420-enghighneering/projects-kicad/PRJ-003 - Mu-Tron Phasor II/#000-000 - Final Assembly/Untitled.png

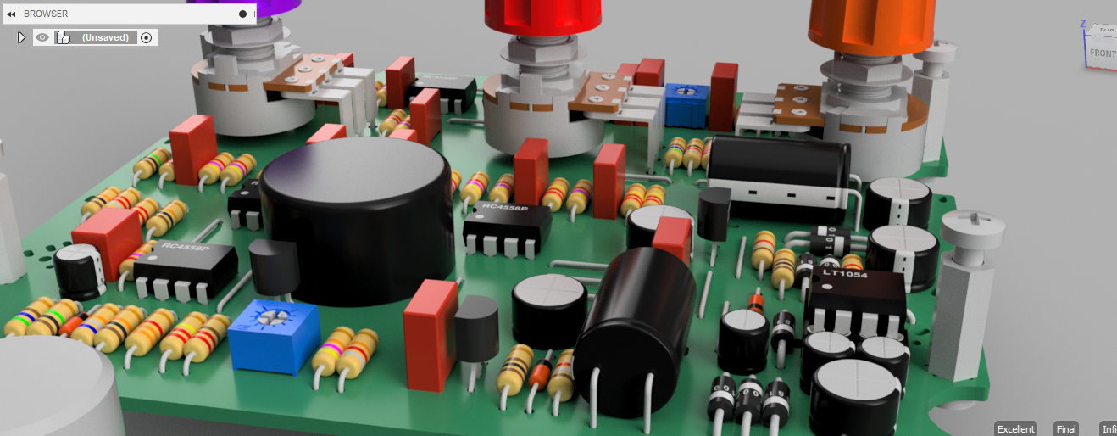
PRJ-003 - Mu-Tron Phasor II/#000-000 - Final Assembly/Untitled.png
