420-enghighneering/projects-kicad/PRJ-003 - Mu-Tron Phasor II/#000-000 - Final Assembly/#000-000 - Mu-Tron Phasor II - Manual Assembly v1.png

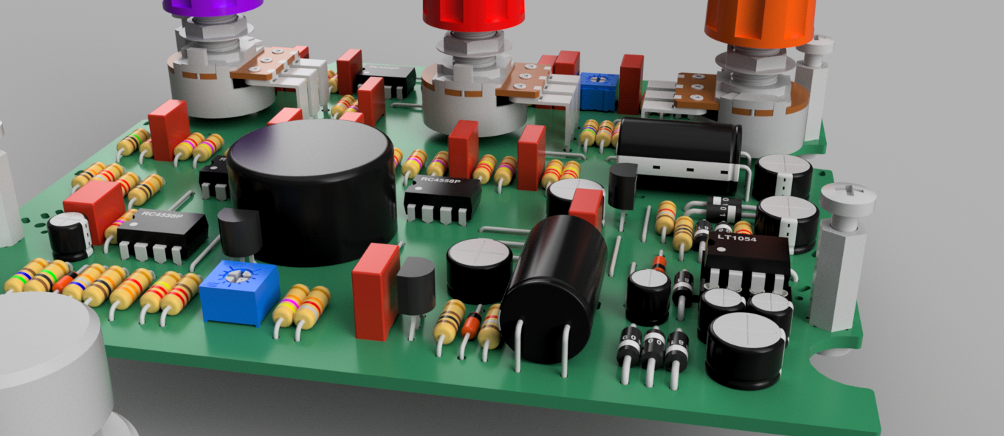
PRJ-003 - Mu-Tron Phasor II/#000-000 - Final Assembly/#000-000 - Mu-Tron Phasor II - Manual Assembly v1.png
