420-enghighneering/projects-kicad/PRJ-003 - Mu-Tron Phasor II/Documentation/#PRJ-003 - Mu-Tron Phasor II.tex

\documentclass[11pt,a4paper]{article}

\usepackage{pdfpages}

\title{\textbf{PRJ-003\\ Mu-Tron Phasor II}}

\begin{document}

\maketitle
\tableofcontents
\newpage

\section{}

\section{References}

\section{Research}

\includepdf[landscape=true]{./schematic.pdf}

\end{document}
