420-enghighneering/projects-kicad/PRJ-003 - Mu-Tron Phasor II/Documentation/#PRJ-003 - Mu-Tron Phasor II.pdf

# PRJ-003 Mu-Tron Phasor II

# November 24, 2019

# Contents

1 References | 2
2 Research | 2

1

# 1 References

# 2 Research

2

- 2 +
4558 XC5

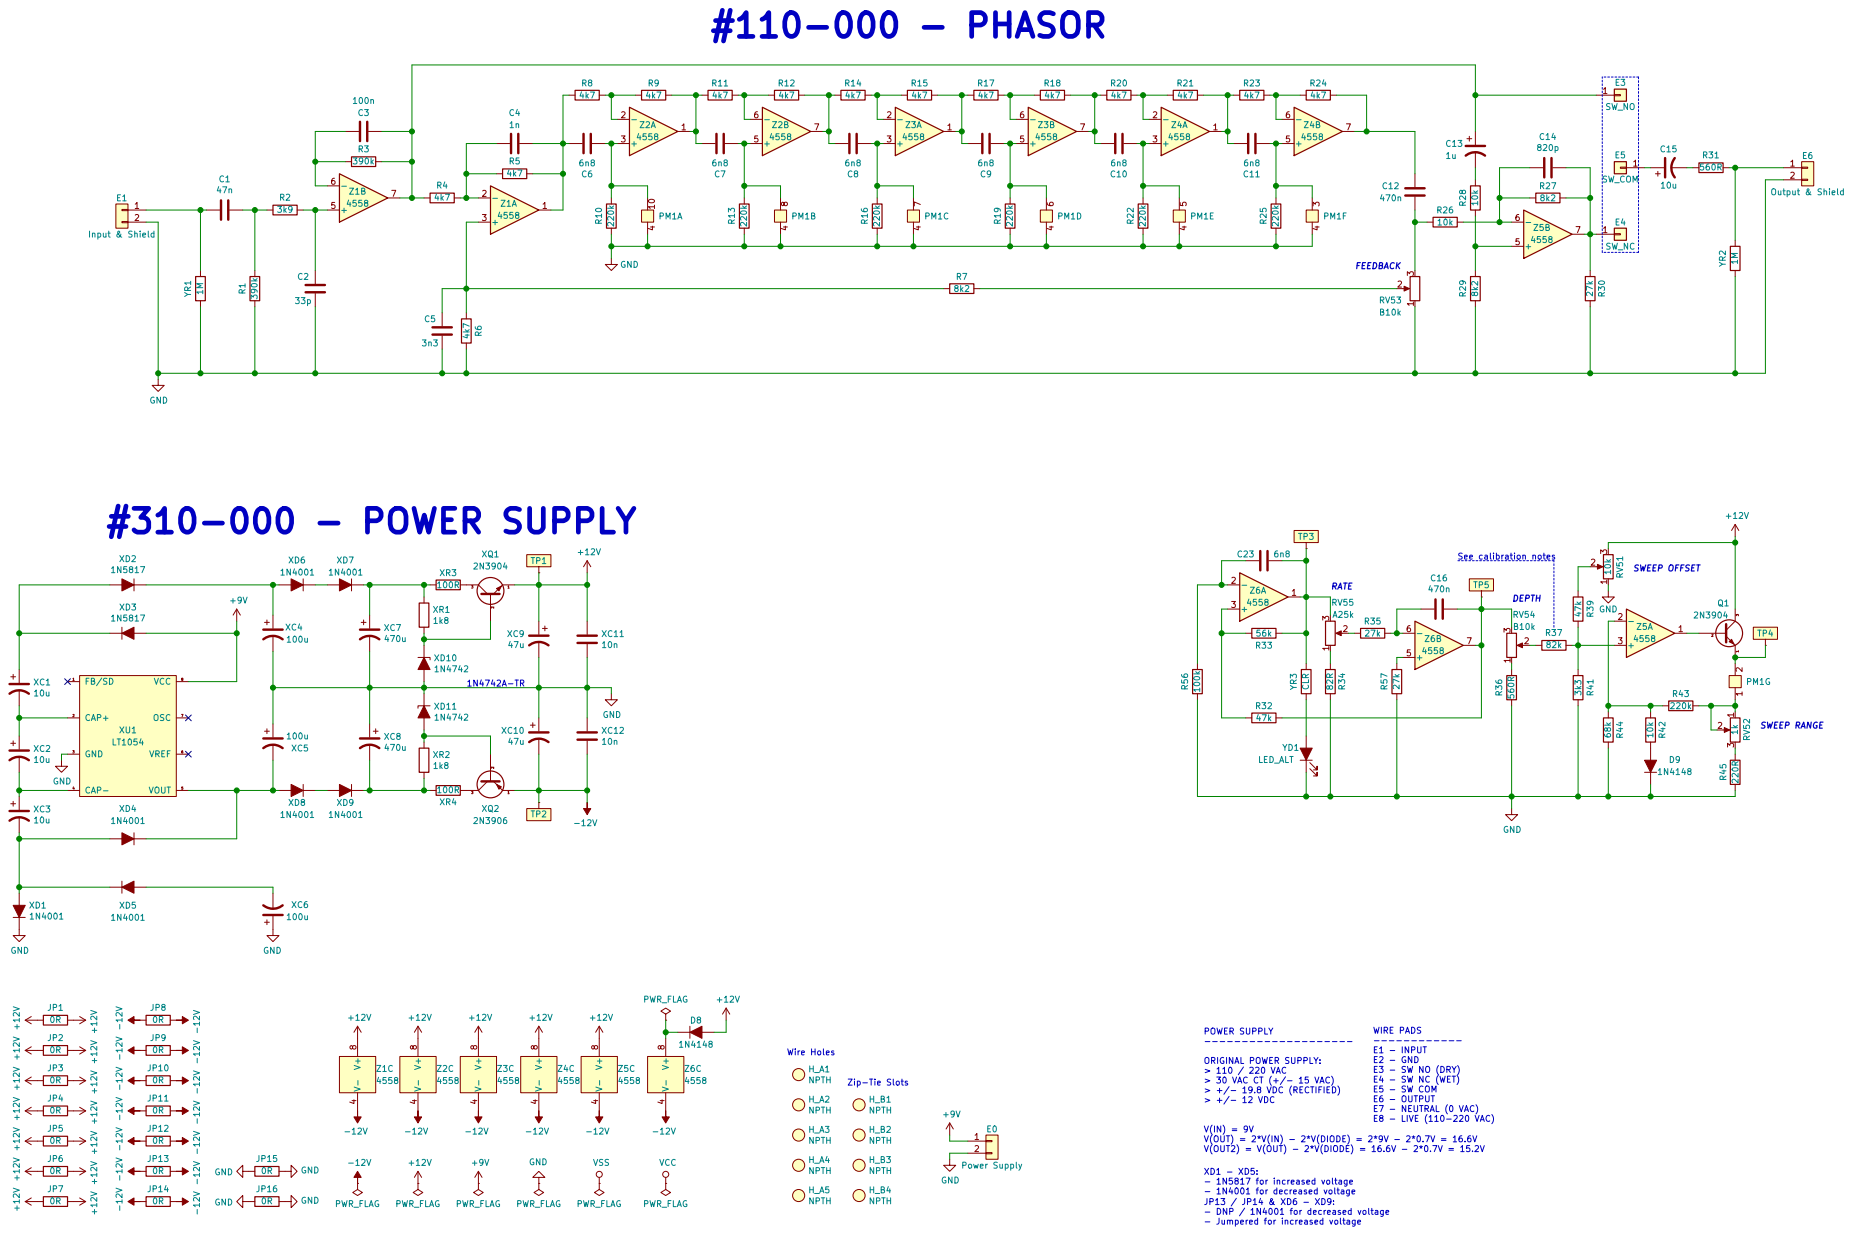
[picture p3: page 3]

- 1N4001 for decreased voltage Zip-Tie Slots #310-000 - POWER SUPPLY

-------------------- ORIGINAL POWER SUPPLY: > 110 / 220 VAC

E3 - SW NO (DRY) E4 - SW NC (WET) E5 - SW COM

> 30 VAC CT (+/- 15 VAC) > +/- 19.8 VDC (RECTIFIED) > +/- 12 VDC

- Jumpered for increased voltage XD1 - XD5: - 1N5817 for increased voltage

JP13 / JP14 & XD6 - XD9: - DNP / 1N4001 for decreased voltage
