420-enghighneering/projects-kicad/PRJ-003 - Mu-Tron Phasor II/Exports/#110-000-S1A - Phasor PCB.png

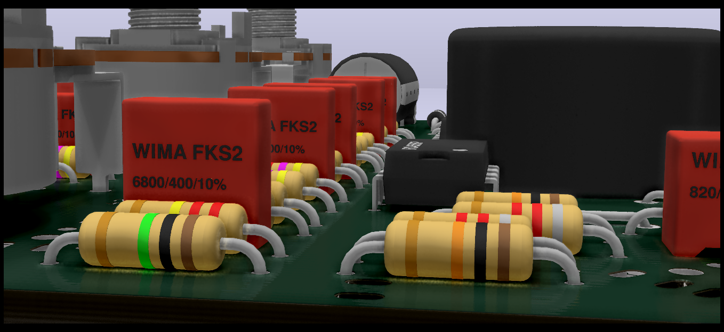
PRJ-003 - Mu-Tron Phasor II/Exports/#110-000-S1A - Phasor PCB.png
