420-enghighneering/projects-kicad/PRJ-003 - Mu-Tron Phasor II/Exports/assy2.png

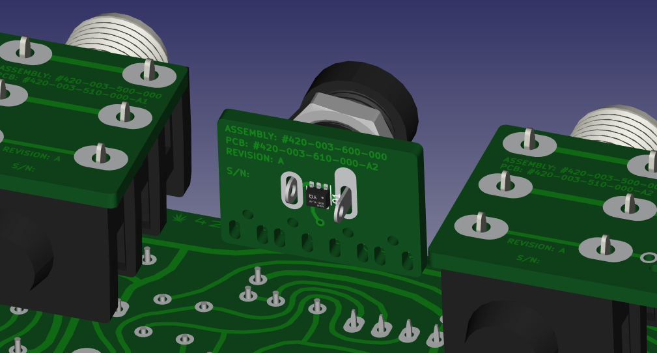
PRJ-003 - Mu-Tron Phasor II/Exports/assy2.png
