420-enghighneering/projects-kicad/PRJ-003 - Mu-Tron Phasor II/Exports/assy.png

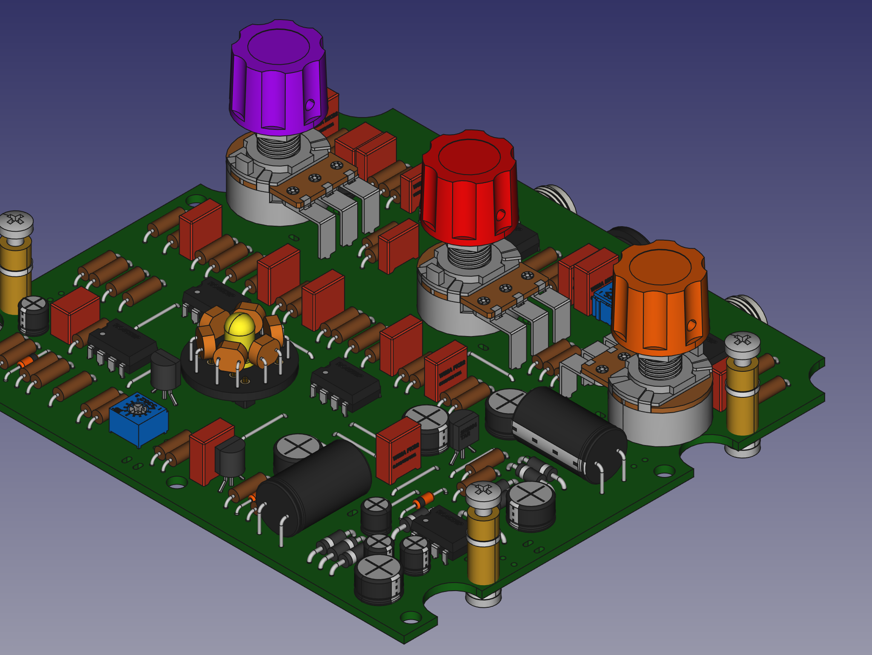
PRJ-003 - Mu-Tron Phasor II/Exports/assy.png
