420-enghighneering/projects-kicad/PRJ-003 - Mu-Tron Phasor II/Exports/clean/exp1.png

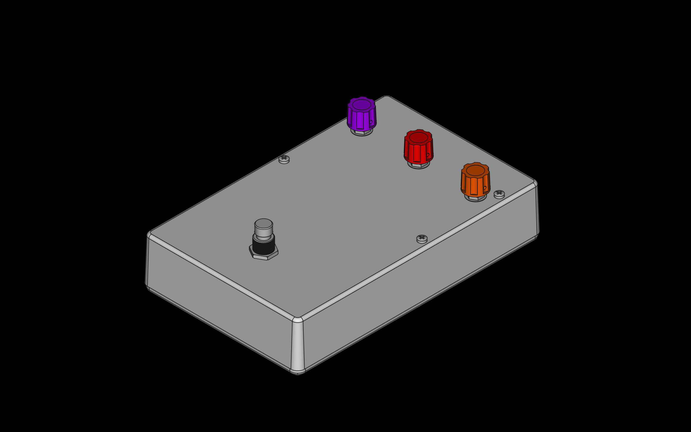
PRJ-003 - Mu-Tron Phasor II/Exports/clean/exp1.png
