420-enghighneering/projects-kicad/PRJ-003 - Mu-Tron Phasor II/Exports/clean/exp3.png

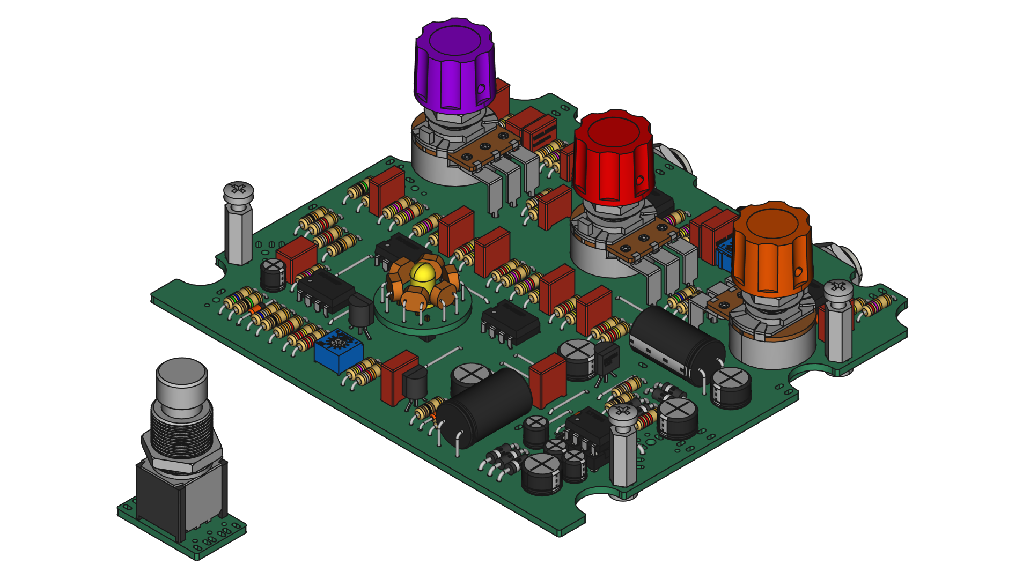
PRJ-003 - Mu-Tron Phasor II/Exports/clean/exp3.png
