420-enghighneering/projects-kicad/PRJ-003 - Mu-Tron Phasor II/Exports/clean/phray.png

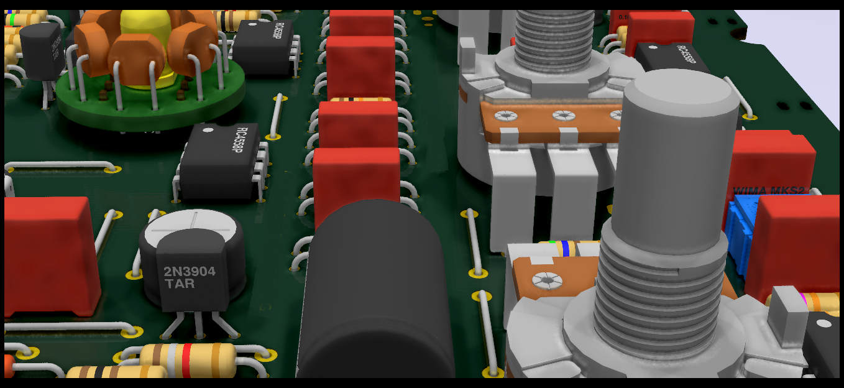
PRJ-003 - Mu-Tron Phasor II/Exports/clean/phray.png
