420-enghighneering/projects-kicad/PRJ-003 - Mu-Tron Phasor II/Exports/clean/r3.png

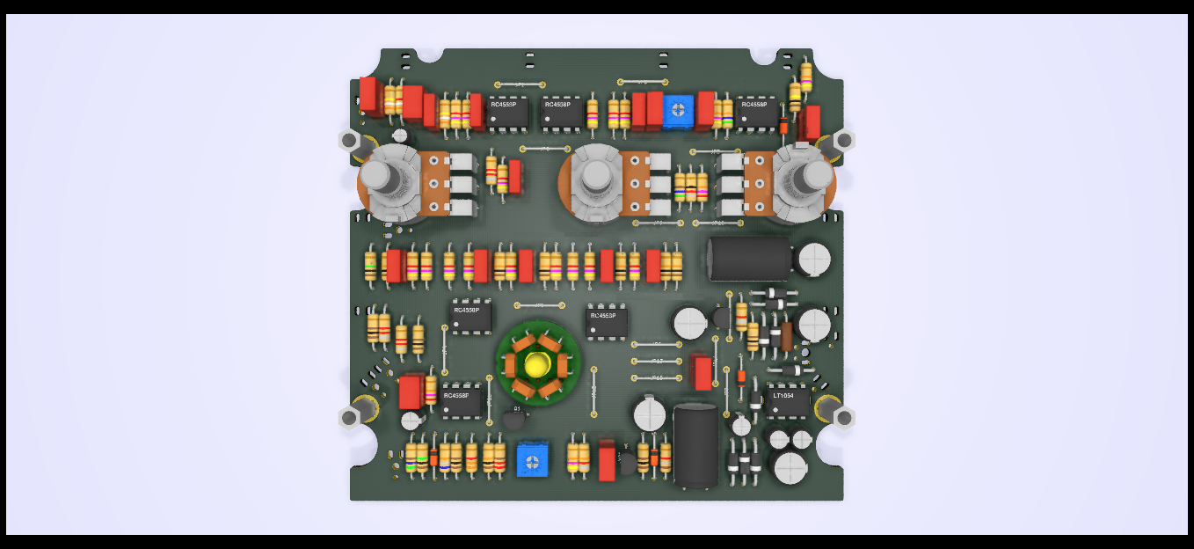
PRJ-003 - Mu-Tron Phasor II/Exports/clean/r3.png
