420-enghighneering/projects-kicad/PRJ-003 - Mu-Tron Phasor II/Exports/clean/tr.png

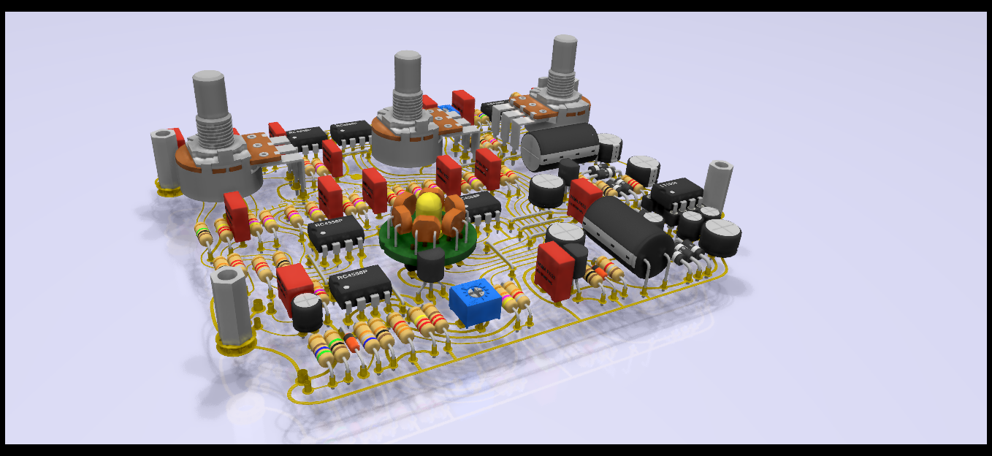
PRJ-003 - Mu-Tron Phasor II/Exports/clean/tr.png
