420-enghighneering/projects-kicad/PRJ-003 - Mu-Tron Phasor II/Exports/exo.png

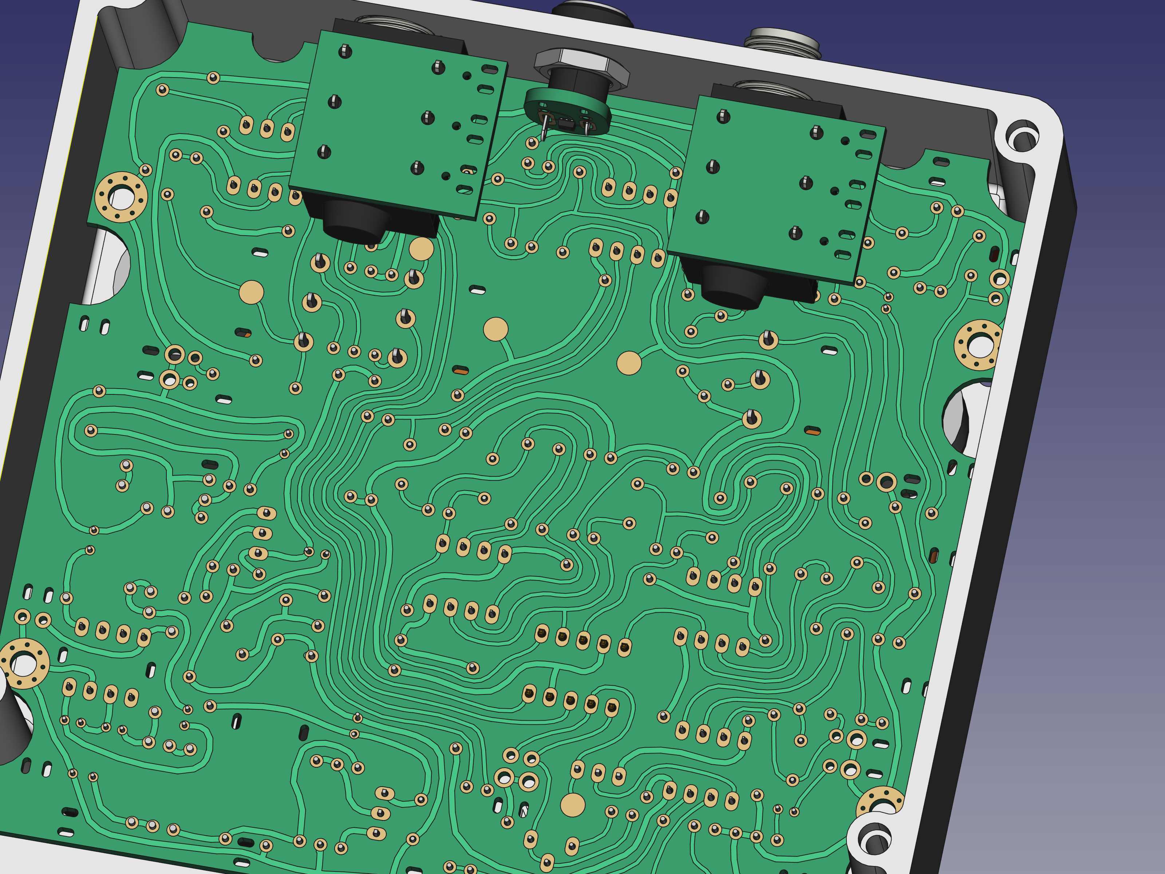
PRJ-003 - Mu-Tron Phasor II/Exports/exo.png
