420-enghighneering/projects-kicad/PRJ-003 - Mu-Tron Phasor II/Exports/exp4t.png

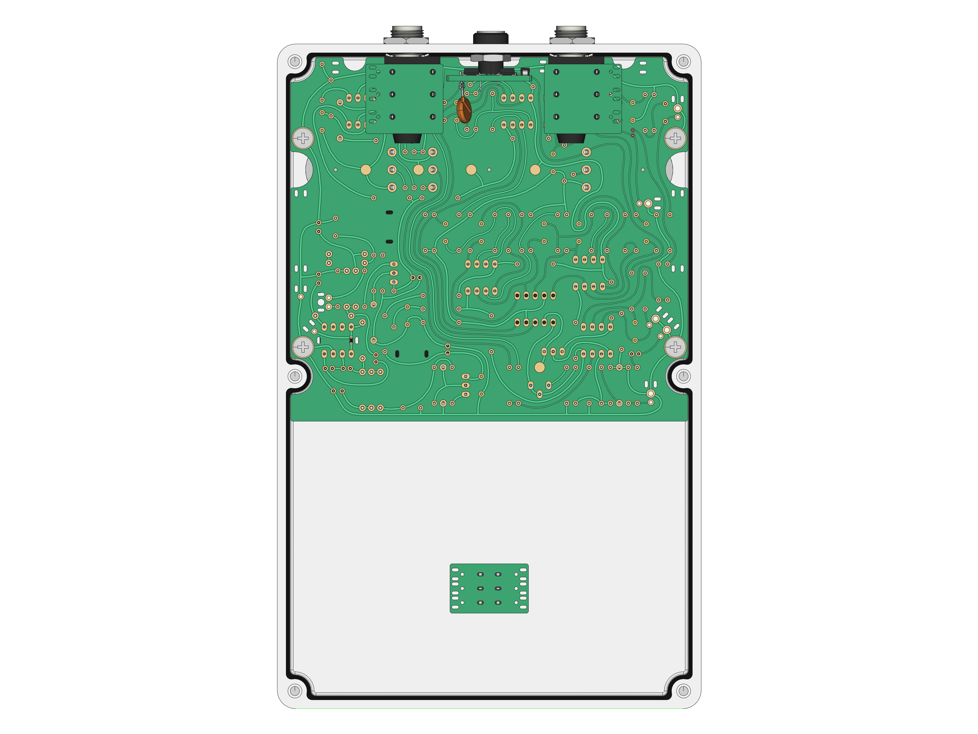
PRJ-003 - Mu-Tron Phasor II/Exports/exp4t.png
