420-enghighneering/projects-kicad/PRJ-003 - Mu-Tron Phasor II/Exports/purple hazor ii ray2.png

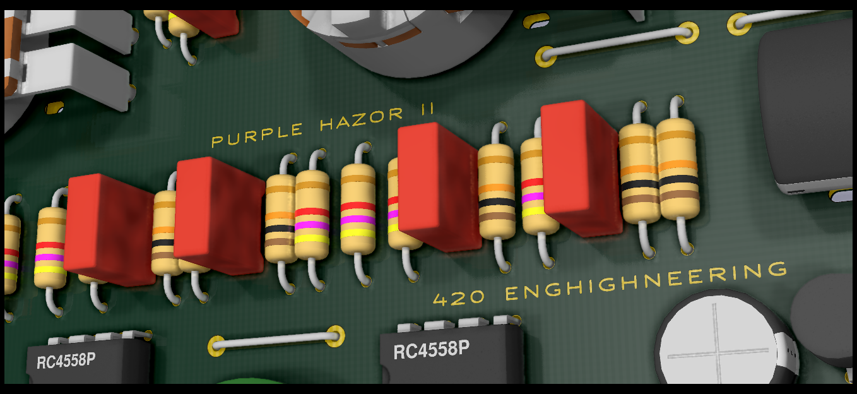
PRJ-003 - Mu-Tron Phasor II/Exports/purple hazor ii ray2.png
