420-enghighneering/projects-kicad/PRJ-003 - Mu-Tron Phasor II/Exports/ray1.png

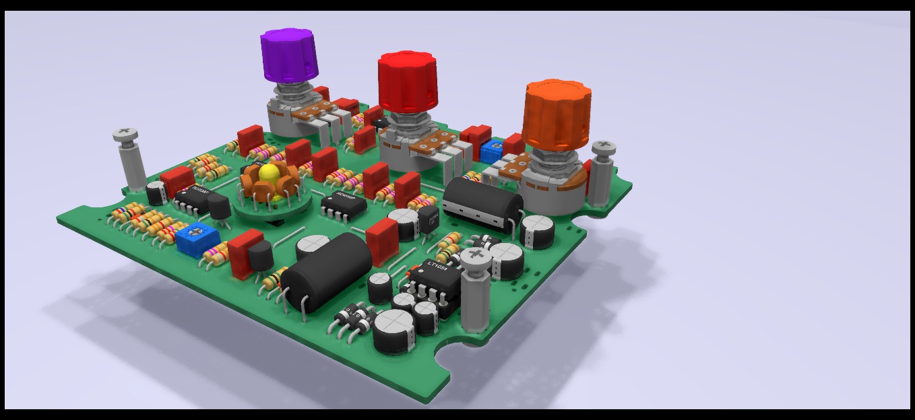
PRJ-003 - Mu-Tron Phasor II/Exports/ray1.png
