420-enghighneering/projects-kicad/PRJ-003 - Mu-Tron Phasor II/Exports/rayrender2.png

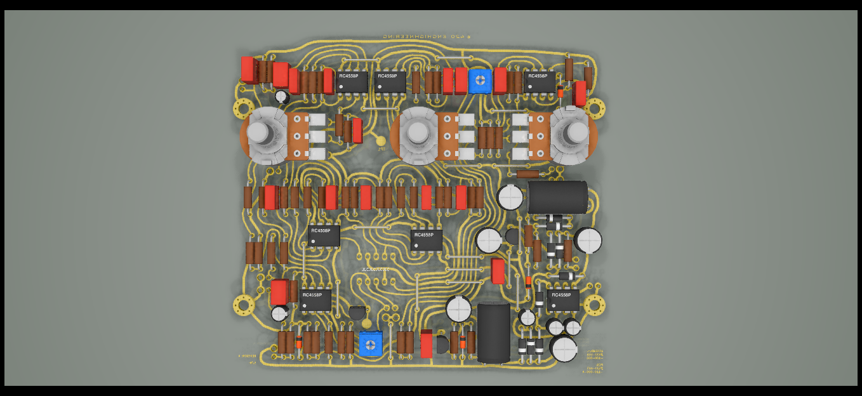
PRJ-003 - Mu-Tron Phasor II/Exports/rayrender2.png
