420-enghighneering/projects-kicad/PRJ-003 - Mu-Tron Phasor II/Exports/rayrender.png

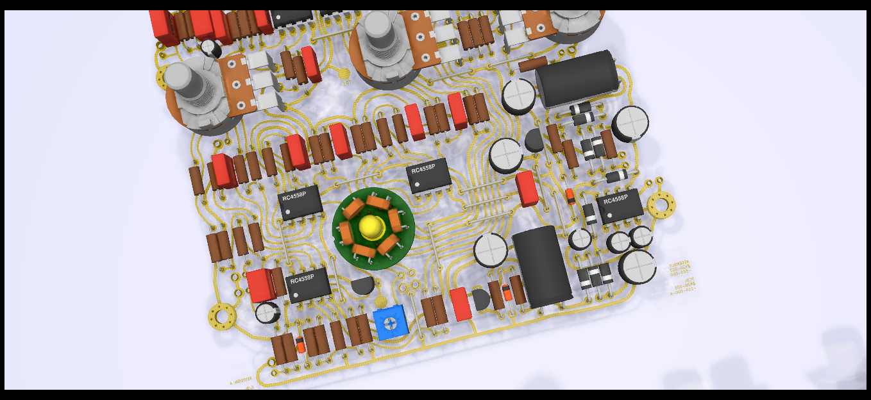
PRJ-003 - Mu-Tron Phasor II/Exports/rayrender.png
