420-enghighneering/projects-kicad/PRJ-003 - Mu-Tron Phasor II/References/$_1.jpg

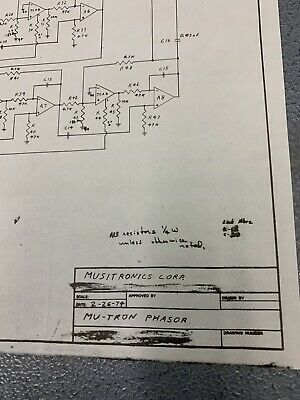
PRJ-003 - Mu-Tron Phasor II/References/$_1.jpg
