420-enghighneering/projects-kicad/PRJ-003 - Mu-Tron Phasor II/References/inverter1044-7660.png

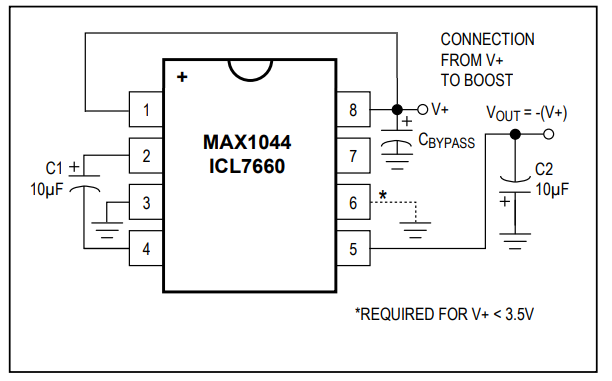
PRJ-003 - Mu-Tron Phasor II/References/inverter1044-7660.png
