420-enghighneering/projects-kicad/PRJ-003 - Mu-Tron Phasor II/References/inverter.png

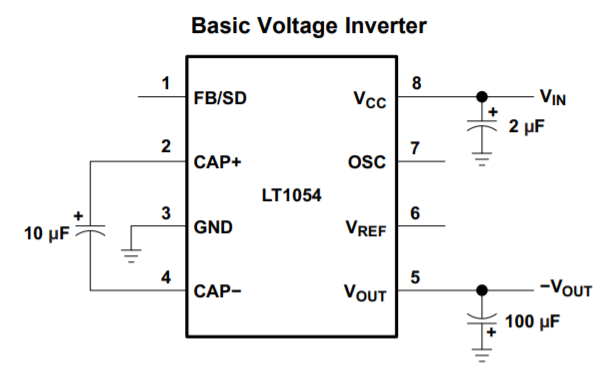
PRJ-003 - Mu-Tron Phasor II/References/inverter.png
