420-enghighneering/projects-kicad/PRJ-003 - Mu-Tron Phasor II/References/Mu-Tron Phasor II pg2.GIF

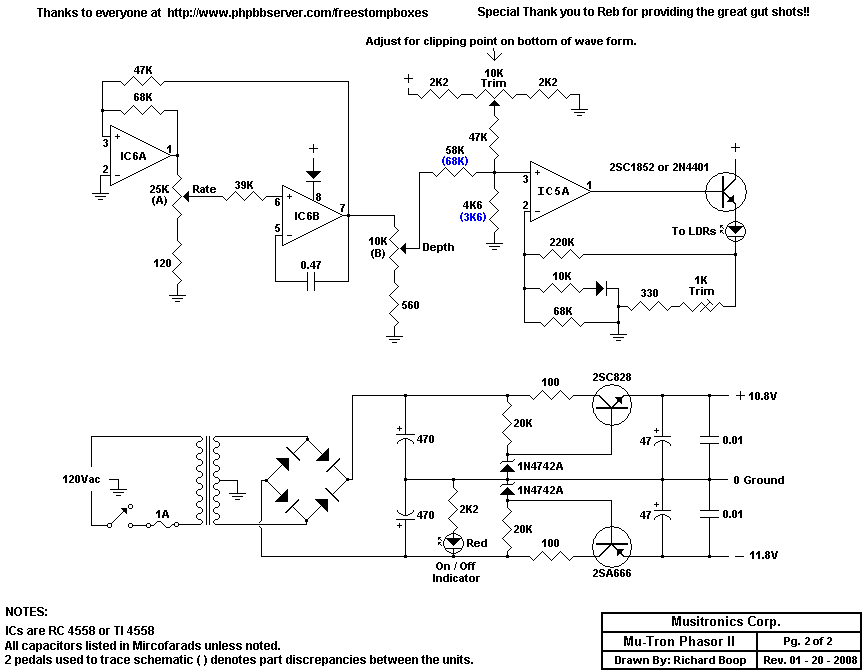
PRJ-003 - Mu-Tron Phasor II/References/Mu-Tron Phasor II pg2.GIF
