420-enghighneering/projects-kicad/PRJ-003 - Mu-Tron Phasor II/References/PCB Photos/1976/backboard.jpg

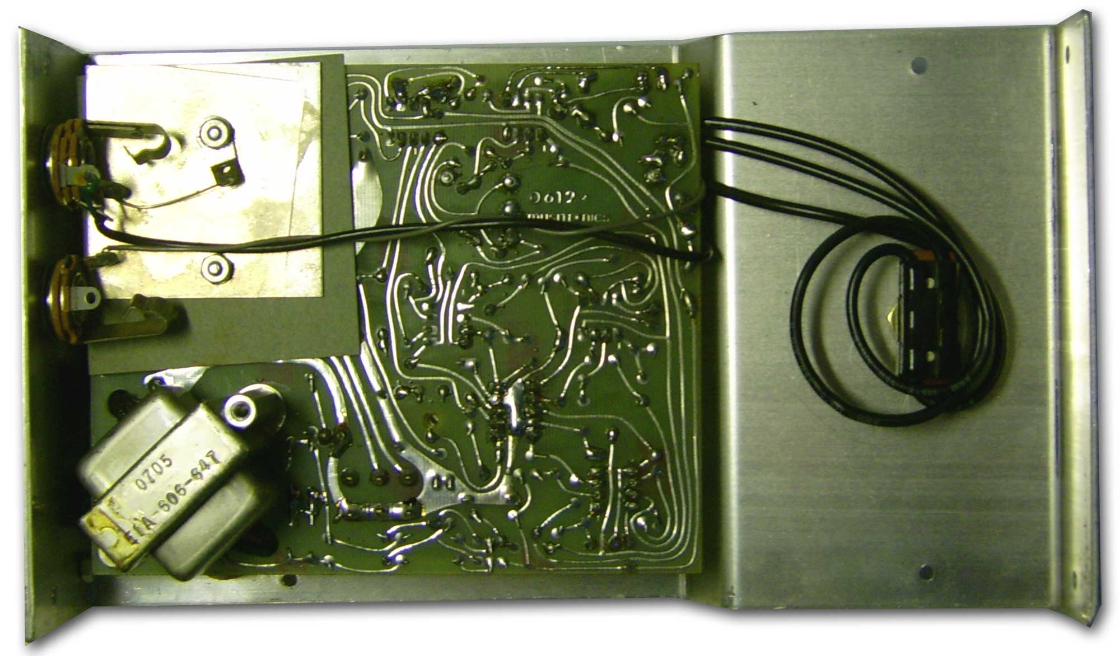
PRJ-003 - Mu-Tron Phasor II/References/PCB Photos/1976/backboard.jpg
