420-enghighneering/projects-kicad/PRJ-003 - Mu-Tron Phasor II/References/PCB Photos/1976/board.jpg

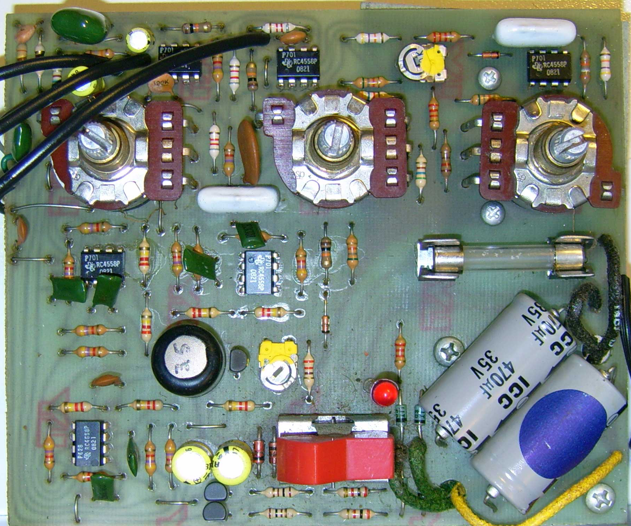
PRJ-003 - Mu-Tron Phasor II/References/PCB Photos/1976/board.jpg
