420-enghighneering/projects-kicad/PRJ-003 - Mu-Tron Phasor II/References/PCB Photos/1976/IMG_6587-Edit1_zpsd8938287.jpg

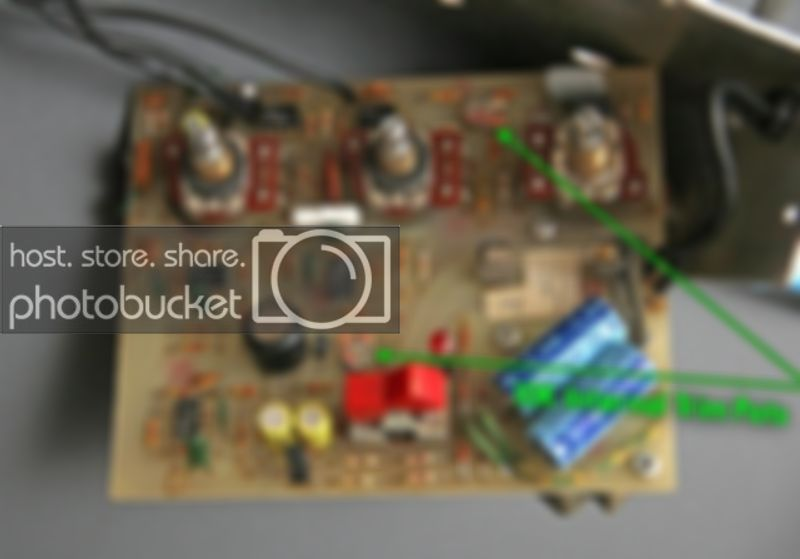
PRJ-003 - Mu-Tron Phasor II/References/PCB Photos/1976/IMG_6587-Edit1_zpsd8938287.jpg
