420-enghighneering/projects-kicad/PRJ-003 - Mu-Tron Phasor II/References/PCB Photos/1976/phase-2-mutron_sm3.jpg

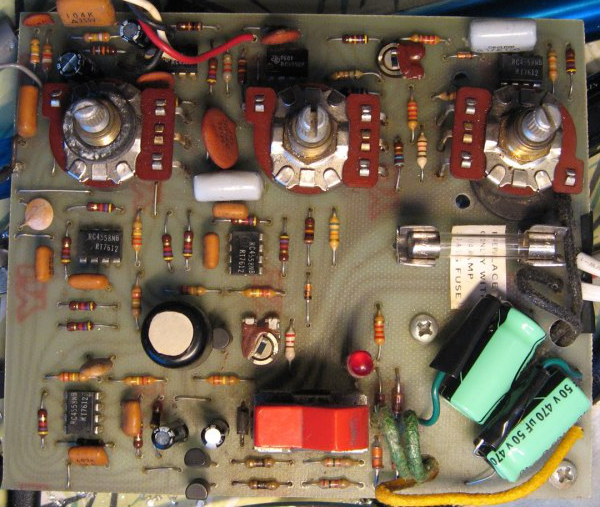
PRJ-003 - Mu-Tron Phasor II/References/PCB Photos/1976/phase-2-mutron_sm3.jpg
