420-enghighneering/projects-kicad/PRJ-003 - Mu-Tron Phasor II/References/PCB Photos/1979/Backside_Mirorred.png

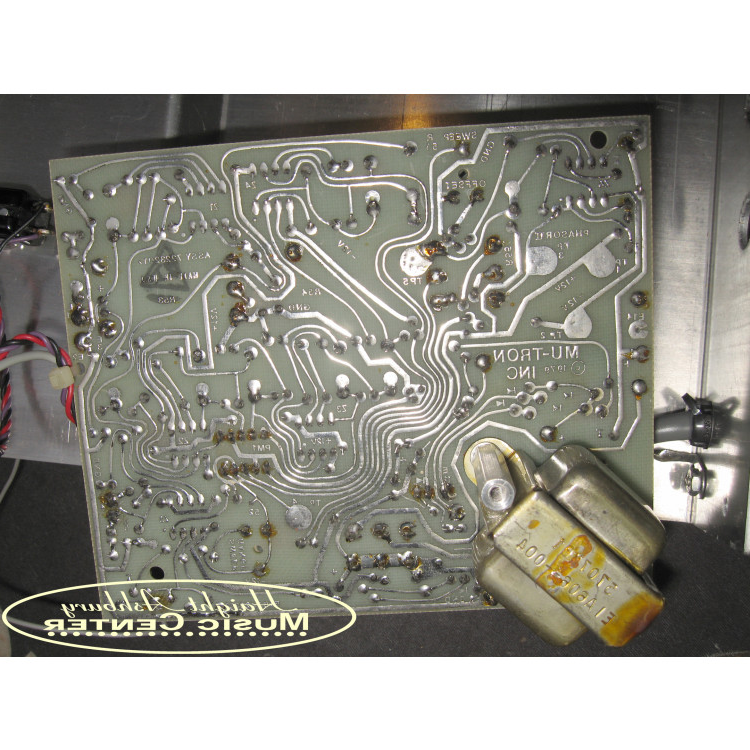
PRJ-003 - Mu-Tron Phasor II/References/PCB Photos/1979/Backside_Mirorred.png
