420-enghighneering/projects-kicad/PRJ-003 - Mu-Tron Phasor II/References/PCB Photos/1979/Board_Back.png

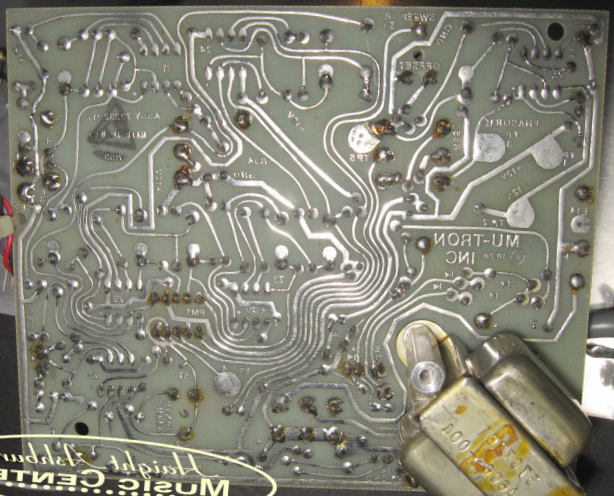
PRJ-003 - Mu-Tron Phasor II/References/PCB Photos/1979/Board_Back.png
