420-enghighneering/projects-kicad/PRJ-003 - Mu-Tron Phasor II/References/PCB Photos/1979/Different_Rev_Back.jpg

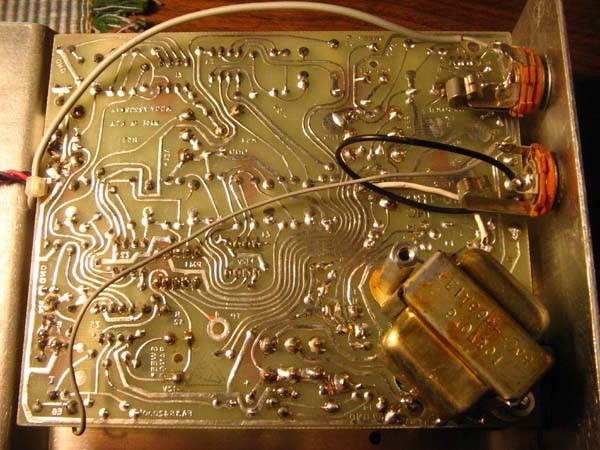
PRJ-003 - Mu-Tron Phasor II/References/PCB Photos/1979/Different_Rev_Back.jpg
