420-enghighneering/projects-kicad/PRJ-003 - Mu-Tron Phasor II/References/PCB Photos/1979/ph7.jpg

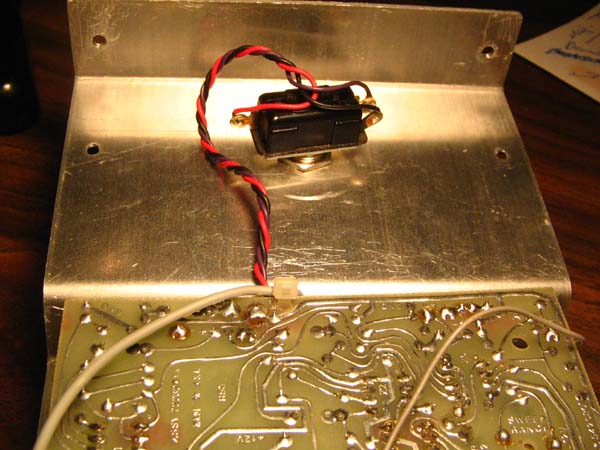
PRJ-003 - Mu-Tron Phasor II/References/PCB Photos/1979/ph7.jpg
