420-enghighneering/projects-kicad/PRJ-003 - Mu-Tron Phasor II/References/PCB Photos/board.jpg

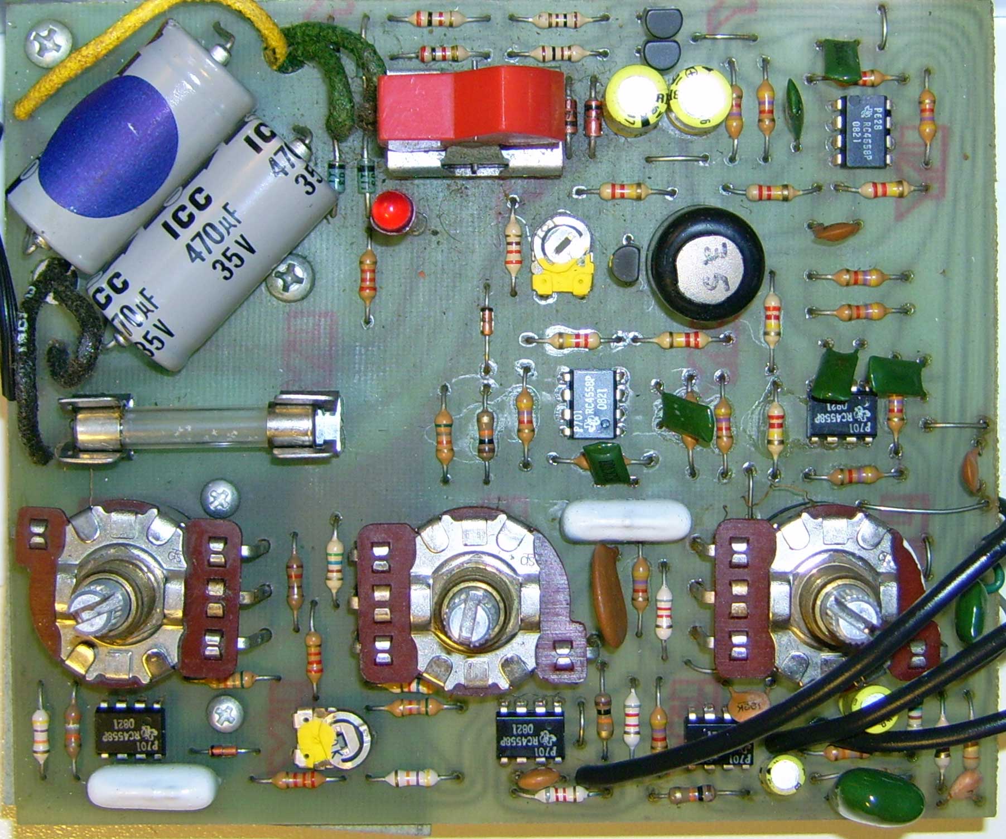
PRJ-003 - Mu-Tron Phasor II/References/PCB Photos/board.jpg
