420-enghighneering/projects-kicad/PRJ-003 - Mu-Tron Phasor II/References/PCB Photos/IMG_6576-1_zps1c8ed1f8.jpg

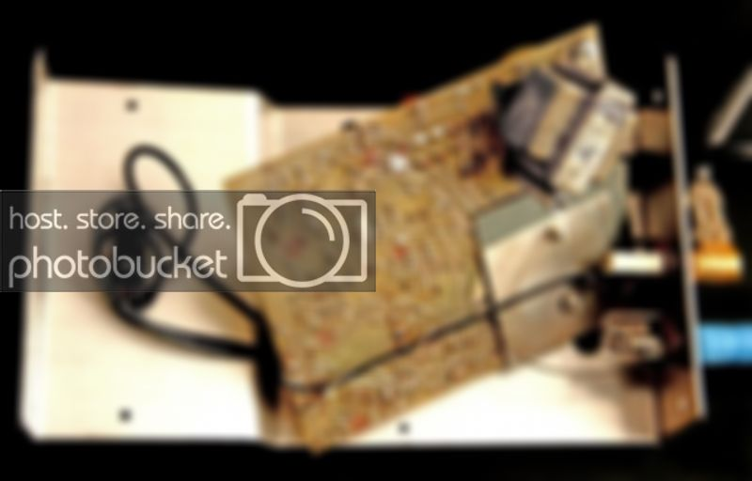
PRJ-003 - Mu-Tron Phasor II/References/PCB Photos/IMG_6576-1_zps1c8ed1f8.jpg
