420-enghighneering/projects-kicad/PRJ-003 - Mu-Tron Phasor II/References/PCB Photos/IMG_6580-Edit_zps70b65389.jpg

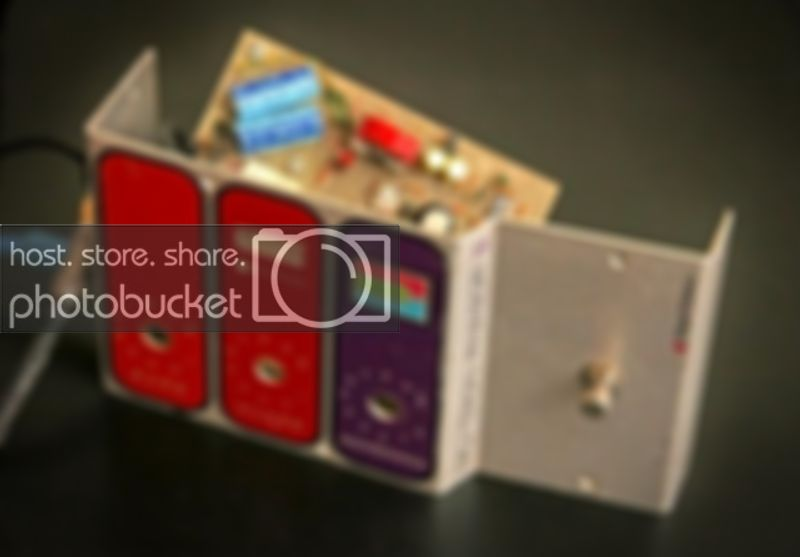
PRJ-003 - Mu-Tron Phasor II/References/PCB Photos/IMG_6580-Edit_zps70b65389.jpg
