420-enghighneering/projects-kicad/PRJ-003 - Mu-Tron Phasor II/References/PCB Photos/IMG_6589-Edit_zpse1e94481.jpg

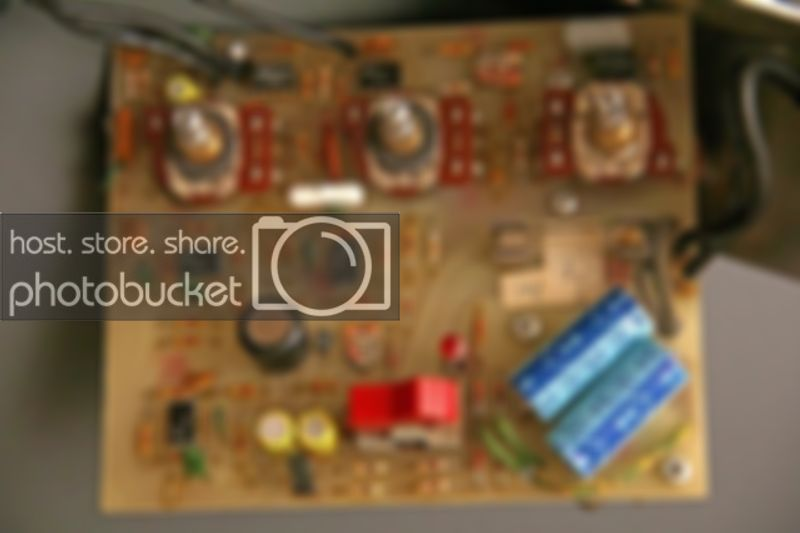
PRJ-003 - Mu-Tron Phasor II/References/PCB Photos/IMG_6589-Edit_zpse1e94481.jpg
