420-enghighneering/projects-kicad/PRJ-003 - Mu-Tron Phasor II/References/PCB Photos/mutron2.jpg

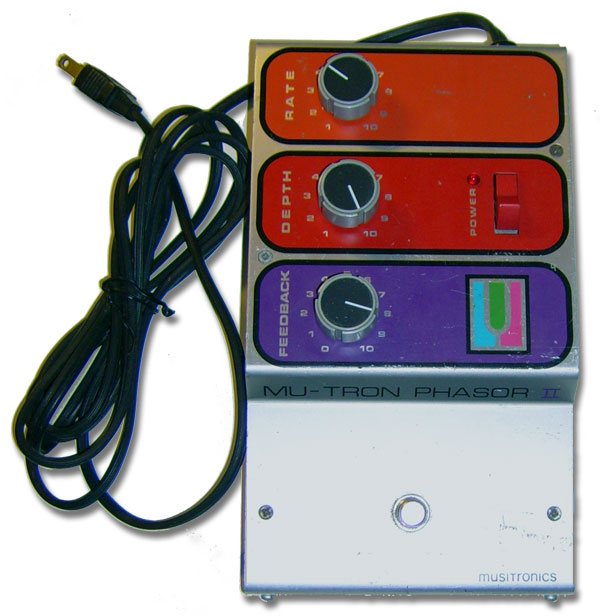
PRJ-003 - Mu-Tron Phasor II/References/PCB Photos/mutron2.jpg
