420-enghighneering/projects-kicad/PRJ-003 - Mu-Tron Phasor II/References/PCB Photos/open (1).jpg

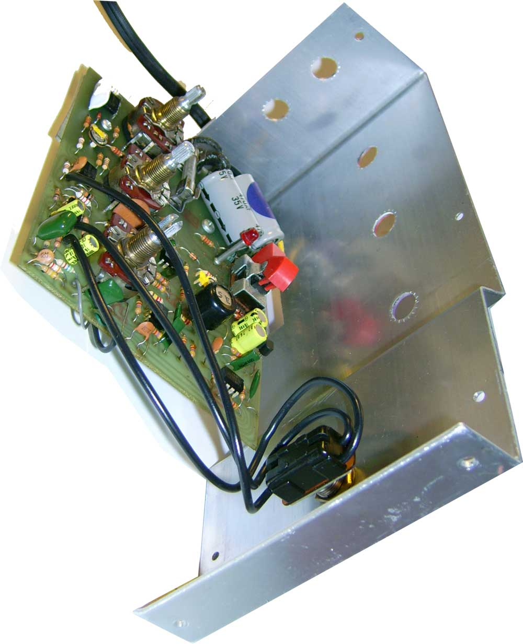
PRJ-003 - Mu-Tron Phasor II/References/PCB Photos/open (1).jpg
