420-enghighneering/projects-kicad/PRJ-003 - Mu-Tron Phasor II/References/PCB Photos/rear.jpg

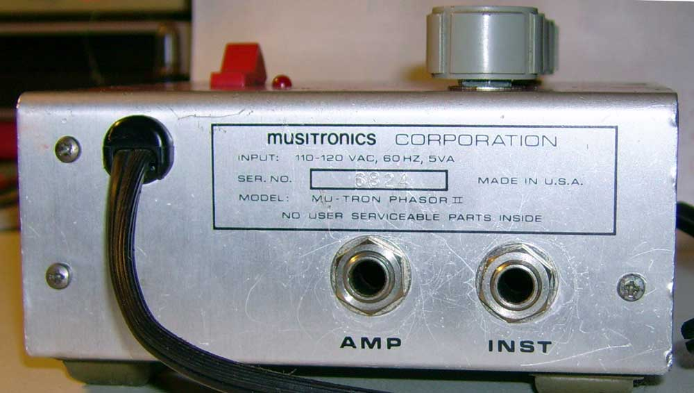
PRJ-003 - Mu-Tron Phasor II/References/PCB Photos/rear.jpg
