420-enghighneering/projects-kicad/PRJ-003 - Mu-Tron Phasor II/References/REF-001 - Extract Board Layout Cropped.png

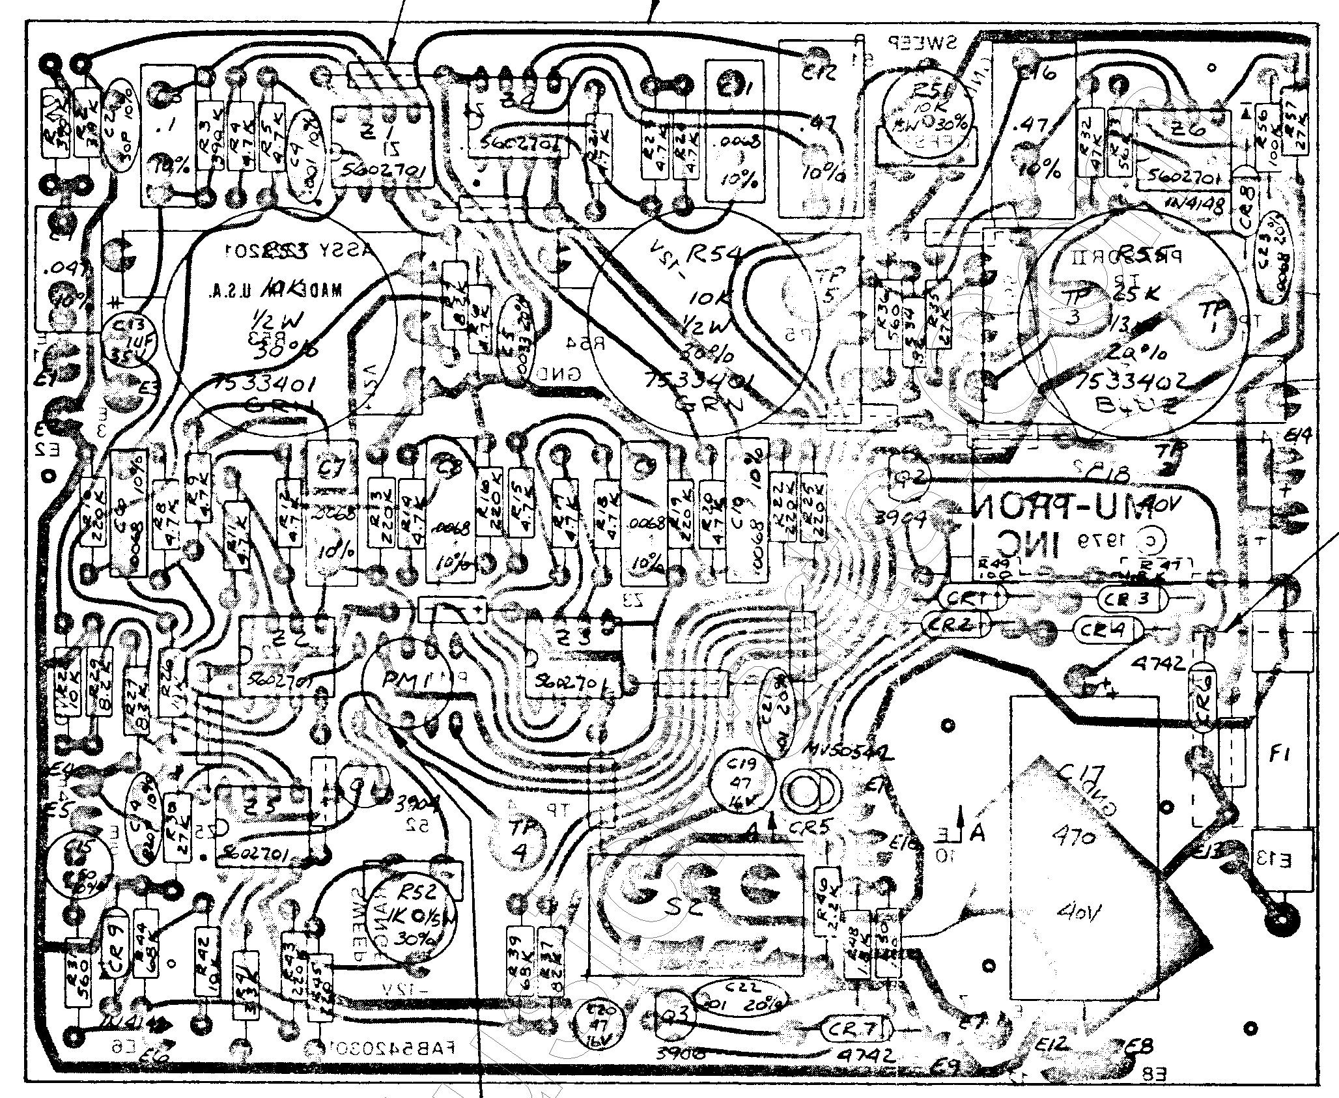
PRJ-003 - Mu-Tron Phasor II/References/REF-001 - Extract Board Layout Cropped.png
