420-enghighneering/projects-kicad/PRJ-003 - Mu-Tron Phasor II/References/REF-001 - Factory Schematic Cropped.png

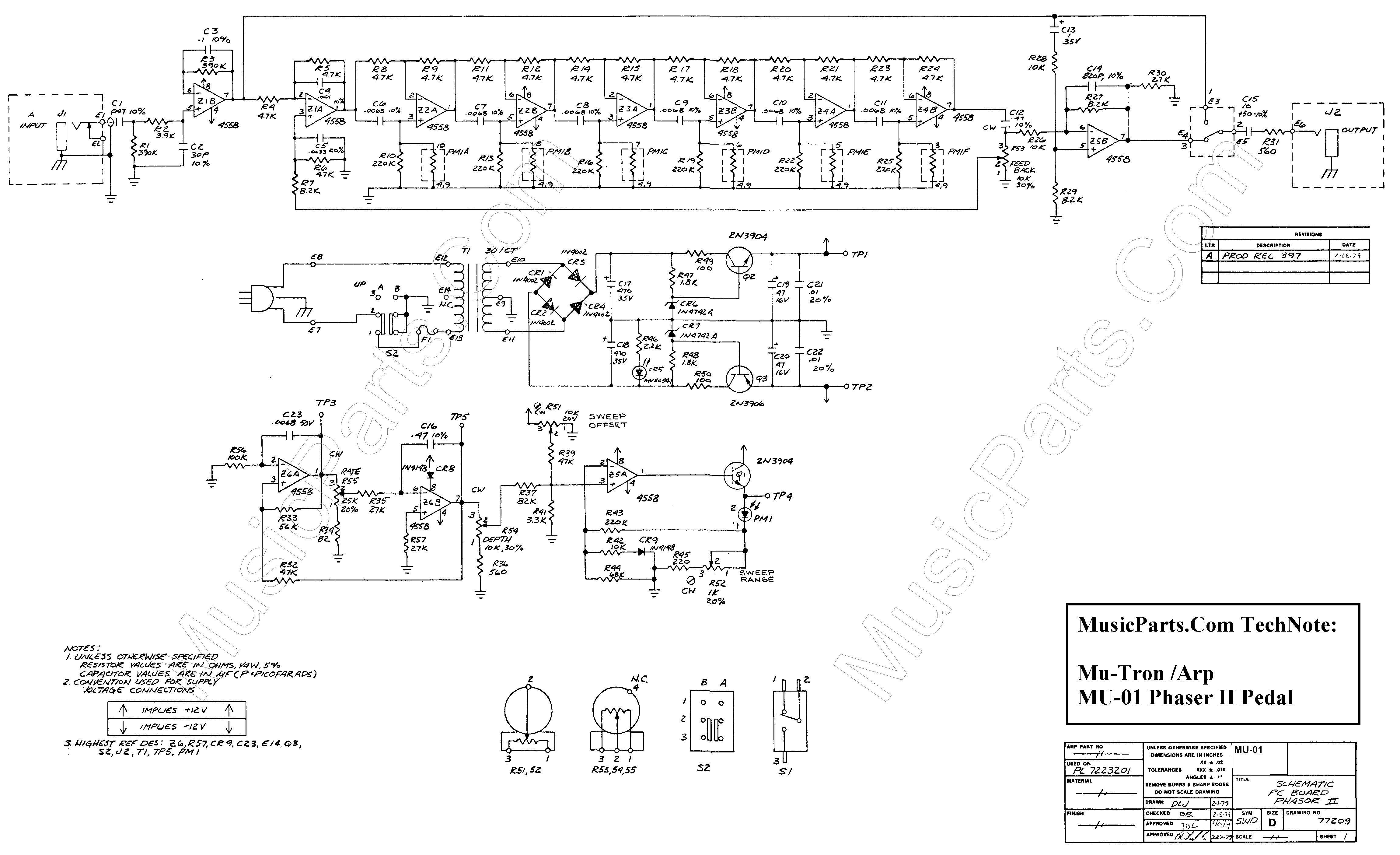
PRJ-003 - Mu-Tron Phasor II/References/REF-001 - Factory Schematic Cropped.png
