420-enghighneering/projects-kicad/PRJ-003 - Mu-Tron Phasor II/References/REF-009 - Tagboardeffects.com johnk Mu-Tron Phasor II Clone.jpg

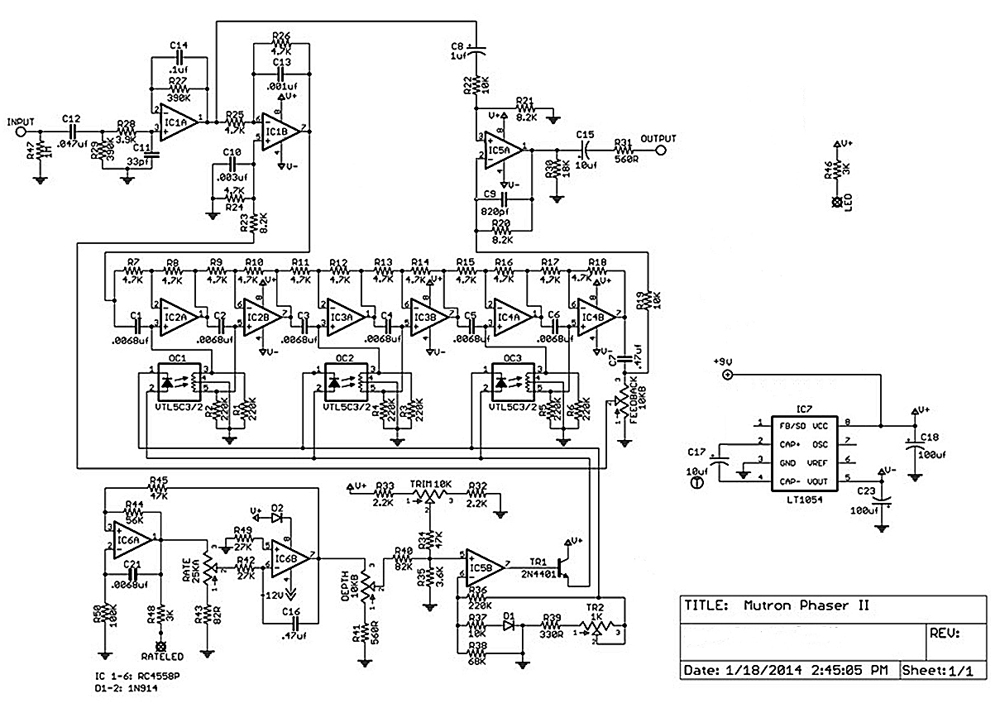
PRJ-003 - Mu-Tron Phasor II/References/REF-009 - Tagboardeffects.com johnk Mu-Tron Phasor II Clone.jpg
