420-enghighneering/projects-kicad/PRJ-003 - Mu-Tron Phasor II/References/s-l1600.jpg

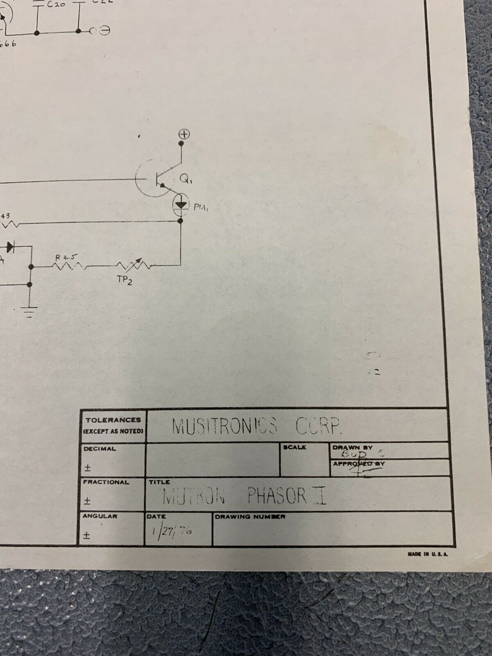
PRJ-003 - Mu-Tron Phasor II/References/s-l1600.jpg
