420-enghighneering/projects-kicad/PRJ-003 - Mu-Tron Phasor II/Archive - Pre-Project/Musitronics Mu-Tron II Phaser/Archive/Layout Test/LDR Section/myfields.xlsx

Refs | datasheet | footprint | value
C201 |  | SA_Capacitors_SMD:C_0603_1608M | 6n8
C202 |  | SA_Capacitors_SMD:C_0603_1608M | 6n8
C203 |  | SA_Capacitors_SMD:C_0603_1608M | 6n8
C204 |  | SA_Capacitors_SMD:C_0603_1608M | 6n8
C205 |  | SA_Capacitors_SMD:C_0603_1608M | 6n8
C206 |  | SA_Capacitors_SMD:C_0603_1608M | 6n8
J201 | ~ | SA_Connectors_Pin_Headers_THT:PinHeader_1x08_P2.54mm_Vertical_Bottom | Conn_01x08
J202 | ~ | SA_Connectors_Pin_Headers_THT:PinHeader_1x08_P2.54mm_Vertical_Bottom | Conn_01x08
J203 | ~ | Connector_PinHeader_1.27mm:PinHeader_1x03_P1.27mm_Vertical | Conn_01x03
J204 | ~ | Connector_PinHeader_1.27mm:PinHeader_1x03_P1.27mm_Vertical | Conn_01x03
J205 | ~ | Connector_PinHeader_1.27mm:PinHeader_1x03_P1.27mm_Vertical | Conn_01x03
J206 | ~ | Connector_PinHeader_1.27mm:PinHeader_1x02_P1.27mm_Vertical | Conn_01x02
LDR201 |  | SA_LDR_THT:R_LDR_5.1x4.3mm_P3.4mm_Vertical | KE-10720
LDR202 |  | SA_LDR_THT:R_LDR_5.1x4.3mm_P3.4mm_Vertical | KE-10720
LDR203 |  | SA_LDR_THT:R_LDR_5.1x4.3mm_P3.4mm_Vertical | KE-10720
LDR204 |  | SA_LDR_THT:R_LDR_5.1x4.3mm_P3.4mm_Vertical | KE-10720
LDR205 |  | SA_LDR_THT:R_LDR_5.1x4.3mm_P3.4mm_Vertical | KE-10720
LDR206 |  | SA_LDR_THT:R_LDR_5.1x4.3mm_P3.4mm_Vertical | KE-10720
R201 |  | SA_Resistors_SMD:R_0603_1608M | 220k
R202 |  | SA_Resistors_SMD:R_0603_1608M | 4k7
R203 |  | SA_Resistors_SMD:R_0603_1608M | 4k7
R204 |  | SA_Resistors_SMD:R_0603_1608M | 220k
R205 |  | SA_Resistors_SMD:R_0603_1608M | 4k7
R206 |  | SA_Resistors_SMD:R_0603_1608M | 4k7
R207 |  | SA_Resistors_SMD:R_0603_1608M | 220k
R208 |  | SA_Resistors_SMD:R_0603_1608M | 4k7
R209 |  | SA_Resistors_SMD:R_0603_1608M | 4k7
R210 |  | SA_Resistors_SMD:R_0603_1608M | 220k
R211 |  | SA_Resistors_SMD:R_0603_1608M | 4k7
R212 |  | SA_Resistors_SMD:R_0603_1608M | 4k7
R213 |  | SA_Resistors_SMD:R_0603_1608M | 220k
R214 |  | SA_Resistors_SMD:R_0603_1608M | 4k7
R215 |  | SA_Resistors_SMD:R_0603_1608M | 4k7
R216 |  | SA_Resistors_SMD:R_0603_1608M | 220k
R217 |  | SA_Resistors_SMD:R_0603_1608M | 4k7
R218 |  | SA_Resistors_SMD:R_0603_1608M | 4k7
U201 |  | SA_Packages:SOIC-8_3.9x4.9mm_P1.27mm | TL072
U202 |  | SA_Packages:SOIC-8_3.9x4.9mm_P1.27mm | TL072
U203 |  | SA_Packages:SOIC-8_3.9x4.9mm_P1.27mm | TL072
