420-enghighneering/projects-kicad/PRJ-003 - Mu-Tron Phasor II/#000-000 - Final Assembly/#000-000 - Mu-Tron Phasor II - ASM3 Spreadsheet/#100-000 - Phasor PCB Assembly.FCStd

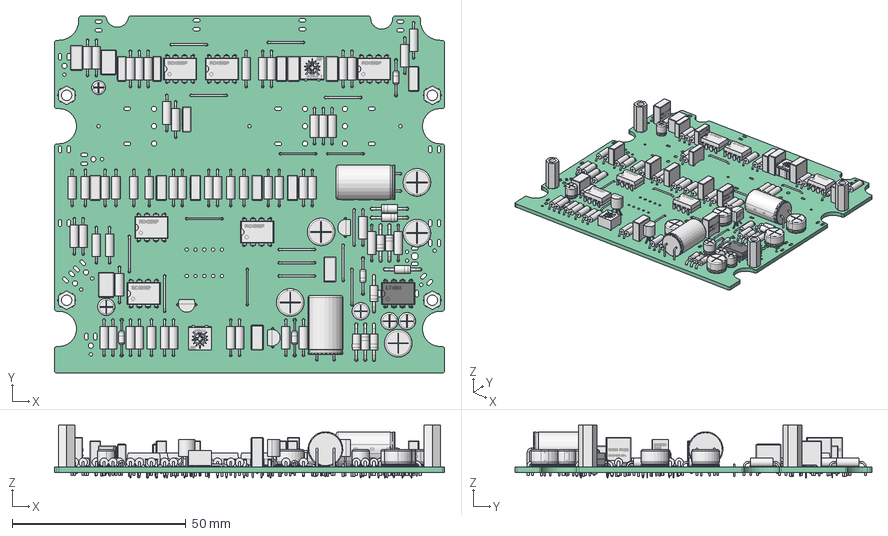
[picture p61: CAD file, 2021-03-29]
PRJ-003 - Mu-Tron Phasor II/#000-000 - Final Assembly/#000-000 - Mu-Tron Phasor II - ASM3 Spreadsheet/#100-000 - Phasor PCB Assembly.FCStd
112.4 x 102.9 x 15.2 mm
Pcb_3323
"Z6"_RC4558P_5E32D110 x 6
"XR5"_R_CC25_P10.16_H_5E176B90 x 52
"JP16"_R_0R_Wire_Jumper_P10.16_5D8DF354 x 16
"XU1"_LT1054_5DC00D2F
"RV52"_Bourns_3362P_5D8A0BC8 x 2
"XD11"_DO-35_P10.16_5DC00C72 x 4
"XC10"_Nichicon_UMA_Straight_D8_H5_P2.5_d0.45_LL2.6_5DC00BE9 x 2
"XC12"_FKS2G021001C00KSSD_5DC00BFC x 2
"XC8"_Capacitor_Electrolytic_THT_Radial_Angled_D10_H17_P5_d0.6_h1.5_LL2.6_5E35ED22 x 2
"C14"_FKP2J008201D00HSSD_5D8C32AA
"C2"_FKP2O100331D00JSSD_5DED6ED0
"XC6"_Nichicon_UMA_Straight_D8_H5_P2.5_d0.45_LL2.6_5DCF4B87 x 3
"XC3"_Nichicon_UMA_Straight_D5_H5_P2_d0.45_LL2.6_5DC00C0A x 4
"C13"_Nichicon_UMA_Straight_D4_H5_P1.5_d0.45_LL2.6_5D8A0658
"XQ2"_2N3904TAR_5DC00CE5 x 3
"XD1"_DO-41_P10.16_5DC00CBD x 9
"C23"_FKS2G016801B00KSSD_5E2EB71B x 7
"C16"_MKS2C034701C00KSSD_5D8A0691 x 2
"C5"_FKS2G013301A00KSSD_5D8A05C0
"C4"_FKS2G011001A00KSSD_5D8A05AD
"C3"_MKS2C031001A00KSSD_5D8A059A
"C1"_MKS2F024701C00KSSD_5DED55F5
"XJP1"_R_0603_1608M_5E0F142D
"H_A6"_Hex_Spacer_FF_M3x12_FF4.7_5DE407FA x 4
