420-enghighneering/projects-kicad/PRJ-003 - Mu-Tron Phasor II/#110-000 - Phasor PCB/Design History/F/#110-000 Assembly3.FCStd

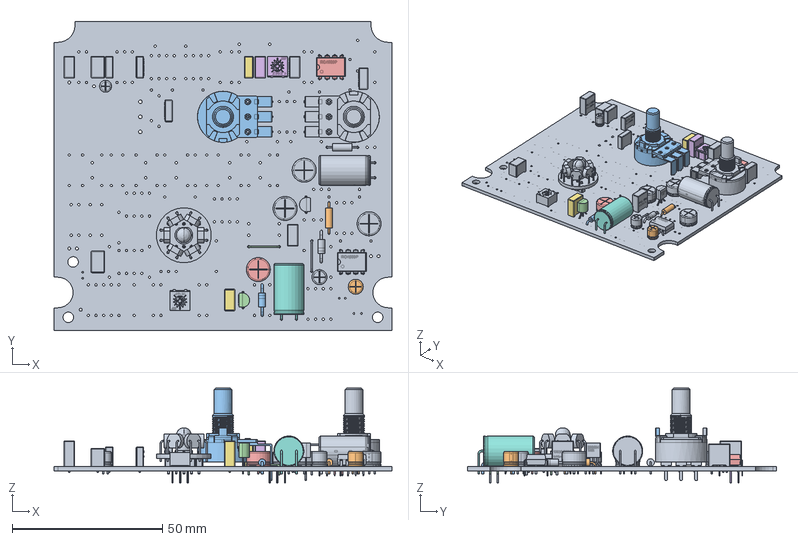
[picture p62: CAD file, 2021-03-29]
PRJ-003 - Mu-Tron Phasor II/#110-000 - Phasor PCB/Design History/F/#110-000 Assembly3.FCStd
112.4 x 102.9 x 31.5 mm
Pcb_sp
XR5_R_CC25_P10.16_H_5DD3C33E
RV55_Alpha_RV16AF-41-15R-XXX_5DD3C757
JP20_R_0R_Wire_Jumper_P10.16_5DC277DA
XC7_Nichicon_UMA_Straight_D8_H5_P2.5_d0.45_LL2.6_5DC00BE9
RV52_User_Library_3362P_2_sp_5D8A0BC8
XC8_FKS2G021001C00KSSD_5DC00BFC
XC6_Capacitor_Electrolytic_THT_Radial_Angled_D10_H17_P5_d0.6_h1.5_LL2.6_5DC00BE2
XC12_Nichicon_UMA_Straight_D8_H5_P2.5_d0.45_LL2.6_5DCF4B87
XC10_Nichicon_UMA_Straight_D5_H5_P2_d0.45_LL2.6_5DC00C0A
XD6_DO-41_P10.16_5DC00C72
XQ2_2N3904TAR_5DC00CE5
XU1_RC4558P_5DC00D2F
C16_MKS2C034701C00KSSD_5D8A0691
C23_FKS2G016801B00KSSD_5DD3B7C2
