420-enghighneering/projects-kicad/PRJ-003 - Mu-Tron Phasor II/#000-000 - Final Assembly/#000-000 - Mu-Tron Phasor II - ASM3 Spreadsheet/#000-000 - Mu-Tron Phasor II - ASM3 Assembly.FCStd

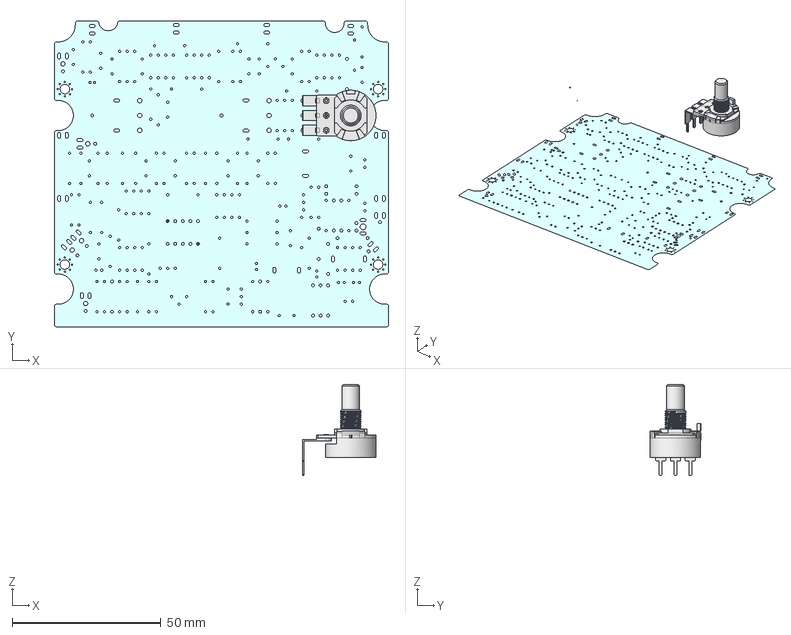
[picture p63: CAD file, 2021-03-29]
PRJ-003 - Mu-Tron Phasor II/#000-000 - Final Assembly/#000-000 - Mu-Tron Phasor II - ASM3 Spreadsheet/#000-000 - Mu-Tron Phasor II - ASM3 Assembly.FCStd
112.4 x 102.9 x 64.7 mm
Element002
Element003
Element004
"RV55"_Alpha_RV16AF-41-15R-XXX_5DD3C757
