420-enghighneering/projects-kicad/PRJ-003 - Mu-Tron Phasor II/#000-000 - Final Assembly/#000-000 - Mu-Tron Phasor II - ASM3 Spreadsheet/#200-000 - Photomodule PCB Assembly.FCStd

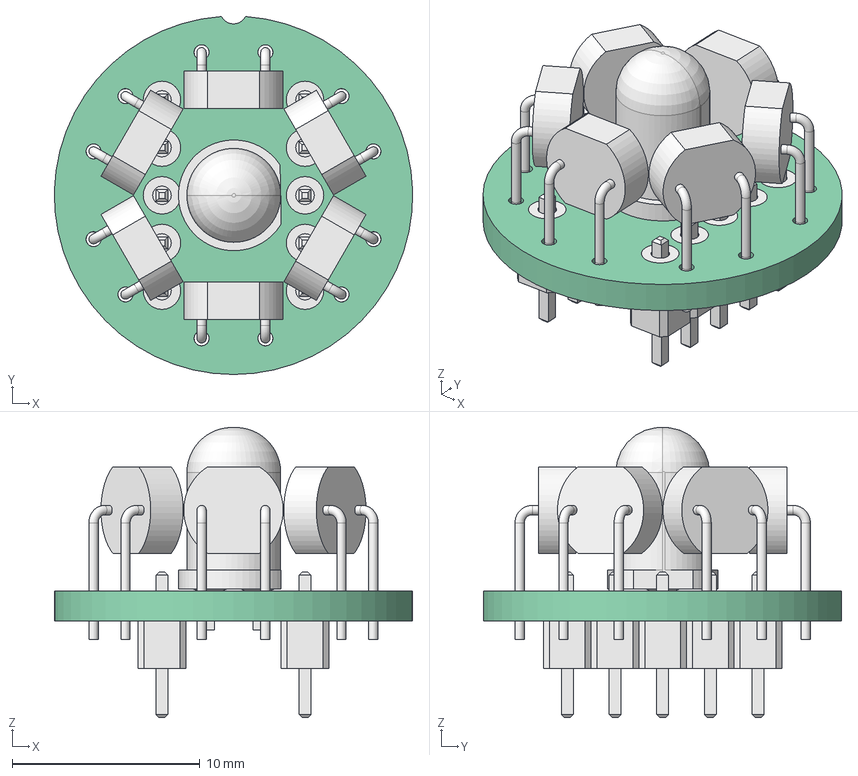
[picture p64: CAD file, 2021-03-29]
PRJ-003 - Mu-Tron Phasor II/#000-000 - Final Assembly/#000-000 - Mu-Tron Phasor II - ASM3 Spreadsheet/#200-000 - Photomodule PCB Assembly.FCStd
19.1 x 19.1 x 15.5 mm
Pcb_9fc9
topTracks_9fc9
botTracks_9fc9
D1_Cut_5D8C8806
LDR6_Waitrony_KE-10720_5D8C8254 x 6
J2_Pin_Header_Straight_01x05_ShortPins005_cp_5DBF3AB1 x 2
