420-enghighneering/projects-kicad/PRJ-003 - Mu-Tron Phasor II/#000-000 - Final Assembly/#000-000 - Mu-Tron Phasor II - STEP VRML Spreadsheet.FCStd

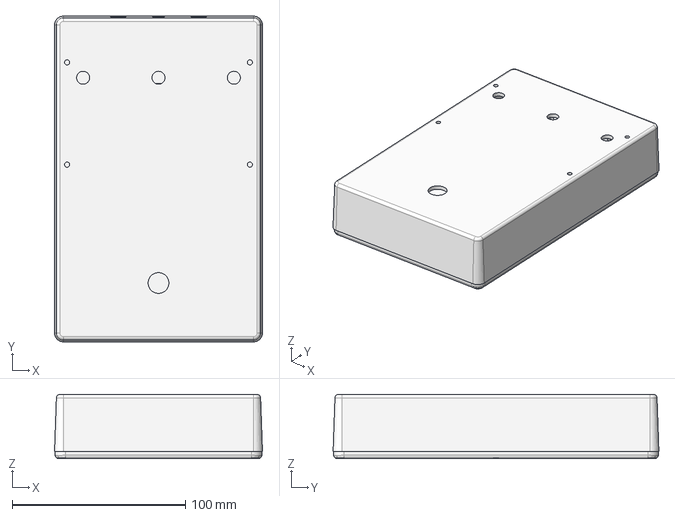
[picture p65: CAD file, 2021-03-29]
PRJ-003 - Mu-Tron Phasor II/#000-000 - Final Assembly/#000-000 - Mu-Tron Phasor II - STEP VRML Spreadsheet.FCStd
120.0 x 188.0 x 37.0 mm
#700-000 - Enclosure - Lid & Screws, Fusion
#700-000 - Enclosure - Box, Drilled
