420-enghighneering/projects-kicad/PRJ-003 - Mu-Tron Phasor II/#110-000 - Phasor PCB/Design History/E/#110-000-1590DD-OUTLINE.dxf

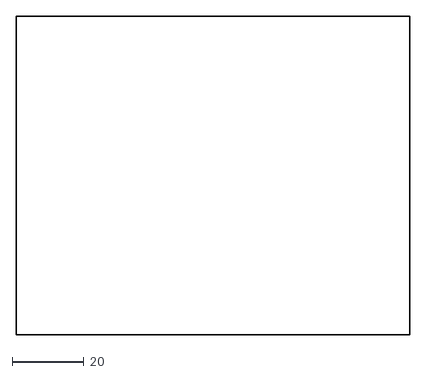
[picture p66: CAD file, 2021-03-29]
PRJ-003 - Mu-Tron Phasor II/#110-000 - Phasor PCB/Design History/E/#110-000-1590DD-OUTLINE.dxf
110.0 x 89.0
