420-enghighneering/projects-kicad/PRJ-003 - Mu-Tron Phasor II/#200-000 - Photomodule PCB Assembly/#200-000-A - Photomodule [LDRs]/#200-000-A - Photomodule [LDRs].step

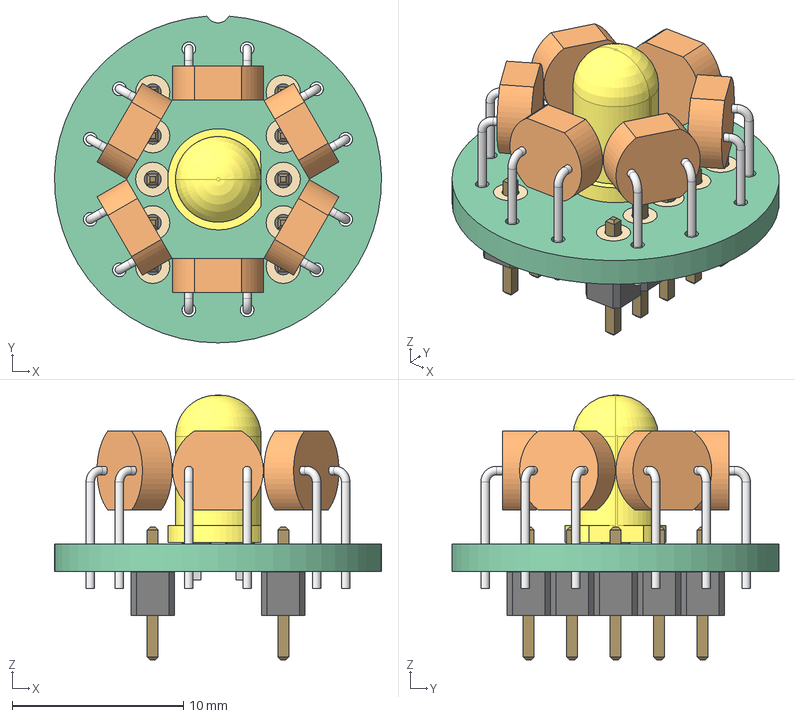
[picture p67: CAD file, 2021-03-29]
PRJ-003 - Mu-Tron Phasor II/#200-000 - Photomodule PCB Assembly/#200-000-A - Photomodule [LDRs]/#200-000-A - Photomodule [LDRs].step
19.1 x 19.1 x 15.5 mm
_210_000_A___Photomodule__LDRs__cp
_210_000_A___Photomodule__LDRs__cp001
_210_000_A___Photomodule__LDRs__cp002
_210_000_A___Photomodule__LDRs__cp003
_210_000_A___Photomodule__LDRs__cp004
_210_000_A___Photomodule__LDRs__cp005
_210_000_A___Photomodule__LDRs__cp006
_210_000_A___Photomodule__LDRs__cp007
_210_000_A___Photomodule__LDRs__cp008
_210_000_A___Photomodule__LDRs__cp009
_210_000_A___Photomodule__LDRs__cp010
_210_000_A___Photomodule__LDRs__cp011
_210_000_A___Photomodule__LDRs__cp012
_210_000_A___Photomodule__LDRs__cp013
_210_000_A___Photomodule__LDRs__cp014
_210_000_A___Photomodule__LDRs__cp015
_210_000_A___Photomodule__LDRs__cp016
_210_000_A___Photomodule__LDRs__cp017
_210_000_A___Photomodule__LDRs__cp018
_210_000_A___Photomodule__LDRs__cp019
_210_000_A___Photomodule__LDRs__cp020
_210_000_A___Photomodule__LDRs__cp021
_210_000_A___Photomodule__LDRs__cp022
_210_000_A___Photomodule__LDRs__cp023
_210_000_A___Photomodule__LDRs__cp024
_210_000_A___Photomodule__LDRs__cp025
_210_000_A___Photomodule__LDRs__cp026
_210_000_A___Photomodule__LDRs__cp027
_210_000_A___Photomodule__LDRs__cp028
_210_000_A___Photomodule__LDRs__cp029
_210_000_A___Photomodule__LDRs__cp030
_210_000_A___Photomodule__LDRs__cp031
_210_000_A___Photomodule__LDRs__cp032
_210_000_A___Photomodule__LDRs__cp033
_210_000_A___Photomodule__LDRs__cp034
_210_000_A___Photomodule__LDRs__cp035
_210_000_A___Photomodule__LDRs__cp036
_210_000_A___Photomodule__LDRs__cp037
_210_000_A___Photomodule__LDRs__cp038
_210_000_A___Photomodule__LDRs__cp039
_210_000_A___Photomodule__LDRs__cp040
_210_000_A___Photomodule__LDRs__cp041
_210_000_A___Photomodule__LDRs__cp042
_210_000_A___Photomodule__LDRs__cp043
_210_000_A___Photomodule__LDRs__cp044
_210_000_A___Photomodule__LDRs__cp045
_210_000_A___Photomodule__LDRs__cp046
_210_000_A___Photomodule__LDRs__cp047
_210_000_A___Photomodule__LDRs__cp048
_210_000_A___Photomodule__LDRs__cp049
_210_000_A___Photomodule__LDRs__cp050
_210_000_A___Photomodule__LDRs__cp051
_210_000_A___Photomodule__LDRs__cp052
_210_000_A___Photomodule__LDRs__cp053
_210_000_A___Photomodule__LDRs__cp054
_210_000_A___Photomodule__LDRs__cp055
_210_000_A___Photomodule__LDRs__cp056
_210_000_A___Photomodule__LDRs__cp057
_210_000_A___Photomodule__LDRs__cp058
_210_000_A___Photomodule__LDRs__cp059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
