420-enghighneering/projects-kicad/PRJ-003 - Mu-Tron Phasor II/#210-000 - Photomodule PCB/#210-000-S1A - Photomodule PCB [LDRs]/#210-000-S1A - Photomodule PCB [LDRs] - KiExpAlignedCut.step

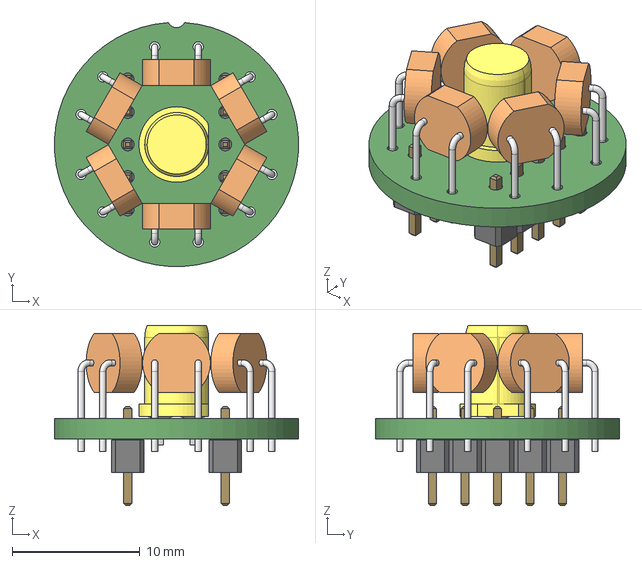
[picture p68: CAD file, 2021-03-29]
PRJ-003 - Mu-Tron Phasor II/#210-000 - Photomodule PCB/#210-000-S1A - Photomodule PCB [LDRs]/#210-000-S1A - Photomodule PCB [LDRs] - KiExpAlignedCut.step
19.1 x 19.1 x 14.1 mm
