420-enghighneering/projects-kicad/PRJ-003 - Mu-Tron Phasor II/#210-000 - Photomodule PCB/#210-000-S2A - Photomodule [Vactrols]/Photomodule - Vactrols.step

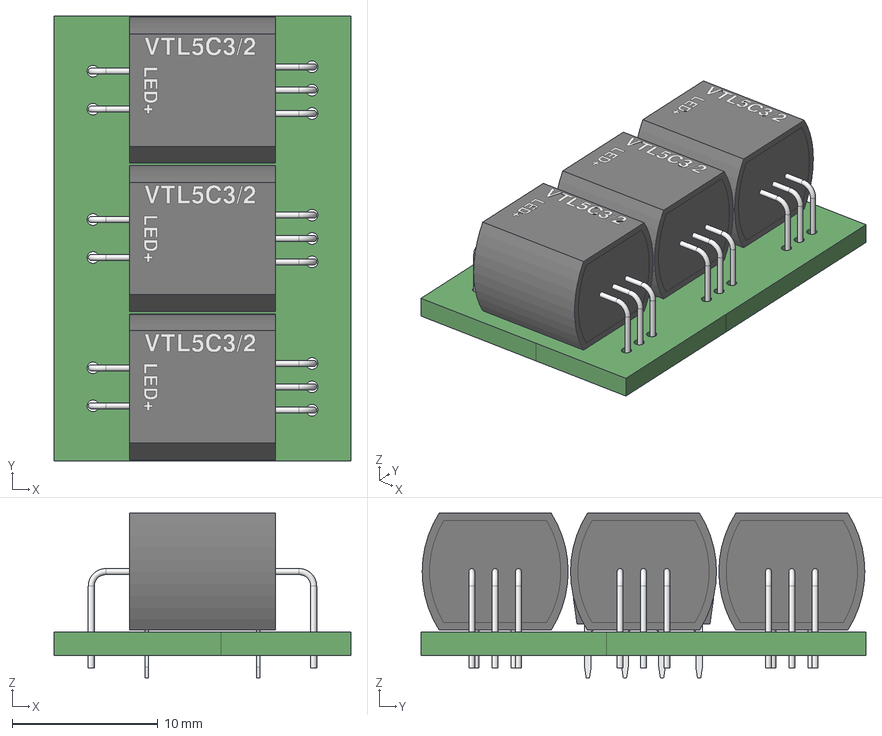
[picture p69: CAD file, 2021-03-29]
PRJ-003 - Mu-Tron Phasor II/#210-000 - Photomodule PCB/#210-000-S2A - Photomodule [Vactrols]/Photomodule - Vactrols.step
20.3 x 30.5 x 11.3 mm
