420-enghighneering/projects-kicad/PRJ-003 - Mu-Tron Phasor II/#310-000 - Power Supply PCB/Powermodule - Bipolar 18V - LT1054/#310-000.step

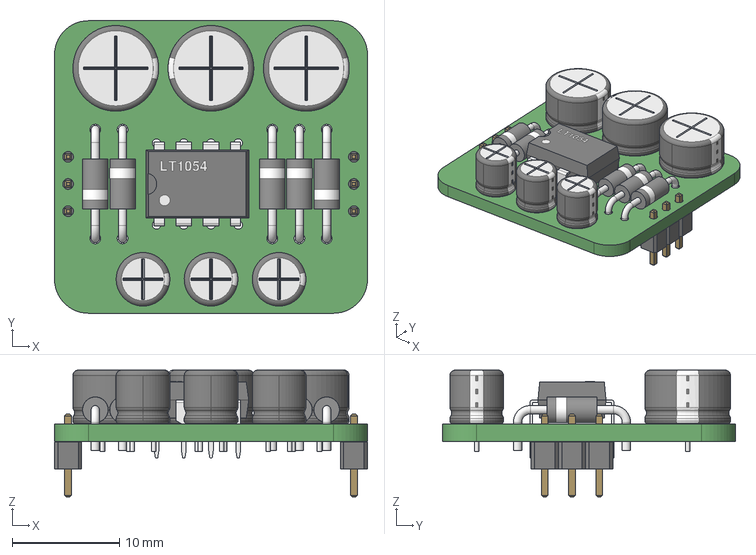
[picture p70: CAD file, 2021-03-29]
PRJ-003 - Mu-Tron Phasor II/#310-000 - Power Supply PCB/Powermodule - Bipolar 18V - LT1054/#310-000.step
29.2 x 27.3 x 11.8 mm
