420-enghighneering/projects-kicad/PRJ-003 - Mu-Tron Phasor II/#400-000 - Switching PCB Assembly/#400-000-A - Switching PCBA [DPDT, Latching]/#400-000-A - Switching PCBA [DPDT, Latching].FCStd

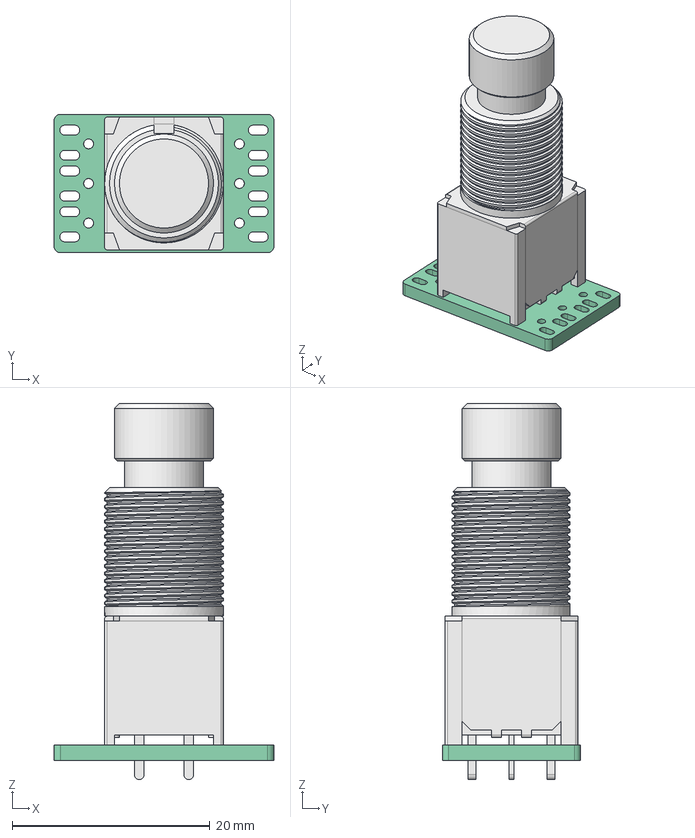
[picture p71: CAD file, 2021-03-29]
PRJ-003 - Mu-Tron Phasor II/#400-000 - Switching PCB Assembly/#400-000-A - Switching PCBA [DPDT, Latching]/#400-000-A - Switching PCBA [DPDT, Latching].FCStd
22.2 x 14.0 x 38.0 mm
Pcb
topTracks
botTracks
SW1_Alpha Taiwan SF12011-0202-20R-X_5DFC3402
