420-enghighneering/projects-kicad/PRJ-003 - Mu-Tron Phasor II/#410-000 - Switching PCB/#410-000-A - Switching PCB [DPDT, Latching]/#400-000-A - Switching PCBA [DPDT, Latching] - STEP VRML.FCStd

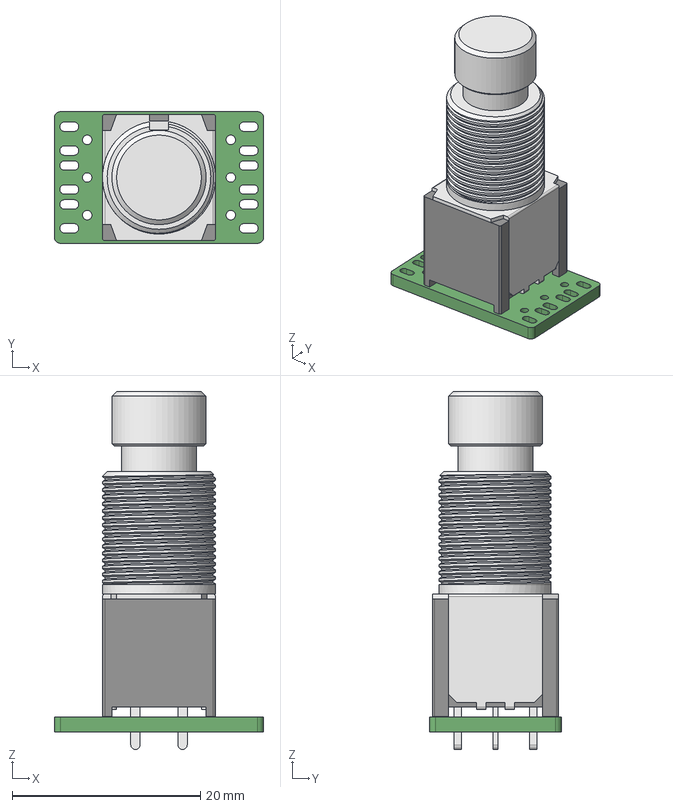
[picture p72: CAD file, 2021-03-29]
PRJ-003 - Mu-Tron Phasor II/#410-000 - Switching PCB/#410-000-A - Switching PCB [DPDT, Latching]/#400-000-A - Switching PCBA [DPDT, Latching] - STEP VRML.FCStd
22.2 x 14.0 x 38.0 mm
