420-enghighneering/projects-kicad/PRJ-003 - Mu-Tron Phasor II/#500-000 - Audio Jack PCB Assembly/#500-000 - Audio Jack PCBA/#500-000 - Audio Jack PCBA.FCStd

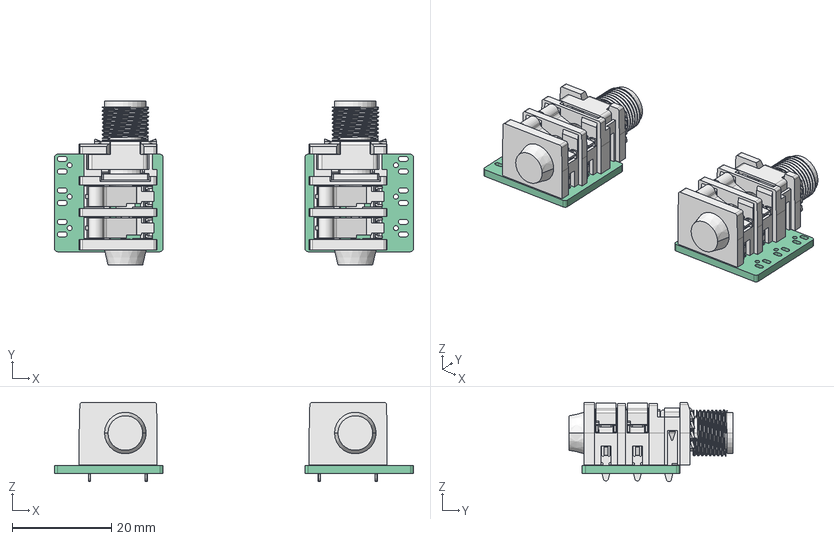
[picture p73: CAD file, 2021-03-29]
PRJ-003 - Mu-Tron Phasor II/#500-000 - Audio Jack PCB Assembly/#500-000 - Audio Jack PCBA/#500-000 - Audio Jack PCBA.FCStd
72.4 x 33.1 x 16.0 mm
Pcb
botTracks
J1_Amphenol_ACJS-MHOM_5DE10BC6
Pcb001
botTracks001
J1_Amphenol_ACJS-MHOM_5DE10BC007
