420-enghighneering/projects-kicad/PRJ-003 - Mu-Tron Phasor II/#500-000 - Audio Jack PCB Assembly/#500-000-A1 [Input, Pads L]/#510-000-A1 [Input, Pads L].FCStd

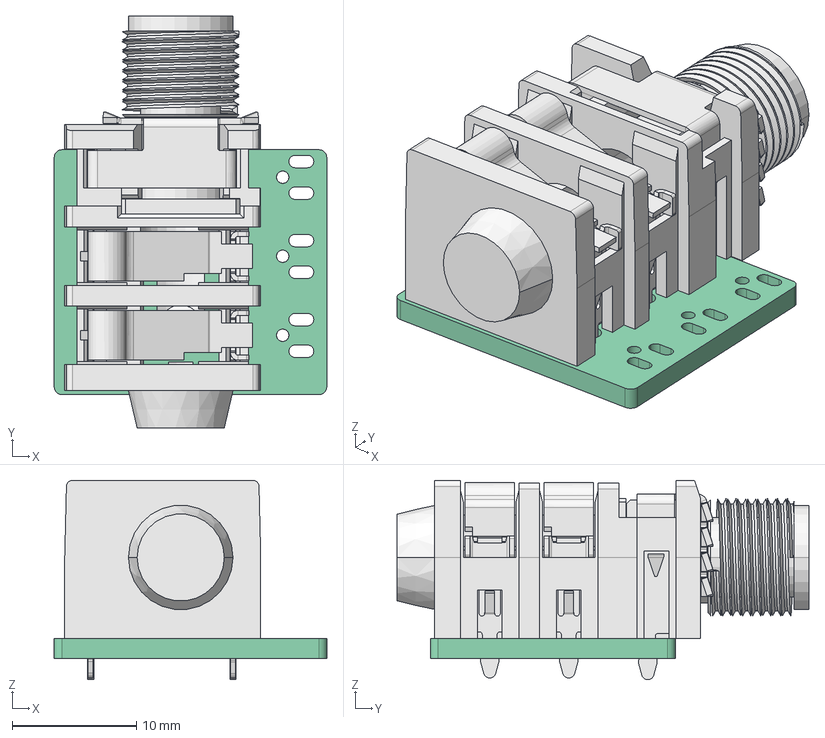
[picture p74: CAD file, 2021-03-29]
PRJ-003 - Mu-Tron Phasor II/#500-000 - Audio Jack PCB Assembly/#500-000-A1 [Input, Pads L]/#510-000-A1 [Input, Pads L].FCStd
21.9 x 33.1 x 16.0 mm
Pcb
botTracks
J1_Amphenol_ACJS-MHOM_5DE10BC6
