420-enghighneering/projects-kicad/PRJ-003 - Mu-Tron Phasor II/#600-000 - Power Jack PCB Assembly/#600-000-A - Power Jack PCB [1614 09]/#610-000-A - Power Jack PCB [1614 09].FCStd

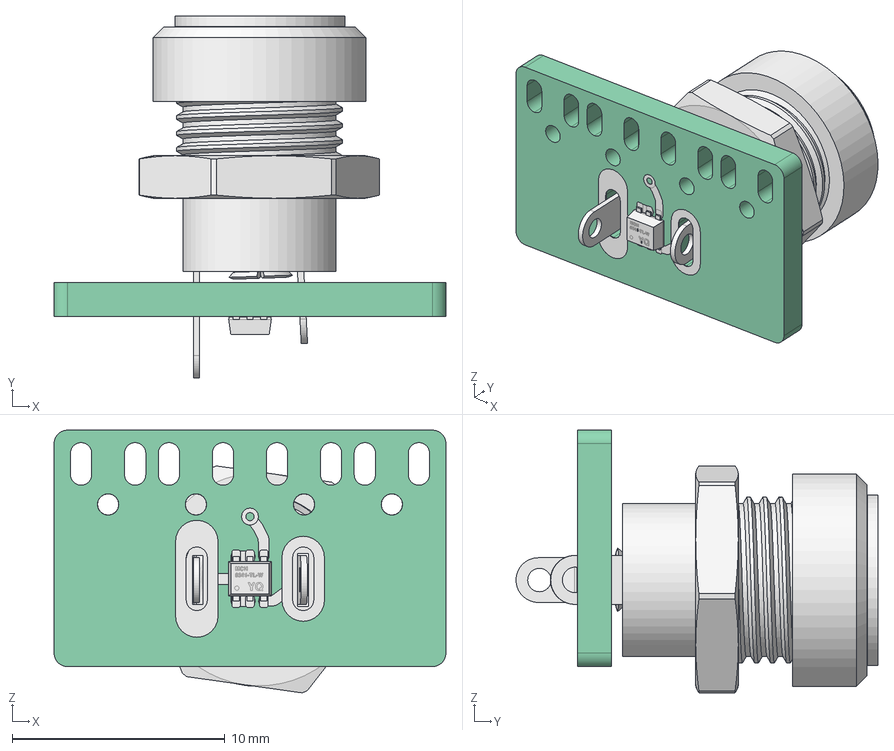
[picture p75: CAD file, 2021-03-29]
PRJ-003 - Mu-Tron Phasor II/#600-000 - Power Jack PCB Assembly/#600-000-A - Power Jack PCB [1614 09]/#610-000-A - Power Jack PCB [1614 09].FCStd
18.4 x 17.0 x 12.3 mm
Pcb
topTracks
botTracks
J2_Lumberg_1614_09 [Nut, 2.5mm]_5DF56328
Q1_MCH6341-TL-W_5DAF49BA
