420-enghighneering/projects-kicad/PRJ-003 - Mu-Tron Phasor II/#610-000 - Power Jack PCB/#610-000-A2 - Power Jack PCB [1614 09, Wide]/#610-000.step

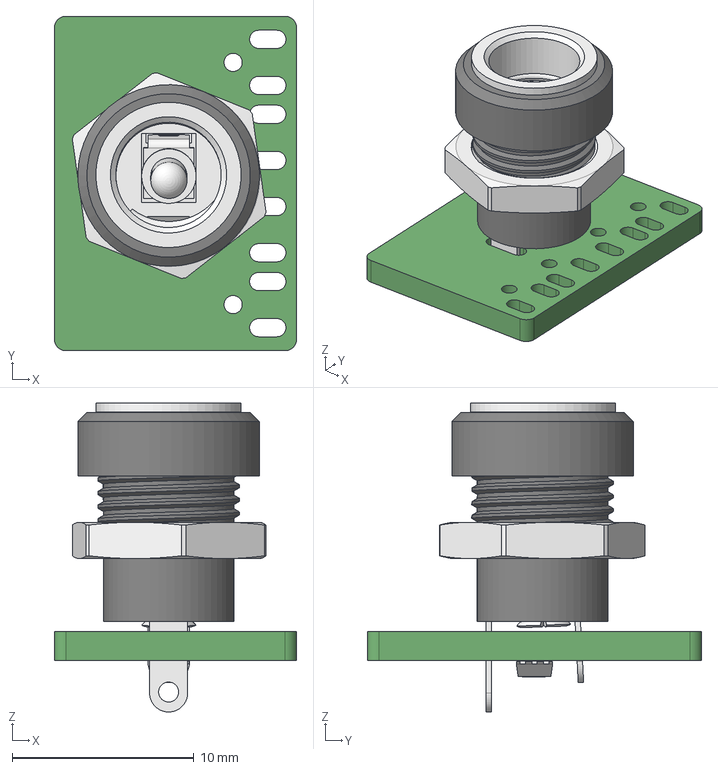
[picture p76: CAD file, 2021-03-29]
PRJ-003 - Mu-Tron Phasor II/#610-000 - Power Jack PCB/#610-000-A2 - Power Jack PCB [1614 09, Wide]/#610-000.step
13.3 x 18.4 x 17.0 mm
