420-enghighneering/projects-kicad/PRJ-003 - Mu-Tron Phasor II/#610-000 - Power Jack PCB/#610-000-B - Power Jack PCB [NEB J 21 C]/#610-000.step

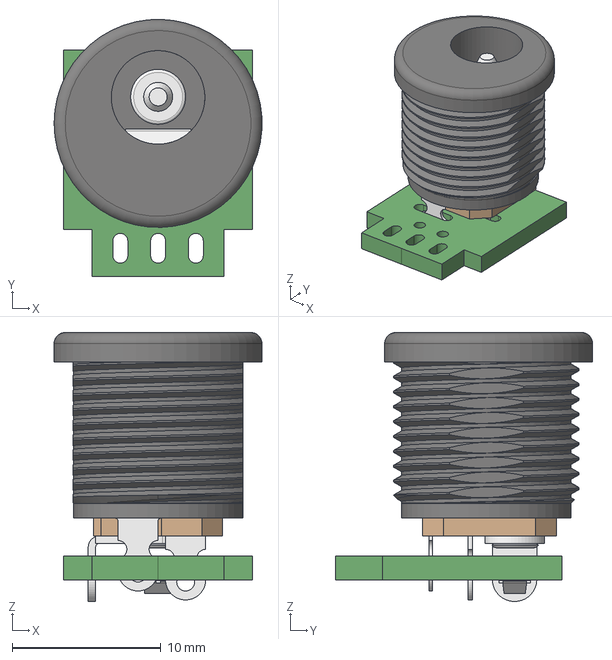
[picture p77: CAD file, 2021-03-29]
PRJ-003 - Mu-Tron Phasor II/#610-000 - Power Jack PCB/#610-000-B - Power Jack PCB [NEB J 21 C]/#610-000.step
14.0 x 17.3 x 18.1 mm
