420-enghighneering/projects-kicad/PRJ-003 - Mu-Tron Phasor II/#800-000 - Finishing Materials/Label Depth.step

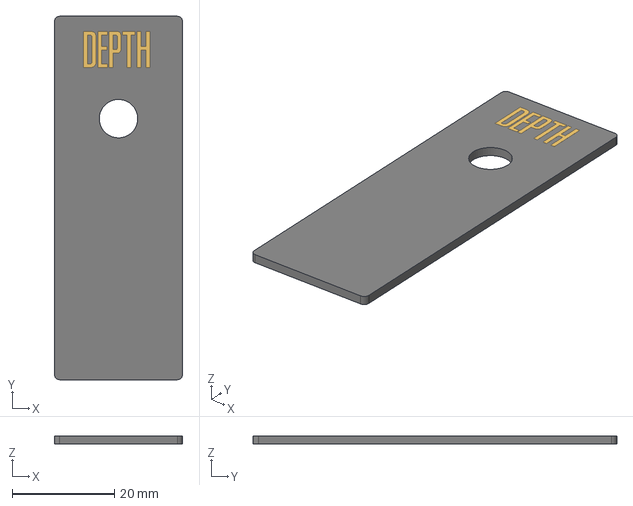
[picture p78: CAD file, 2021-03-29]
PRJ-003 - Mu-Tron Phasor II/#800-000 - Finishing Materials/Label Depth.step
25.0 x 71.0 x 1.61 mm
