420-enghighneering/projects-kicad/PRJ-003 - Mu-Tron Phasor II/#200-000 - Photomodule PCB Assembly/#200-000-A - Photomodule [LDRs]/#200-000-A - Photomodule [LDRs] - STEP VRML.FCStd

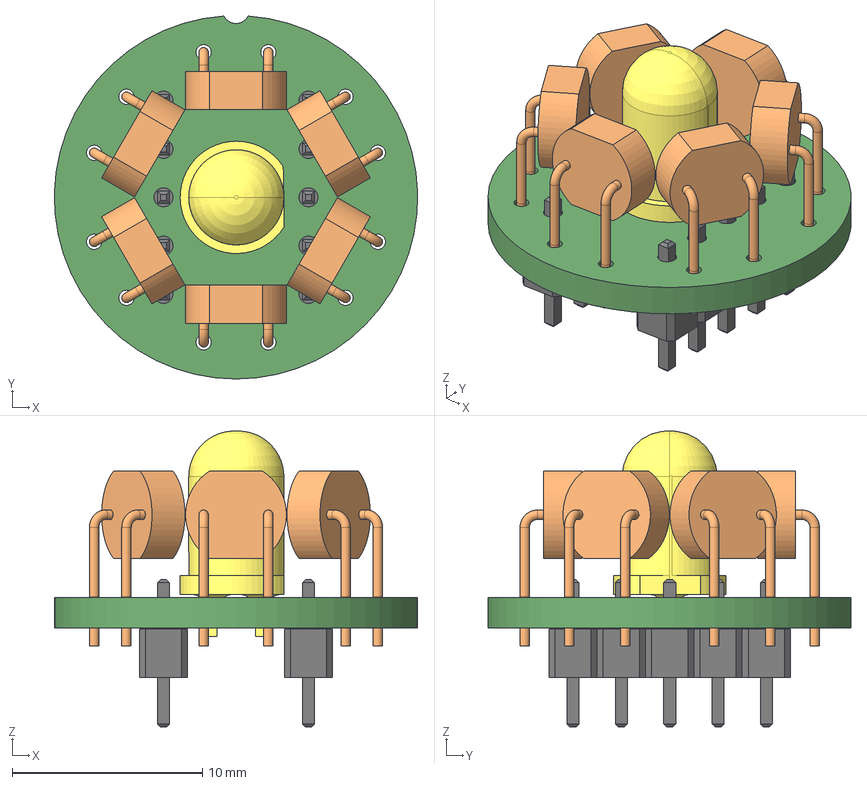
[picture p79: CAD file, 2021-03-29]
PRJ-003 - Mu-Tron Phasor II/#200-000 - Photomodule PCB Assembly/#200-000-A - Photomodule [LDRs]/#200-000-A - Photomodule [LDRs] - STEP VRML.FCStd
19.1 x 19.1 x 15.6 mm
