420-enghighneering/projects-kicad/PRJ-003 - Mu-Tron Phasor II/#700-000 - Enclosure/#700-000-A - Enclosure [1590DD, Portrait]/#700-000-A - Enclosure [1590DD, Portrait].FCStd

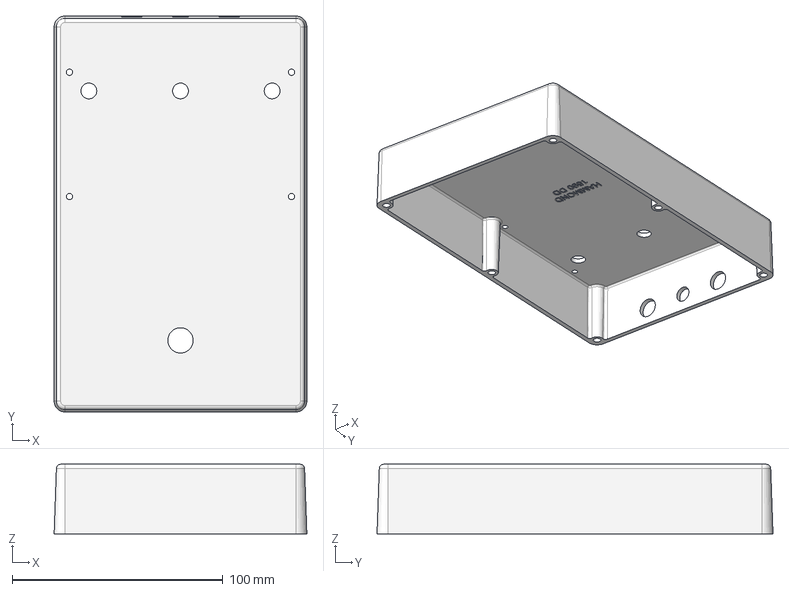
[picture p83: CAD file, 2021-03-29]
PRJ-003 - Mu-Tron Phasor II/#700-000 - Enclosure/#700-000-A - Enclosure [1590DD, Portrait]/#700-000-A - Enclosure [1590DD, Portrait].FCStd
120.0 x 188.0 x 33.0 mm
