420-enghighneering/projects-kicad/PRJ-003 - Mu-Tron Phasor II/#800-000 - Finishing Materials/#800-XXX - Knob Synthie 2.FCStd

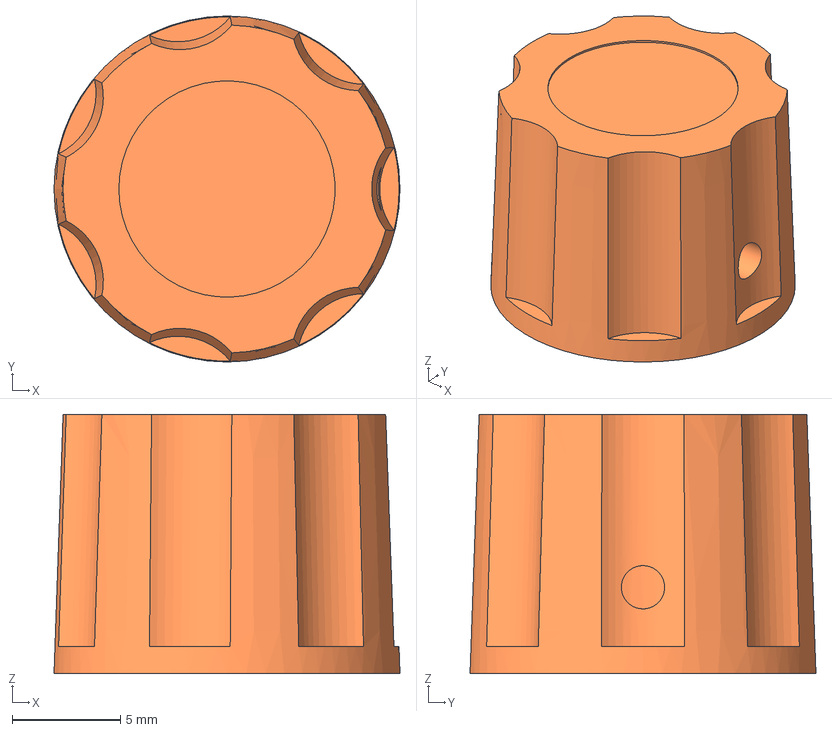
[picture p84: CAD file, 2021-03-29]
PRJ-003 - Mu-Tron Phasor II/#800-000 - Finishing Materials/#800-XXX - Knob Synthie 2.FCStd
16.0 x 16.0 x 12.0 mm
Knob_Synthie_Red
Knob_Synthie_Orange
Knob_Synthie_Violet
