420-enghighneering/projects-kicad/PRJ-003 - Mu-Tron Phasor II/#500-000 - Audio Jack PCB Assembly/#500-000-A1 [Input, Pads L]/#500-000-A1 - Audio Jack PCBA [Input, Pads L] - STEP VRML.FCStd

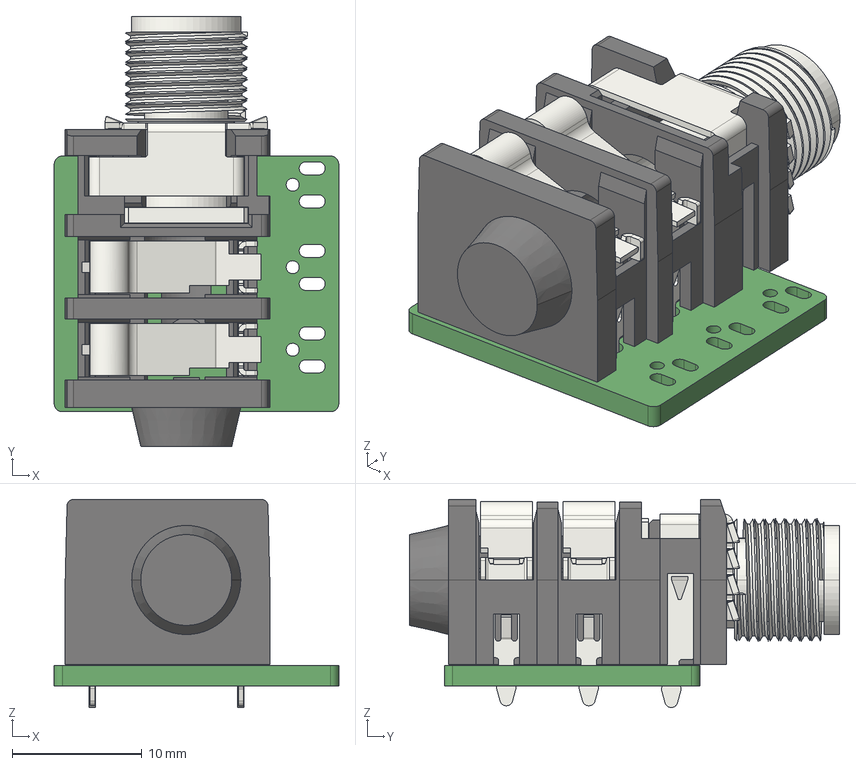
[picture p85: CAD file, 2021-03-29]
PRJ-003 - Mu-Tron Phasor II/#500-000 - Audio Jack PCB Assembly/#500-000-A1 [Input, Pads L]/#500-000-A1 - Audio Jack PCBA [Input, Pads L] - STEP VRML.FCStd
21.9 x 33.1 x 16.0 mm
