420-enghighneering/projects-kicad/PRJ-003 - Mu-Tron Phasor II/#800-000 - Finishing Materials/#XXX-XXX - Photmodule Cap.FCStd

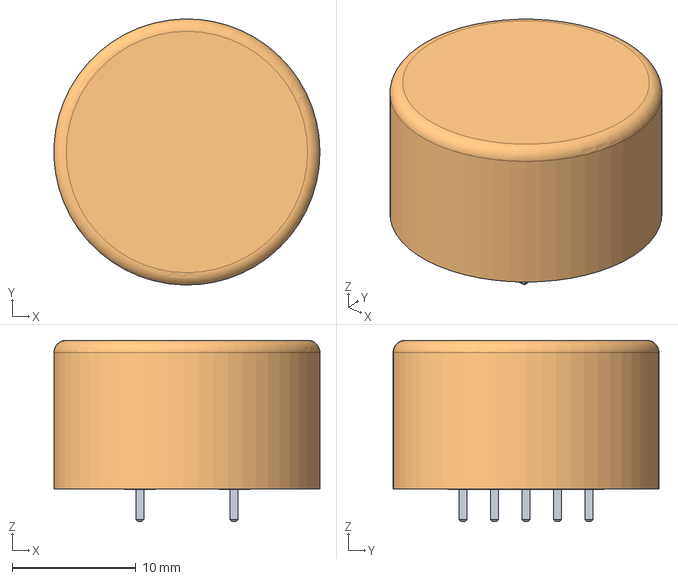
[picture p86: CAD file, 2021-03-29]
PRJ-003 - Mu-Tron Phasor II/#800-000 - Finishing Materials/#XXX-XXX - Photmodule Cap.FCStd
21.5 x 21.5 x 14.7 mm
Photmodule_Cut
PM Cap
