420-enghighneering/projects-kicad/PRJ-003 - Mu-Tron Phasor II/#600-000 - Power Jack PCB Assembly/#600-000-A - Power Jack PCB [1614 09]/#610-000-S1C - Power Jack PCB [1614 09, Narrow, Minimal Protection].FCStd

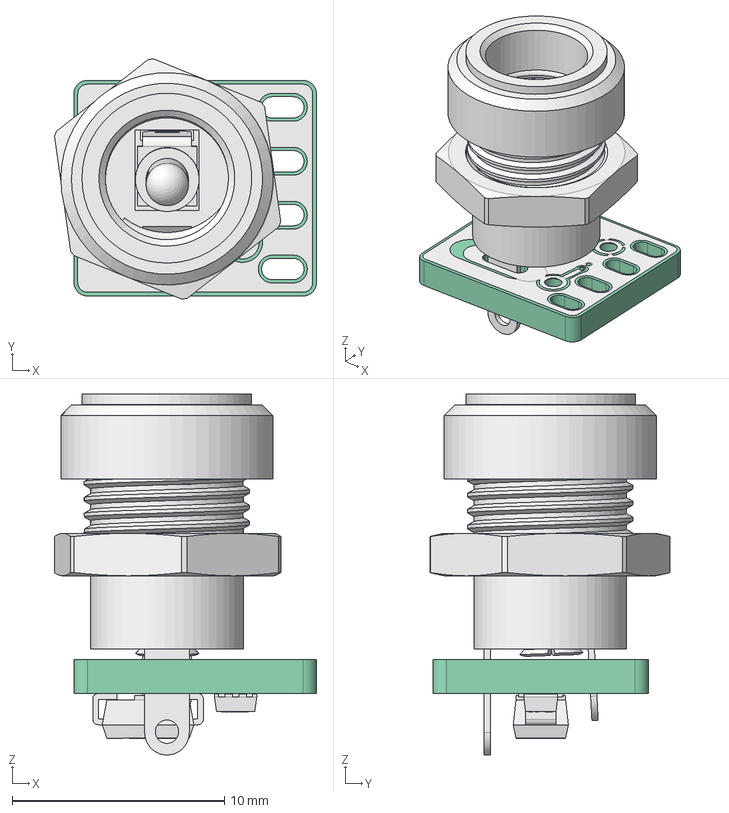
[picture p87: CAD file, 2021-03-29]
PRJ-003 - Mu-Tron Phasor II/#600-000 - Power Jack PCB Assembly/#600-000-A - Power Jack PCB [1614 09]/#610-000-S1C - Power Jack PCB [1614 09, Narrow, Minimal Protection].FCStd
12.3 x 11.3 x 17.0 mm
Pcb_4eef
topTracks_4eef
botTracks_4eef
J2_Lumberg_1614_09__Nut__2_5mm__cp_5DF56328
D1_1SMA5924BT3G_5E1CAF15
Q1_MCH6341-TL-W_5DAF49BA
