420-enghighneering/projects-kicad/PRJ-003 - Mu-Tron Phasor II/#800-000 - Finishing Materials/XXX-XXX - Photomodule Cap2.step

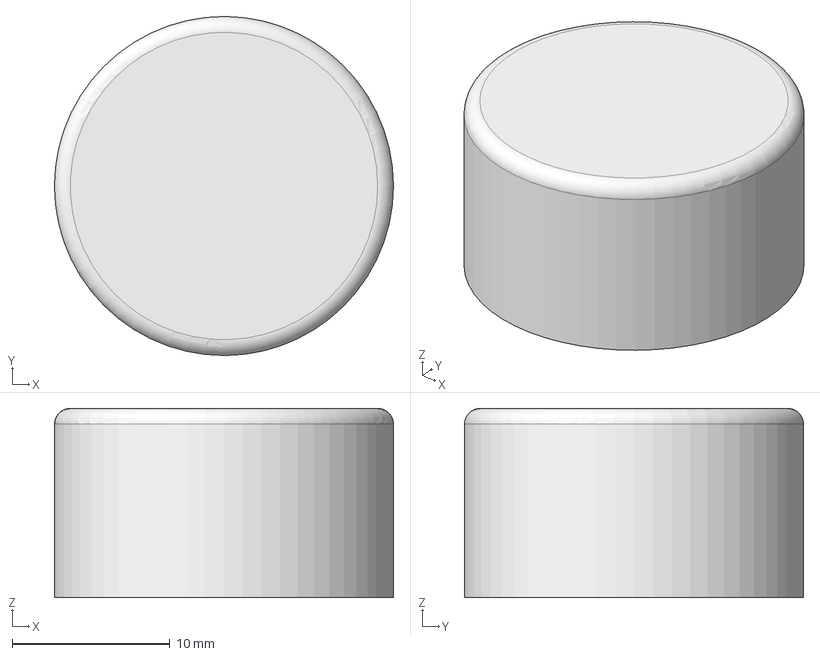
[picture p88: CAD file, 2021-03-29]
PRJ-003 - Mu-Tron Phasor II/#800-000 - Finishing Materials/XXX-XXX - Photomodule Cap2.step
21.5 x 21.5 x 12.0 mm
