420-enghighneering/projects-kicad/PRJ-003 - Mu-Tron Phasor II/#800-000 - Finishing Materials/#XXX-XXX Potentiometer Label PCB.FCStd

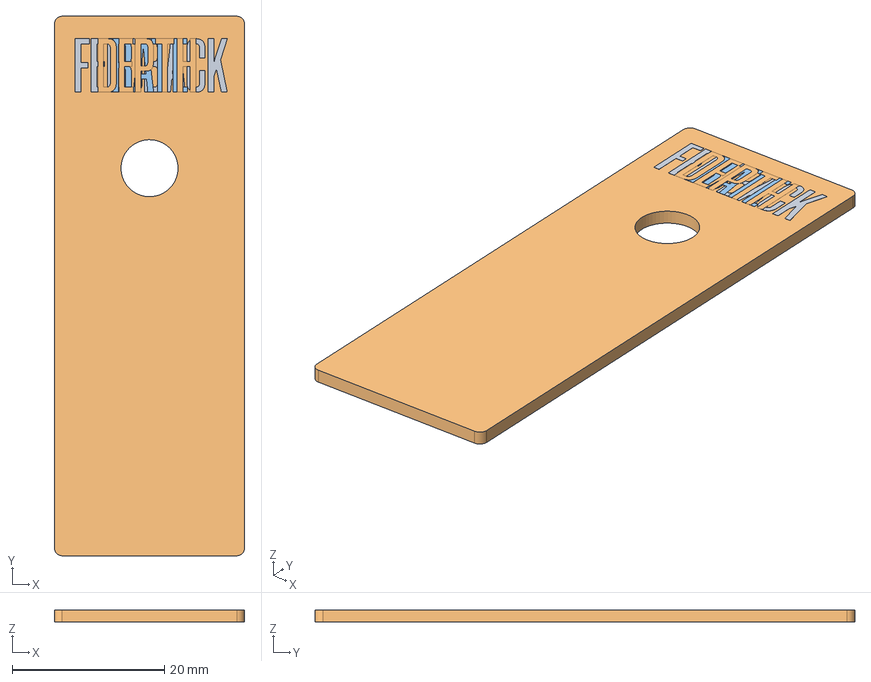
[picture p89: CAD file, 2021-03-29]
PRJ-003 - Mu-Tron Phasor II/#800-000 - Finishing Materials/#XXX-XXX Potentiometer Label PCB.FCStd
25.0 x 71.0 x 1.61 mm
Label Feedback
Label Depth
Label Rate
