420-enghighneering/projects-kicad/(list of files, cad)

Other CAD files:
PRJ-003 - Mu-Tron Phasor II/#000-000 - Final Assembly/#000-000 - Mu-Tron Phasor II - ASM3 Spreadsheet/#000-000 - Mu-Tron Phasor II - ASM3 Spreadsheet.FCStd
PRJ-003 - Mu-Tron Phasor II/#500-000 - Audio Jack PCB Assembly/#500-000-A2 [Output, Pads R]/#510-000 [Output, Pads R].FCStd
PRJ-003 - Mu-Tron Phasor II/#700-000 - Enclosure/#700-000-A - Enclosure [1590DD, Portrait]/#700-000-A - Enclosure [1590DD, Portrait] - STEP VRML.FCStd
PRJ-003 - Mu-Tron Phasor II/#410-000 - Switching PCB/#410-000-A - Switching PCB [DPDT, Latching]/#410-000 - Alpha DPDT.step
PRJ-003 - Mu-Tron Phasor II/#500-000 - Audio Jack PCB Assembly/#500-000-A2 [Output, Pads R]/#510-000-A2 [Output, Pads R].FCStd
PRJ-003 - Mu-Tron Phasor II/#600-000 - Power Jack PCB Assembly/#600-000-A - Power Jack PCB [1614 09]/#600-000-A - Power Jack PCB [1614 09, Wide] - STEP VRML.FCStd
PRJ-003 - Mu-Tron Phasor II/#210-000 - Photomodule PCB/#210-000-S1A - Photomodule PCB [LDRs]/#210-000-S1A - Photomodule PCB [LDRs] - KiExpAligned.step
PRJ-003 - Mu-Tron Phasor II/#600-000 - Power Jack PCB Assembly/#600-000-A - Power Jack PCB [1614 09]/#600-000-A - Power Jack PCB [1614 09].FCStd
PRJ-003 - Mu-Tron Phasor II/#800-000 - Finishing Materials/Label Feedback.step
PRJ-003 - Mu-Tron Phasor II/#210-000 - Photomodule PCB/#210-000-S1A - Photomodule PCB [LDRs]/#210-000-S1A - Photomodule PCB [LDRs].step
PRJ-003 - Mu-Tron Phasor II/#500-000 - Audio Jack PCB Assembly/#500-000-A1 [Input, Pads L]/#500-000-A2 - Audio Jack PCBA [Output, Pads R] - STEP VRML.FCStd
PRJ-003 - Mu-Tron Phasor II/#600-000 - Power Jack PCB Assembly/#600-000-A - Power Jack PCB [1614 09]/#600-000-A2 - Power Jack PCBA [1614 09, Wide] - STEP VRML.FCStd
PRJ-003 - Mu-Tron Phasor II/#210-000 - Photomodule PCB/#210-000-S1A - Photomodule PCB [LDRs]/Photomodule - LDRs.step
PRJ-003 - Mu-Tron Phasor II/#800-000 - Finishing Materials/XXX-XXX - Photomodule Cap.step
PRJ-003 - Mu-Tron Phasor II/#800-000 - Finishing Materials/Label Rate.step
PRJ-003 - Mu-Tron Phasor II/#000-000 - Final Assembly/Design Archive/#8XX-XXX - Standoff Stack.FCStd
PRJ-003 - Mu-Tron Phasor II/#000-000 - Final Assembly/Design Archive/#8XX-XXX - Standoff Stack.step
PRJ-003 - Mu-Tron Phasor II/#000-000 - Final Assembly/Design Archive/PRJ-003-#000-000 - Lid Assy.FCStd
PRJ-003 - Mu-Tron Phasor II/#200-000 - Photomodule PCB Assembly/#200-000-A - Photomodule [LDRs]/#200-000-A - Photomodule [LDRs].FCStd
PRJ-003 - Mu-Tron Phasor II/#200-000 - Photomodule PCB Assembly/Design Archive/#200-000 - Photomodule PCBA.FCStd
PRJ-003 - Mu-Tron Phasor II/#400-000 - Switching PCB Assembly/Design Archive/#400-000 - Switching PCBA [Alpha DPDT].FCStd
PRJ-003 - Mu-Tron Phasor II/#500-000 - Audio Jack PCB Assembly/Design Archive/#500-000 - Audio Jack PCBA [Input, L].FCStd
PRJ-003 - Mu-Tron Phasor II/#500-000 - Audio Jack PCB Assembly/Design Archive/#500-000 - Audio Jack PCBA [Output, R].FCStd
PRJ-003 - Mu-Tron Phasor II/#500-000 - Audio Jack PCB Assembly/Design Archive/#500-000 - Audio Jack PCBA.FCStd
PRJ-003 - Mu-Tron Phasor II/#500-000 - Audio Jack PCB Assembly/Design Archive/#510-000 [Input, Pads L]/#510-000 [Input, Pads L].FCStd
PRJ-003 - Mu-Tron Phasor II/#600-000 - Power Jack PCB Assembly/Design Archive/#600-000 - Power Jack PCBA [Small, +Nut, 2.5mm].FCStd
PRJ-003 - Mu-Tron Phasor II/#600-000 - Power Jack PCB Assembly/Design Archive/#600-000 - Power Jack PCBA.FCStd
PRJ-003 - Mu-Tron Phasor II/#600-000 - Power Jack PCB Assembly/Design Archive/#600-000 - Power Jack PCBA.step
PRJ-003 - Mu-Tron Phasor II/#700-000 - Enclosure/Design Archive/#700-000 - Enclosure [Parts].FCStd
PRJ-003 - Mu-Tron Phasor II/#700-000 - Enclosure/Design Archive/#700-000 With PCB.FCStd
PRJ-003 - Mu-Tron Phasor II/#800-000 - Finishing Materials/Screw_M3x6_T_2.0_Panhead.FCStd
PRJ-003 - Mu-Tron Phasor II/#800-000 - Finishing Materials/Screw_M3x6_T_2.0_Panhead.step
PRJ-003 - Mu-Tron Phasor II/Archive - Pre-Project/Musitronics Mu-Tron II Phaser/Archive/Layout Test/LDR Section/STEP/Mu_Tron_II_LDR_sp.step
PRJ-003 - Mu-Tron Phasor II/Archive - Pre-Project/Musitronics Mu-Tron II Phaser/Archive/Layout Test/LFO Section/STEP/Mu-Tron_II_LFO.step
PRJ-003 - Mu-Tron Phasor II/Archive - Pre-Project/Musitronics Mu-Tron II Phaser/Board Reproduction/00 - Front Panel/Front Panel.step
PRJ-003 - Mu-Tron Phasor II/Archive - Pre-Project/Musitronics Mu-Tron II Phaser/Board Reproduction/Photomodule - LDRs/Photomodule - LDRs.step
PRJ-003 - Mu-Tron Phasor II/Archive - Pre-Project/Musitronics Mu-Tron II Phaser/Master Schematic/#140-000 Potentiometer PCBA/#140-000 Potentiometer PCBA.step
PRJ-003 - Mu-Tron Phasor II/Archive - Pre-Project/Musitronics Mu-Tron II Phaser/VAR A - 1590A Miyama/#110-000 Phase Shifter PCBA/#110-000 Phase Shifter PCBA.step
PRJ-003 - Mu-Tron Phasor II/Archive - Pre-Project/Musitronics Mu-Tron II Phaser/VAR A - 1590A Miyama/#140-000 Potentiometer PCBA/#140-000 Potentiometer PCBA.step
PRJ-003 - Mu-Tron Phasor II/Archive - Pre-Project/Musitronics Mu-Tron II Phaser/VAR B - 1590BB Soft/#000-000 Musitronics Mu-Tron Phasor II PCBA/#000-000 Musitronics Mu-Tron Phasor II PCBA.FCStd
PRJ-003 - Mu-Tron Phasor II/Archive - Pre-Project/Musitronics Mu-Tron II Phaser/VAR B - 1590BB Soft/#110-000 Phase Shifter PCBA/#110-000 Phase Shifter PCBA.step
PRJ-003 - Mu-Tron Phasor II/Archive - Pre-Project/Musitronics Mu-Tron II Phaser/VAR B - 1590BB Soft/#140-000 Potentiometer PCBA/#140-000 Potentiometer PCBA.step
