420-enghighneering/projects-kicad/PRJ-003 - Mu-Tron Phasor II/Exports/ex-wiring.jpg

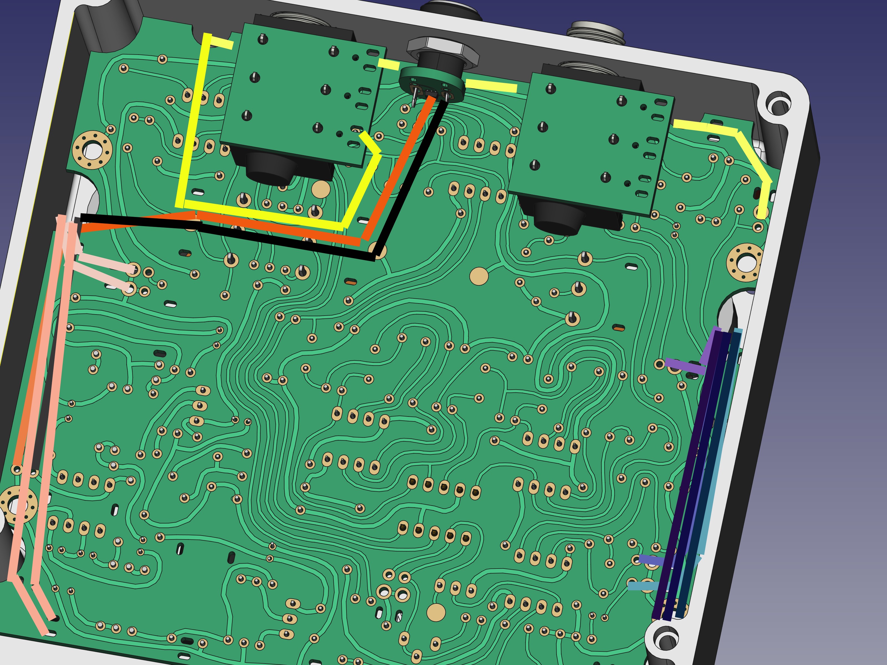
PRJ-003 - Mu-Tron Phasor II/Exports/ex-wiring.jpg
