420-enghighneering/projects-kicad/PRJ-003 - Mu-Tron Phasor II/Exports/wiring tb.png

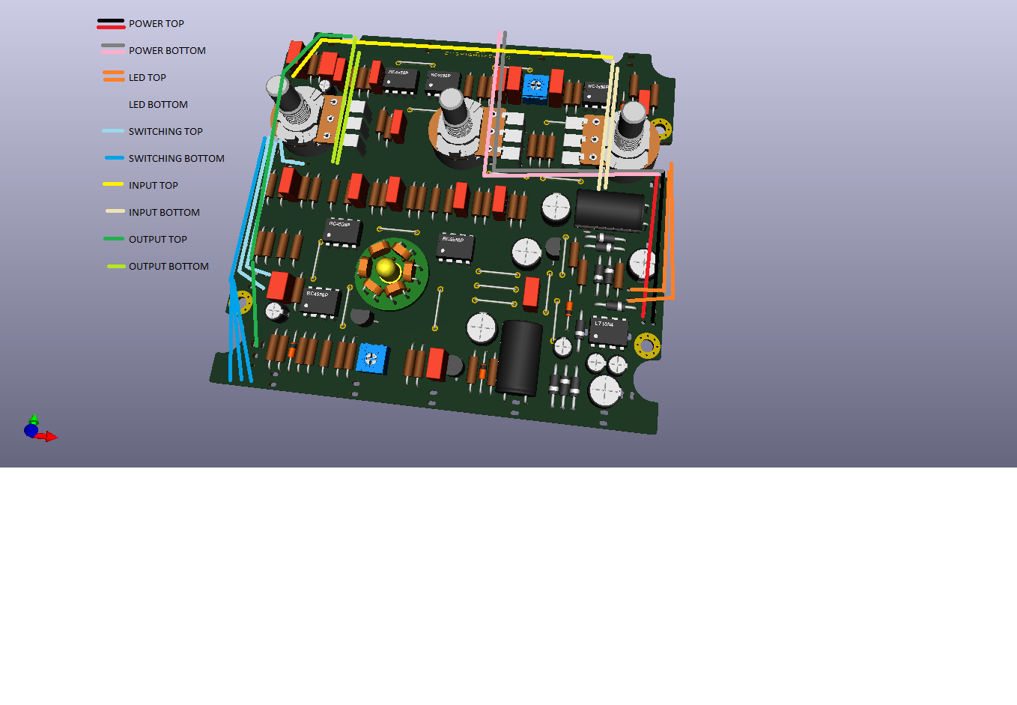
PRJ-003 - Mu-Tron Phasor II/Exports/wiring tb.png
