420-enghighneering/projects-kicad/PRJ-003 - Mu-Tron Phasor II/#110-000 - Phasor PCB/Design History/F/#110-000-BRD-3D.png

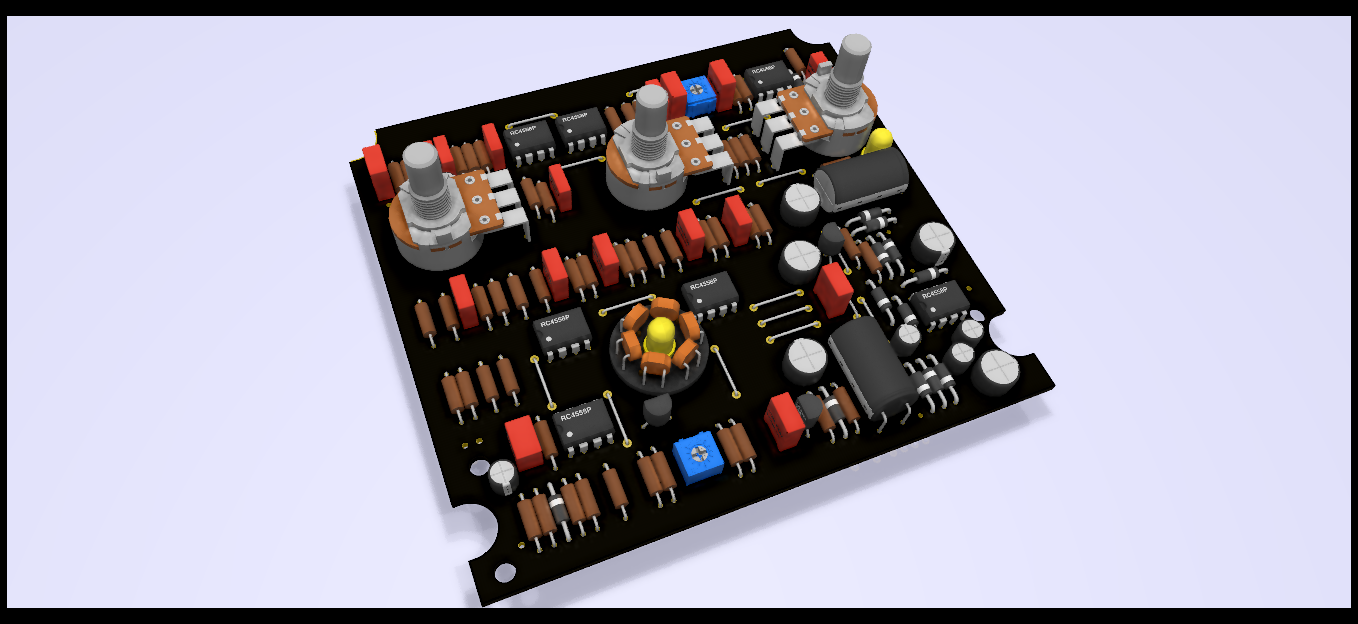
PRJ-003 - Mu-Tron Phasor II/#110-000 - Phasor PCB/Design History/F/#110-000-BRD-3D.png
