420-enghighneering/projects-kicad/PRJ-003 - Mu-Tron Phasor II/#110-000 - Phasor PCB/Design History/L/#110-000-top2.jpg

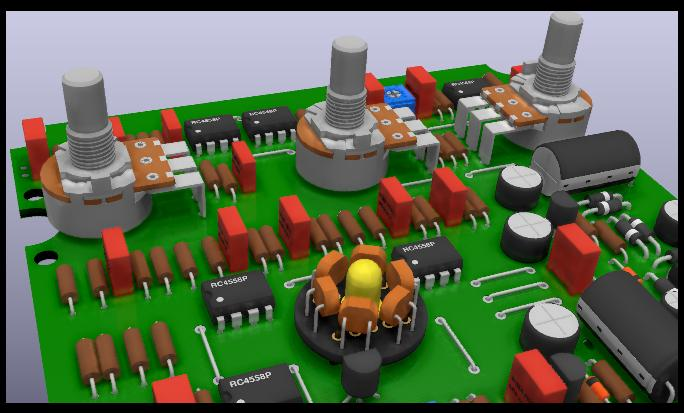
PRJ-003 - Mu-Tron Phasor II/#110-000 - Phasor PCB/Design History/L/#110-000-top2.jpg
