420-enghighneering/projects-kicad/PRJ-003 - Mu-Tron Phasor II/#110-000 - Phasor PCB/Design History/Power Supply On PCB/03 - move pads/#110-000.jpg

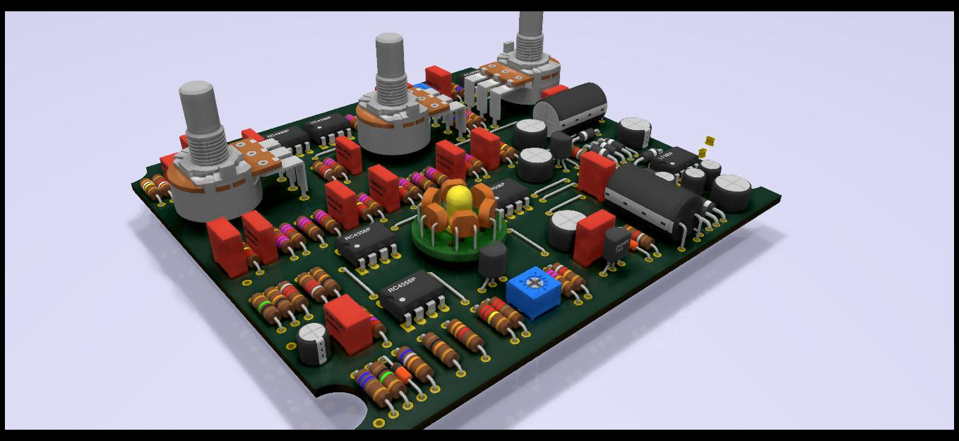
PRJ-003 - Mu-Tron Phasor II/#110-000 - Phasor PCB/Design History/Power Supply On PCB/03 - move pads/#110-000.jpg
