420-enghighneering/projects-kicad/PRJ-003 - Mu-Tron Phasor II/#110-000 - Phasor PCB/Design History/#110-000.pdf

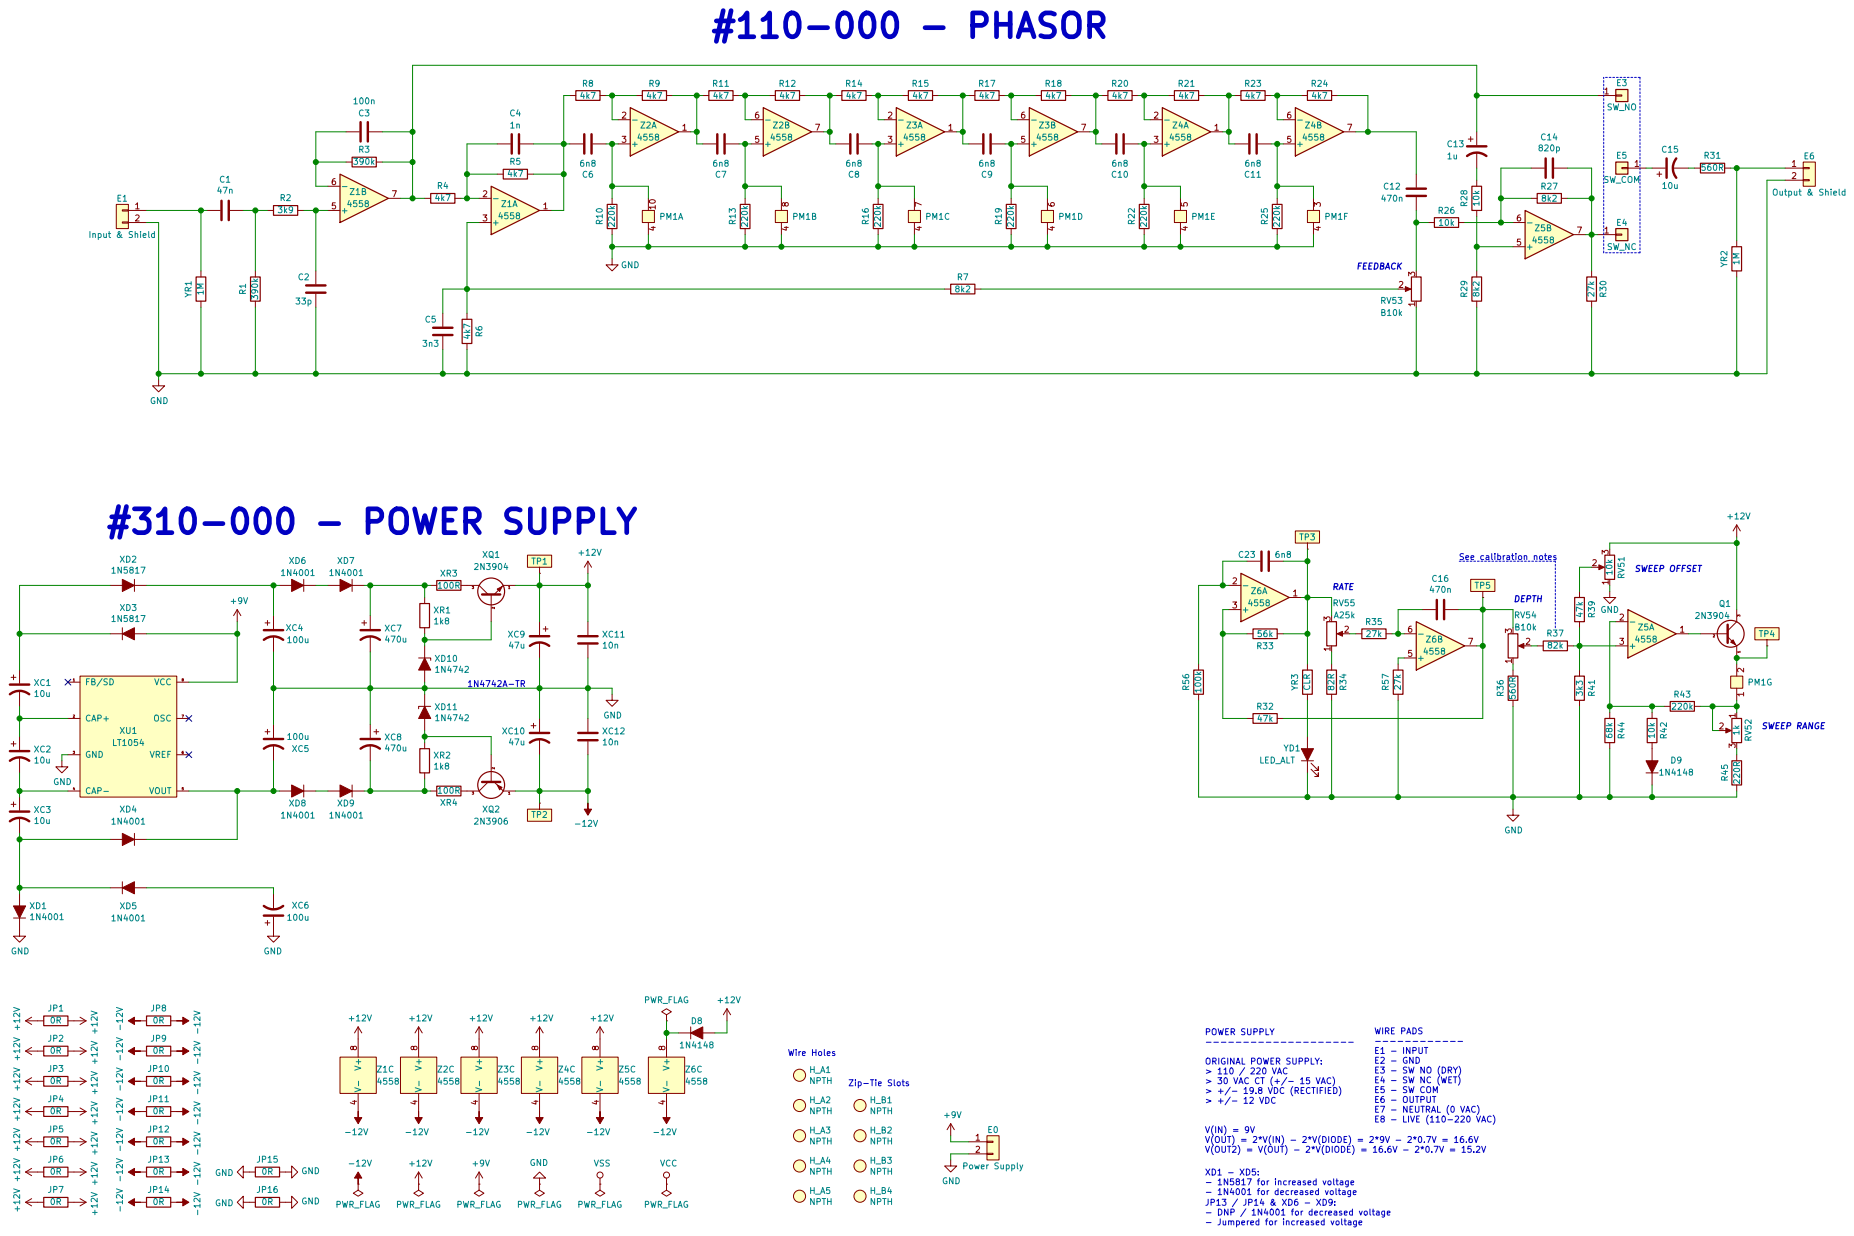
[picture p100: page 1]

- 1N4001 for decreased voltage Zip-Tie Slots #310-000 - POWER SUPPLY

-------------------- ORIGINAL POWER SUPPLY: > 110 / 220 VAC

> 30 VAC CT (+/- 15 VAC) > +/- 19.8 VDC (RECTIFIED) > +/- 12 VDC

E3 - SW NO (DRY) E4 - SW NC (WET) E5 - SW COM

- Jumpered for increased voltage XD1 - XD5: - 1N5817 for increased voltage

JP13 / JP14 & XD6 - XD9: - DNP / 1N4001 for decreased voltage
