420-enghighneering/projects-kicad/PRJ-003 - Mu-Tron Phasor II/#110-000 - Phasor PCB/Design History/L/#110-000-Eco1_User.pdf

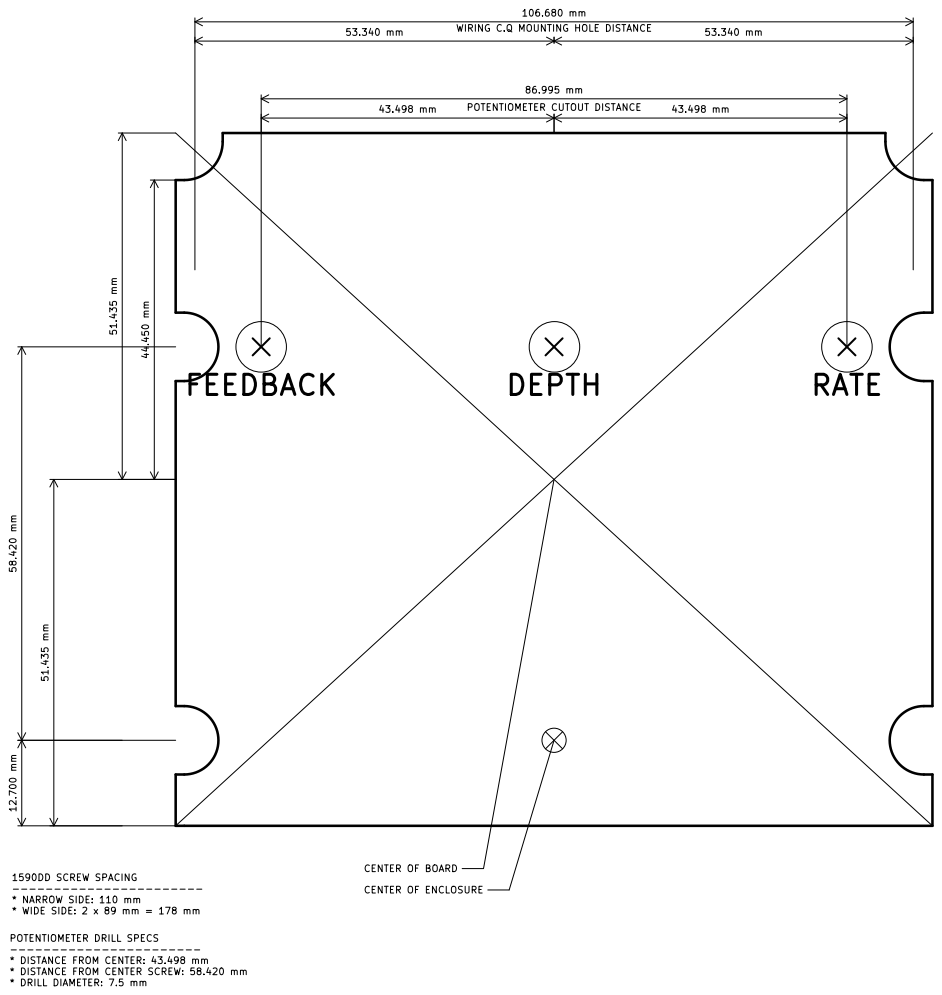
[picture p101: page 1]

* DRILL DIAMETER: 7.5 mm 12.700 mm

1590DD SCREW SPACING
----------------------- * NARROW SIDE: 110 mm * WIDE SIDE: 2 x 89 mm = 178 mm

POTENTIOMETER DRILL SPECS
----------------------- * DISTANCE FROM CENTER: 43.498 mm

* DISTANCE FROM CENTER SCREW: 58.420 mm
