420-enghighneering/projects-kicad/PRJ-003 - Mu-Tron Phasor II/#110-000 - Phasor PCB/Design History/R/#110-000-S1A - Phasor PCB schem rescue.pdf

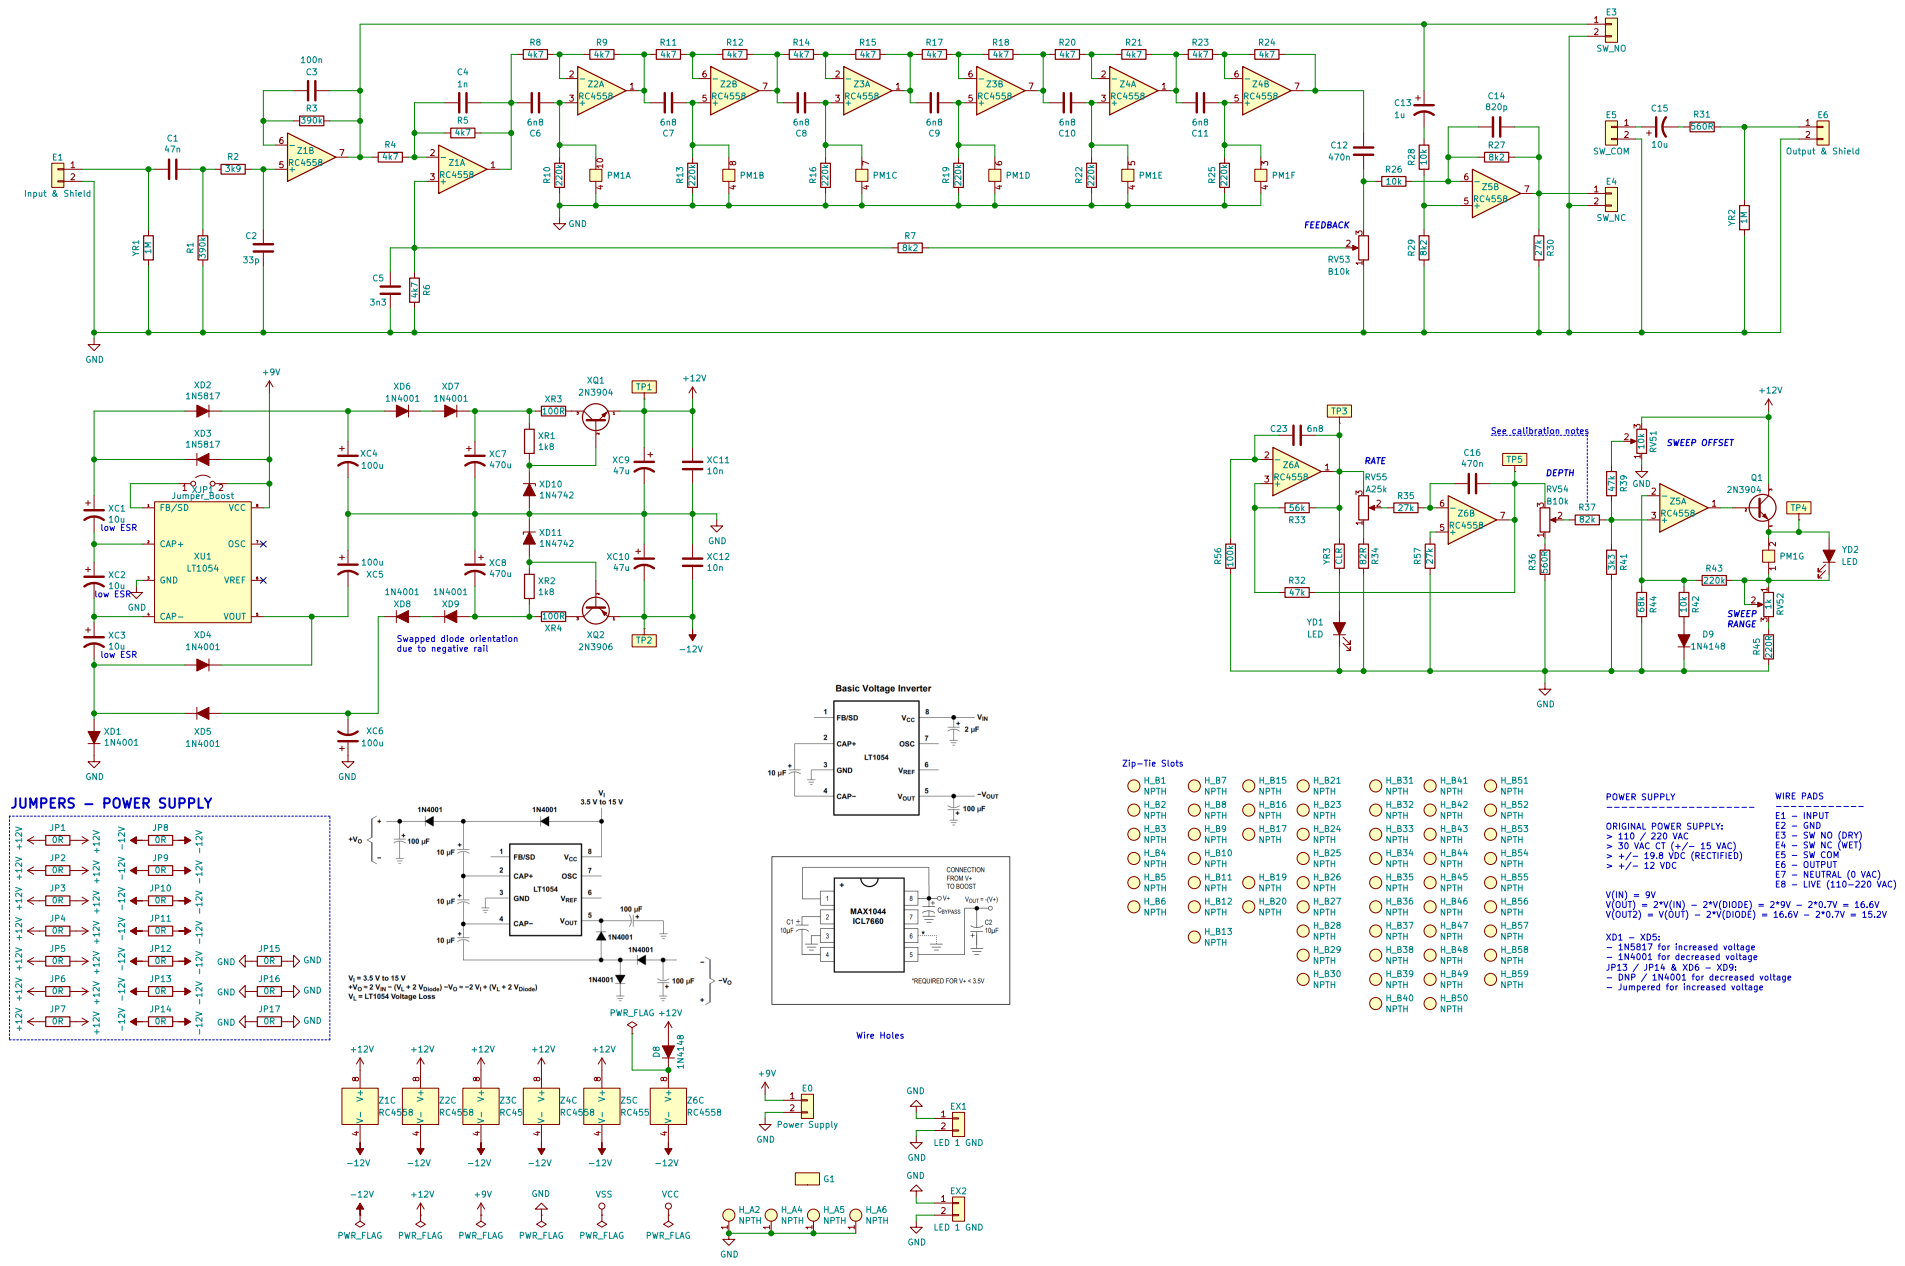
[picture p102: page 1]

POWER SUPPLY
-------------------- ORIGINAL POWER SUPPLY: > 110 / 220 VAC

E3 - SW NO (DRY)
E4 - SW NC (WET) E5 - SW COM

- 1N4001 for decreased voltage
JP13 / JP14 & XD6 - XD9: - DNP / 1N4001 for decreased voltage

- Jumpered for increased voltage

LED 1 GND GND GND
