420-enghighneering/projects-kicad/PRJ-003 - Mu-Tron Phasor II/#110-000 - Phasor PCB/Design History/S/#110-000-S1A - Phasor PCB.pdf

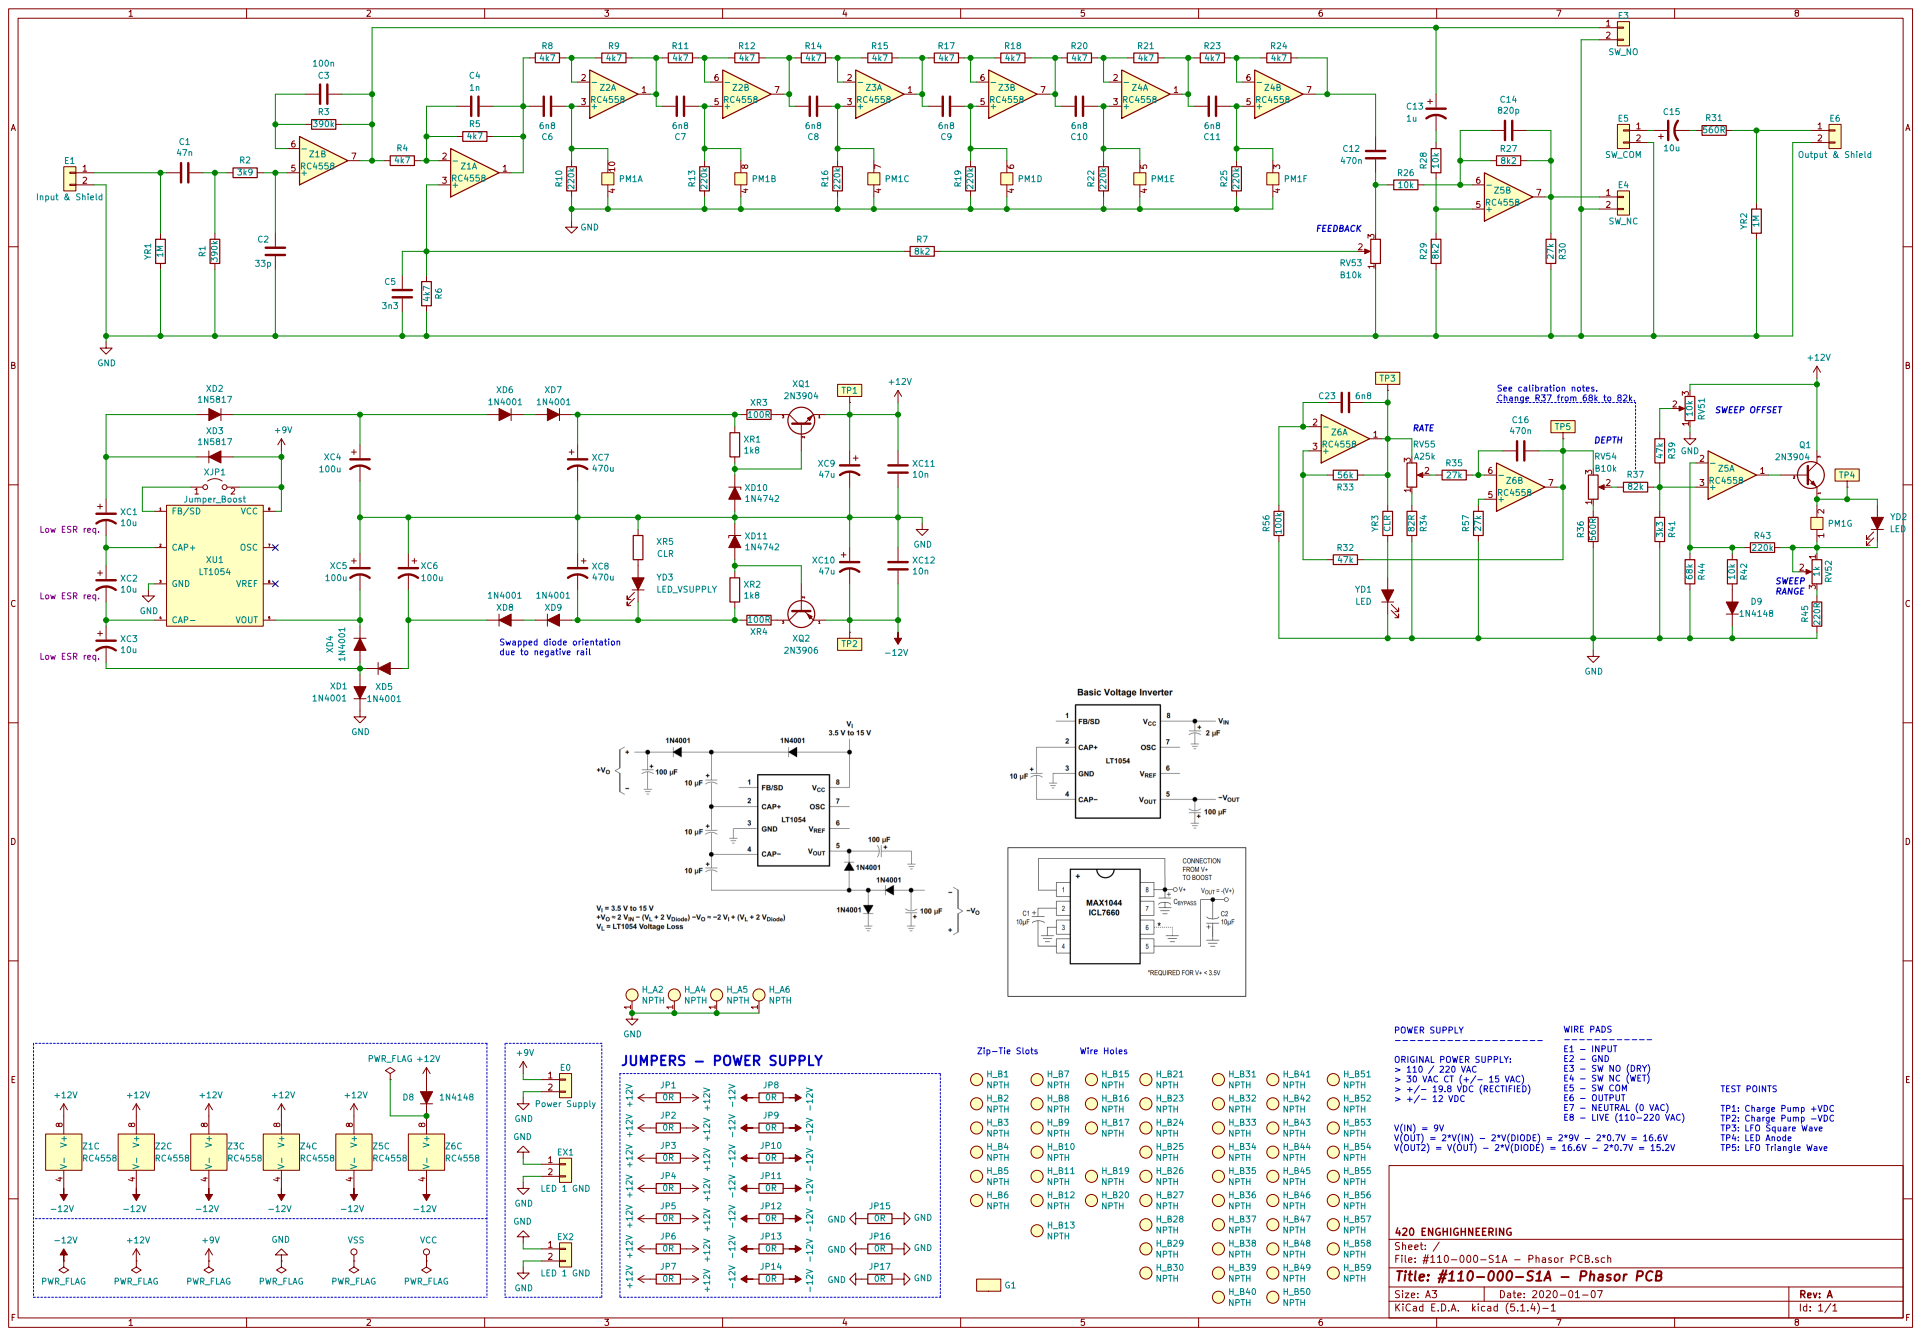
[picture p103: page 1]

due to negative rail
-12V GND

TP3: LFO Square Wave TP4: LED Anode TP5: LFO Triangle Wave POWER SUPPLY
-------------------- ORIGINAL POWER SUPPLY: > 110 / 220 VAC

E3 - SW NO (DRY)
E4 - SW NC (WET) E5 - SW COM

LED 1 GND GND GND

H_B46 NPTH GND GND GND

File: #110-000-S1A - Phasor PCB.sch Sheet: / 420 ENGHIGHNEERING

Id: 1/1 Title: #110-000-S1A - Phasor PCB
