420-enghighneering/projects-kicad/PRJ-003 - Mu-Tron Phasor II/#410-000 - Switching PCB/#410-000-S1A - Switching PCB [DPDT, Latching]/Export - Schematic/#410-000-S1A - Switching PCB [DPDT, Latching].pdf

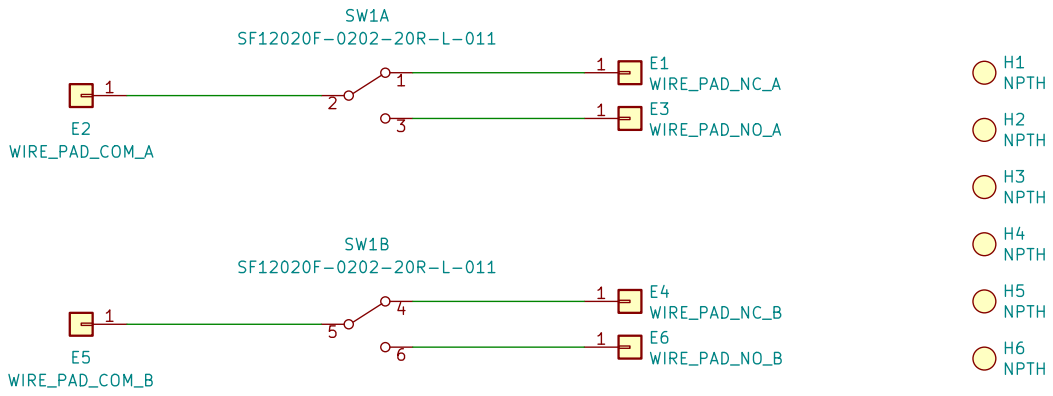
[picture p104: page 1]

File: #410-000-S1A - Switching PCB [DPDT, Latching].sch Sheet: / 420 ENGHIGHNEERING

Id: 1/1 Title: #410-000-S1A - Switching PCB [DPDT, Latching]
