420-enghighneering/projects-kicad/PRJ-003 - Mu-Tron Phasor II/#210-000 - Photomodule PCB/#210-000-S1A - Photomodule PCB [LDRs]/#210-000-S1A - Photomodule PCB [LDRs].pdf

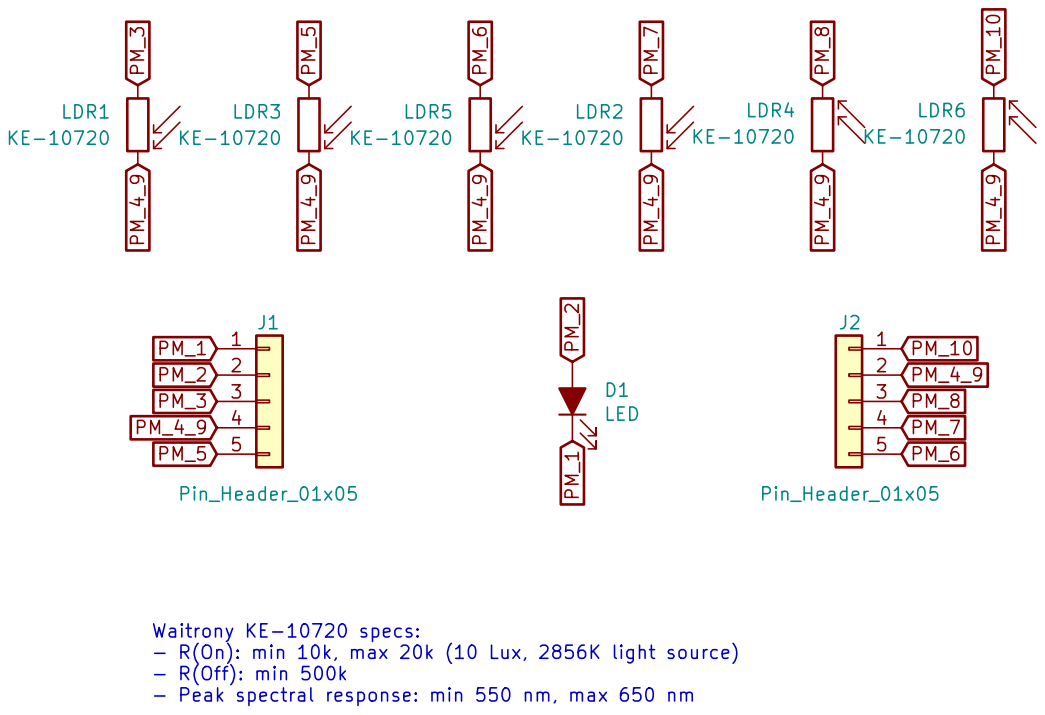
[picture p105: page 1]

Waitrony KE-10720 specs:
- R(On): min 10k, max 20k (10 Lux, 2856K light source)
- R(Off): min 500k
- Peak spectral response: min 550 nm, max 650 nm
