420-enghighneering/projects-kicad/PRJ-003 - Mu-Tron Phasor II/#610-000 - Power Jack PCB/#610-000-A2 - Power Jack PCB [1614 09, Wide]/#610-000.pdf

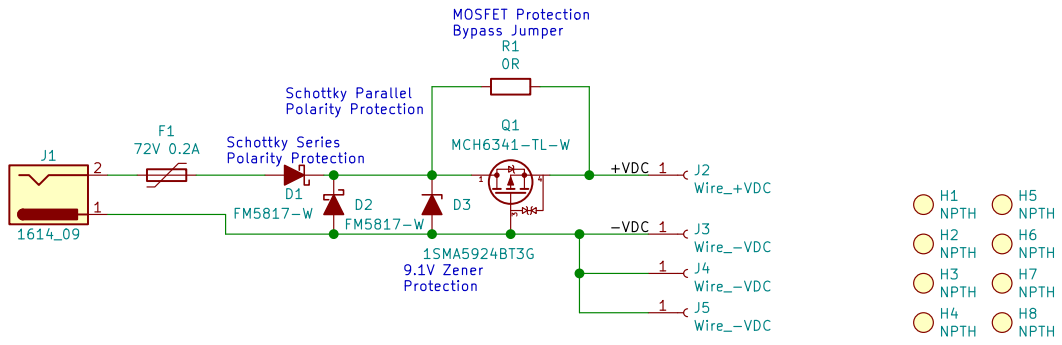
[picture p106: page 1]

9.1V Zener Protection Schottky Series
Polarity Protection

File: #610-000.sch Sheet: / 420 ENGHIGHNEERING
