420-enghighneering/projects-kicad/PRJ-003 - Mu-Tron Phasor II/#110-000 - Phasor PCB/Design History/L/#110-000-F.Cu_B.Cu.pdf

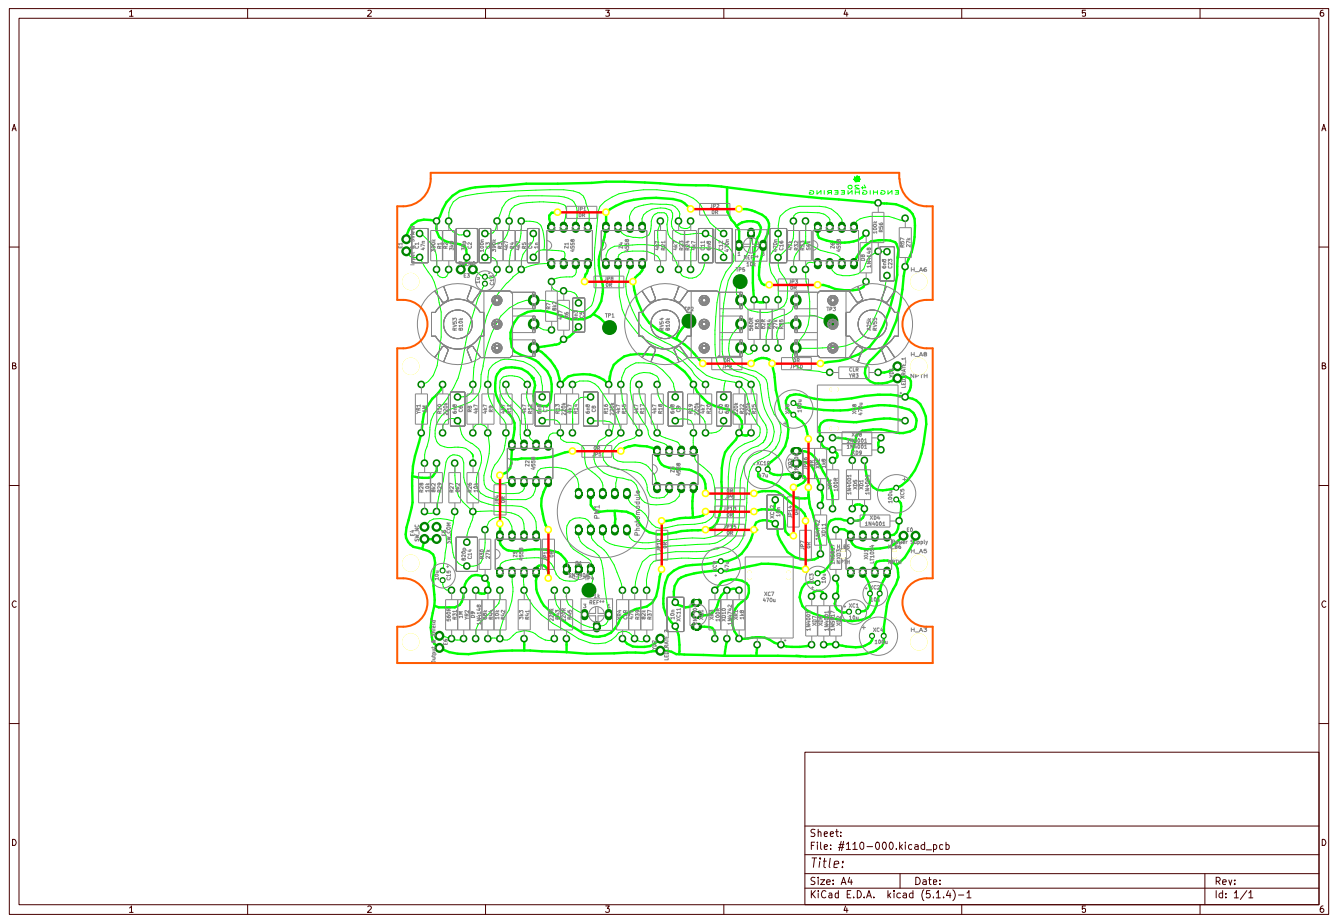
[picture p108: page 1]
