420-enghighneering/projects-kicad/PRJ-003 - Mu-Tron Phasor II/#110-000 - Phasor PCB/Design History/Power Supply On Module/#110-000.pdf

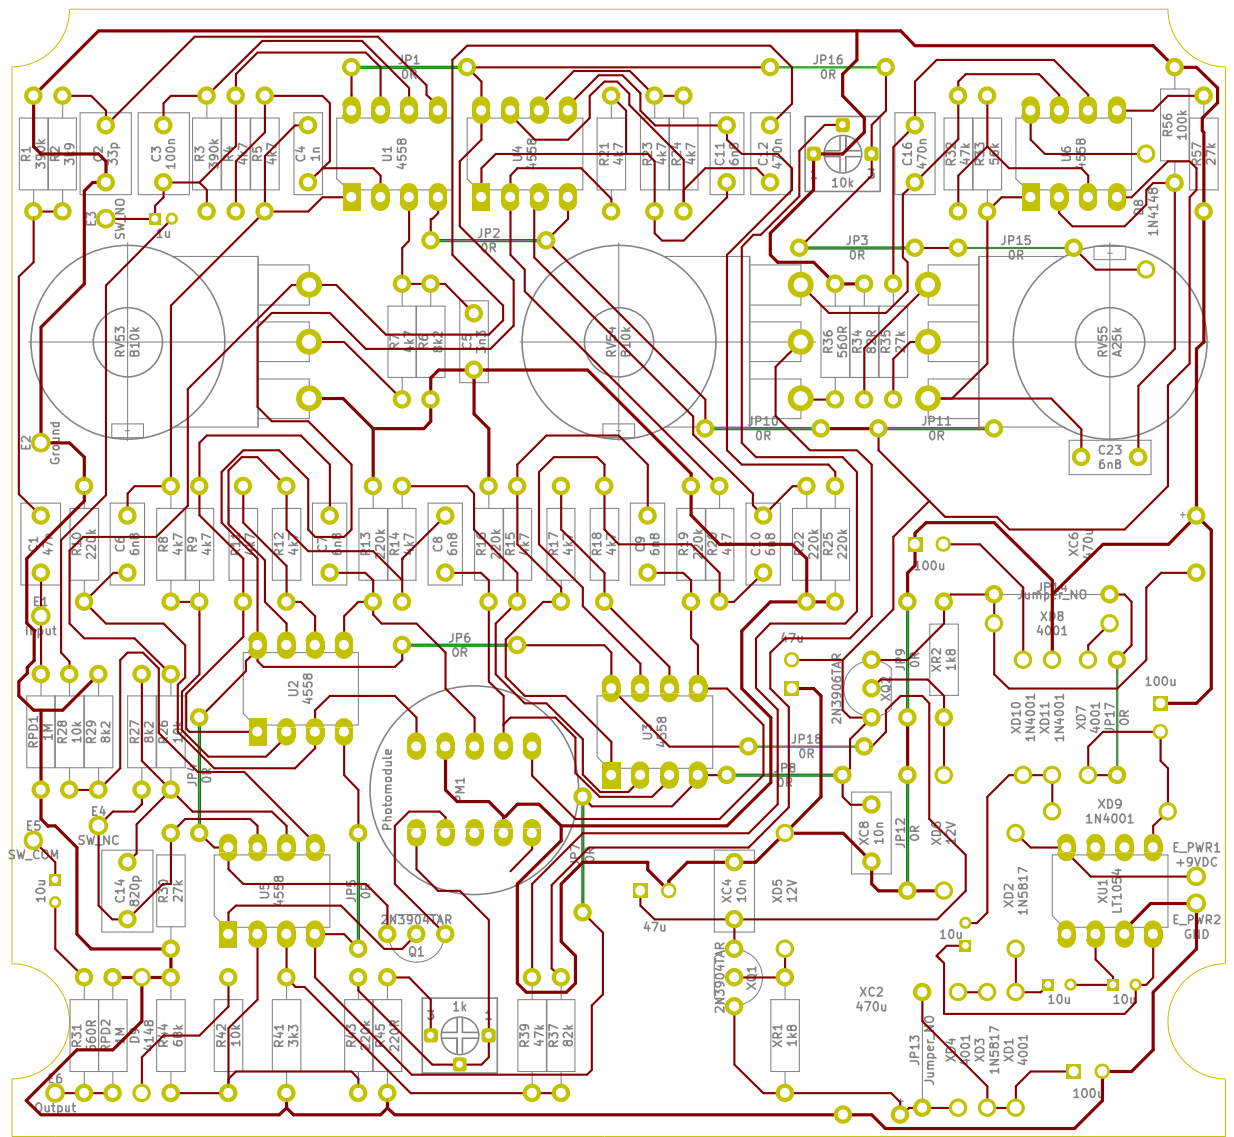
[picture p113: page 1]
