420-enghighneering/projects-kicad/PRJ-003 - Mu-Tron Phasor II/#800-000 - Finishing Materials/Logo etch/Logo etch-F_Cu.pdf

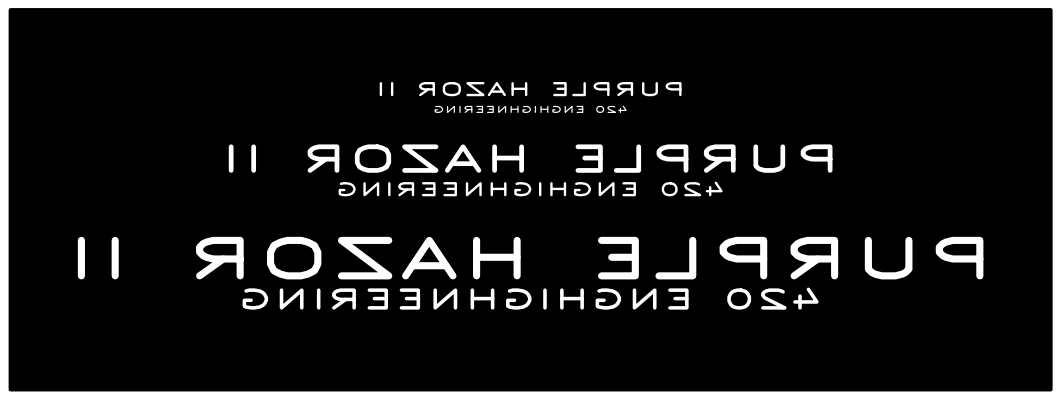
[picture p114: page 1]

420 ENGHIGHNEERING PURPLE HAZOR II
