420-enghighneering/projects-kicad/PRJ-003 - Mu-Tron Phasor II/#510-000 - Audio Jack PCB/#510-000-S1A - Audio Jack PCB [Input, Pads L]/#510-000-S1A - Audio Jack PCB [Input, Pads L].pdf

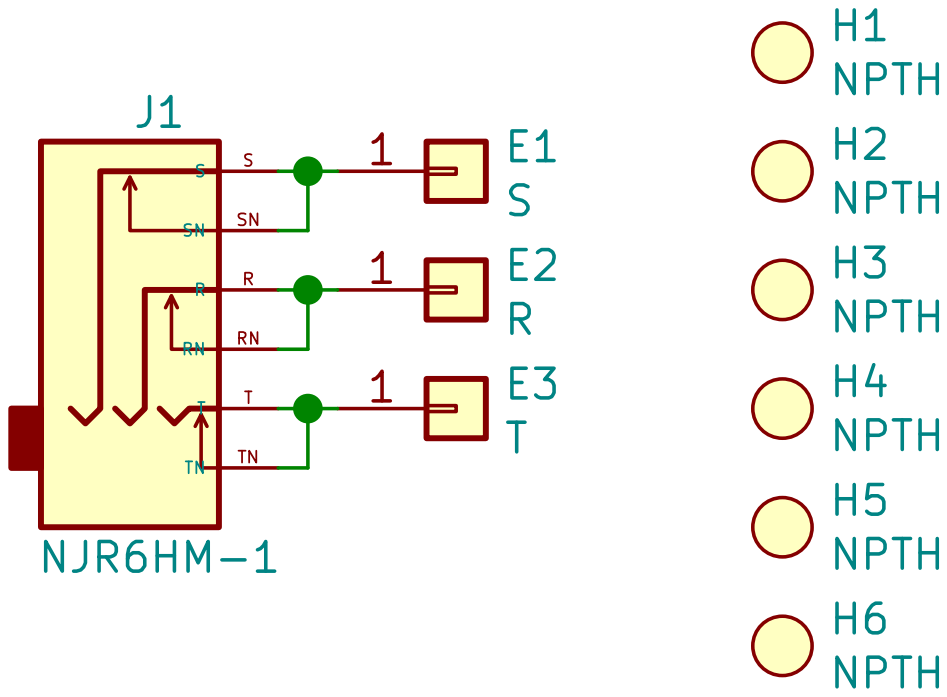
[picture p115: page 1]
