420-enghighneering/projects-kicad/PRJ-003 - Mu-Tron Phasor II/#510-000 - Audio Jack PCB/#510-000-S2A - Audio Jack PCB [Output, Pads R]/#510-000-S2A - Audio Jack PCB [Output, Pads R].pdf

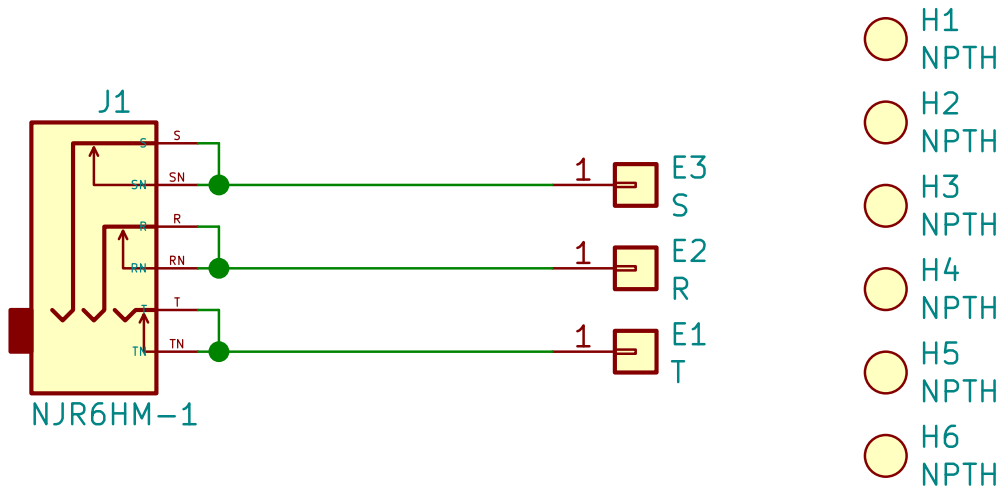
[picture p116: page 1]
