420-enghighneering/projects-kicad/PRJ-003 - Mu-Tron Phasor II/#510-000 - Audio Jack PCB/#510-000-S1A - Audio Jack PCB [Input, Pads L]/Plot/#510-000-S1A - Audio Jack PCB [Input, Pads L]-F_Mask.pdf

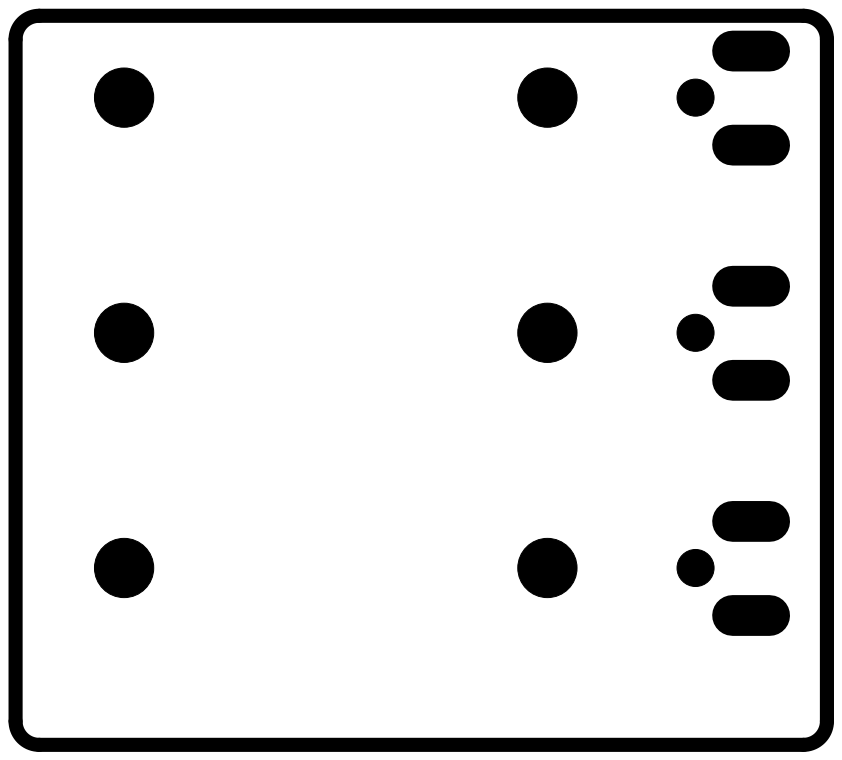
[picture p120: page 1]
