420-enghighneering/projects-kicad/PRJ-003 - Mu-Tron Phasor II/Simulation/osc_test.asc

C1: cap; .047µ
R1: res; 68k
R2: res; 12.5k
R3: res; 39k
R4: res; 12.5k
R5: res; 120R
R6: res; 47k
U1: OP07
U2: OP07
V1: voltage; 12
V2: voltage; -12
Named nets: 0, pos, neg
.tran 360000s startup
