420-enghighneering/projects-kicad/PRJ-003 - Mu-Tron Phasor II/Simulation/LPB1.asc

C1: cap; 0.1µ
Q1: npn; 2N3904
R1: res; 10k
R2: res; 390R
R3: res; 4.3k
R4: res; 43k
V1: voltage; 9
V2: voltage; SINE(0 0.1 1000)
Named nets: 0, +9VDC, OUTPUT, INPUT
.tran 0.005s
