420-enghighneering/projects-kicad/PRJ-003 - Mu-Tron Phasor II/Simulation/LT1054.asc

C1: cap; 10µ; Rser=15.92
C2: cap; 10µ; Rser=15.92
C3: cap; 10µ; Rser=15.92
C4: cap; 100µ; V=25 Rser=1.86
C5: cap; 100µ; V=25 Rser=1.86
C6: cap; 100µ; V=25 Rser=1.86
C7: cap; 47µ
C8: cap; .01µ
C9: cap; 47µ
C10: cap; .01µ
D1: zener; MMBZ12VAL
D2: diode; ICR
D3: diode; ICR
D4: diode; ICR
D5: diode; 1N5817
D6: diode; 1N5817
D7: zener; MMBZ12VAL
Q1: npn; 2N3904
Q2: pnp
R3: res; 1.8k
R4: res; 1.8k
R5: res; 100R
R6: res; 100R
U1: LT1054
V1: voltage; 9; Rser=1m
Named nets: 0, Vpos, Vpump+, Vpump-, Vpump+D, Vpump-D, VDC12P, VDC12N
.tran 0.1s
.model ICR D(Is=14.11n N=1.984 Rs=33.89m Ikf=94.81 Xti=3 Eg=1.11 Cjo=25.89p M=.44 Vj=.3245 Fc=.5 Bv=75 Ibv=10u Tt=5.7u Iave=1 Vpk=50 mfg=GI type=silicon)
Diode model taken from http://ltwiki.org/index.php?title=Standard.dio
Note, this is not an ideal diode (as indicated by 'ICR' model name,
but this doesn't produce sensible output voltages
.model 1N5817 D(Is=31.7u Rs=.051 N=1.373 Cjo=190p M=.3 Eg=.69 Xti=2 Iave=1 Vpk=20 mfg=OnSemi type=Schottky)
1N5817 provides higher negative output than 1N4001
560R load, negative switching diodes 1N5817, both rails 2x 1N5817 for add. voltage drop
ESTIMATED ESR FOR NICHICON UMA:
-------------------------------------------------------------
ESR = TAN(th) / 2 * PI * f * C
 
10u / 35V = 15.92R (!)
100u / 25V = 1.86R
 
14.77 / -14.705 for standard capacitors
14.855 / 13.777 for 0.1R ESR capacitors 10u
ESR 10u = 15.9 --> Vcc = 12.8V, Vdd = -9.6V
