420-enghighneering/projects-kicad/PRJ-003 - Mu-Tron Phasor II/Simulation/Mu-Tron Bi-Phase.asc

C1: cap; 10n
C2: cap; 10n
C3: cap; 10n
C4: cap; 10n
C5: cap; 47µ
C6: cap; 47µ
C7: cap; 470n
C8: cap; 470n
D1: diode
D2: diode
D3: diode
D4: diode
D5: diode
D6: diode
R1: res; 47k
R2: res; 39k
R3: res; 390k
R4: res; 120k
R5: res; 12R
R6: res; 12R
R7: res; 33k
R8: res; 39k
R9: res; 39k
R10: res; 33k
R11: res; 68k
R12: res; 47k
R13: res; 47k
R14: res; 120k
R15: res; 47k
U1: potentiometer; Rt=25K set=.5
U2: TL072
U3: potentiometer; Rt=1K set=.5
U4: TL072
U5: TL072
U6: TL072
U7: TL072
U8: potentiometer; Rt=22K set=.5
V1: voltage; 15
V2: voltage; 15
Named nets: 0, V+, V+d, V-d, V-, V+dd
.tran 2s
