420-enghighneering/projects-kicad/PRJ-003 - Mu-Tron Phasor II/Simulation/Mu-Tron Phasor II - Only LFO.asc

C16: cap; 470µ
C17: cap; 470µ
C18: cap; 47µ
C19: cap; .01µ
C20: cap; 47µ
C21: cap; .01µ
C22: cap; .0068µ
C23: cap; .47µ
D1: zener; MMBZ12VAL
D2: zener; MMBZ12VAL
D3: diode; 1N4148
D4: diode; 1N4148
D5: diode; 1N4148
D6: diode; 1N4148
D7: diode; 1N4148
D8: diode; 1N4148
D9: diode; 1N4148
D10: diode; 1N4148
D11: diode; 1N4148
D12: diode; 1N4148
D13: diode; 1N4148
D14: diode; 1N4148
D15: diode; 1N4148
Q1: npn; 2N3904
Q2: pnp
Q3: npn; 2N3904
R38: res; 1.8k
R39: res; 1.8k
R40: res; 100R
R41: res; 100R
R42: res; 56k
R43: res; 100k
R44: res; {25k*(1-RATE)}
R45: res; {25k*(RATE)}
R46: res; 27k
R47: res; 82R
R48: res; 47k
R49: res; 27k
R50: res; {10k*(1-DEPTH)}
R51: res; {10k*(DEPTH)}
R52: res; 82k
R53: res; 47k
R54: res; 3.3k
R55: res; {10k*(SWEEPOFFSET)}
R56: res; {10k*(1-SWEEPOFFSET)}
R57: res; 560R
R58: res; 220k
R59: res; 10k
R60: res; 68k
R61: res; 220R
R62: res; {1k*(1-SWEEPRANGE)}
R63: res; {1k*(SWEEPRANGE)}
U11: OP07
U12: OP07
U13: OP07
V2: voltage; SINE(0 15 60); Rser=0.1m
V3: voltage; SINE(0 -15 60); Rser=0.1m
Named nets: 0, Vneg, Vpos, OP1OUT, OP2OUT, OP3OUT, VDIODEPOS, VDIODENEG
Transient analysis for oscillator frequency:
.tran 1s startup
Stepping R:
.step param R15 1 9k 1k
.tran 0.2s
Sweep multiple component values:
.step param X list 1 2 3 4 5
.param R15=table(X, 1, 0.1k, 2, 2.5k, 3, 5k, 4, 7.5k, 5, 9.9k) R14=table(X, 1, 9.9k, 2, 7.5k, 3, 5k, 4, 2.5k, 5, 0.1k)
SWEEP OFFSET 10K
SWEEP RANGE 1K
RATE 
A25K
DEPTH
B10K
R1 value = {10k*(1-a)}
R2 value = {10k*a}
with a spice directive like one of:
.step param a list .1 .3 .6 .9
.param a = .5
.step param POTROTRATE list 0.01 0.33 0.66 0.99
.param POTROTRATE = 0.5
.step param POTROTDEPTH list 0.01 0.33 0.66 0.99
.param POTROTDEPTH = 0.5
.step param POTROTOFFSET list 0.01 0.33 0.66 0.99
.param POTROTOFFSET = 0.5
.step param POTROTRANGE list 0.01 0.33 0.66 0.99
.param POTROTRANGE = 0.5
.param RATE=0.99
.param DEPTH=0.99
.step param SWEEPRANGE list 0.1 0.25 0.5 0.75 0.9
.step param SWEEPOFFSET list 0.1 0.25 0.5 0.75 0.9
F=0.01, D=0.99, R=0.01, RANGE = 0.5, LDR = 50k -->
SWEEP OFFSET =0.2 --> Clips op3out and Vdiodepos at top
SWEEP OFFSET =0.35 --> Clips op3out and Vdiodepos at top
SWEEP OFFSET =0.50 --> Clips op3out and Vdiodepos at top (barely)
SWEEP OFFSET =0.65 --> 
SWEEP OFFSET =0.85 -->
SWEEP OFFSET 0.45 appears good, 0.4 better at higher rate
At 0.5 spike disappears, but not current peak limits
