420-enghighneering/projects-kicad/PRJ-003 - Mu-Tron Phasor II/Simulation/Mu-Tron Phasor II Power Supply.asc

C1: cap; 470µ
C2: cap; 470µ
C3: cap; 47µ
C4: cap; .01µ
C5: cap; 47µ
C6: cap; .01µ
D5: zener; MMBZ12VAL
D6: zener; MMBZ12VAL
D7: diode; 1N4148
D8: diode; 1N4148
D9: diode; 1N4148
D10: diode; 1N4148
Q1: npn; 2N3904
Q2: pnp
R1: res; 1.8k
R2: res; 1.8k
R5: res; 100R
R6: res; 100R
V1: voltage; SINE(0 -15 60); Rser=0.1m
V3: voltage; SINE(0 15 60); Rser=0.1m
Named nets: 0
.tran 5
