420-enghighneering/projects-kicad/PRJ-003 - Mu-Tron Phasor II/Simulation/Mu-Tron Phasor II Upd.asc

C1: cap; .047
C2: cap; 30p
C3: cap; 0.1µ
C4: cap; 0.001µ
C5: cap; 0.0033µ
C6: cap; 0.0068µ
C7: cap; 0.0068µ
C8: cap; 0.0068µ
C9: cap; 0.0068µ
C10: cap; 0.0068µ
C11: cap; 0.0068µ
C12: cap; .47µ
C13: cap; 1µ
C14: cap; 820p
C15: cap; 10µ
C22: cap; .0068µ
C23: cap; .47µ
D7: diode; 1N4148
D8: diode; 1N4148
D9: diode; 1N4148
D10: diode; 1N4148
D11: diode; 1N4148
D12: diode; 1N4148
D13: diode; 1N4148
D14: diode; 1N4148
D15: diode; 1N4148
Q3: npn; 2N3904
R1: res; 390k
R2: res; 3.9k
R3: res; 390k
R4: res; 4.7k
R5: res; 4.7k
R6: res; 4.7k
R7: res; 8.2k
R8: res; 4.7k
R9: res; 4.7k
R10: res; 4.7k
R11: res; 4.7k
R12: res; 4.7k
R13: res; 4.7k
R14: res; 4.7k
R15: res; 4.7k
R16: res; 4.7k
R17: res; 4.7k
R18: res; 4.7k
R19: res; 4.7k
R20: res; 220k
R21: res; {LDR1}
R22: res; 220k
R23: res; {LDR1}
R24: res; 220k
R25: res; {LDR1}
R26: res; 220k
R27: res; {LDR1}
R28: res; 220k
R29: res; {LDR1}
R30: res; 220k
R31: res; {LDR1}
R32: res; 10k
R33: res; 8.2k
R34: res; 10k
R35: res; 8.2k
R36: res; 27k
R37: res; 560R
R42: res; 56k
R43: res; 100k
R44: res; {25k*(1-RATE)}
R45: res; {25k*(RATE)}
R46: res; 27k
R47: res; 82R
R48: res; 47k
R49: res; 27k
R50: res; {10k*(1-DEPTH)}
R51: res; {10k*(DEPTH)}
R52: res; 82k
R53: res; 47k
R54: res; 3.3k
R55: res; {10k*(SWEEPOFFSET)}
R56: res; {10k*(1-SWEEPOFFSET)}
R57: res; 560R
R58: res; 220k
R59: res; 10k
R60: res; 68k
R61: res; 220R
R62: res; {1k*(1-SWEEPRANGE)}
R63: res; {1k*(SWEEPRANGE)}
R64: res; {10k*(1-FEEDBACK)}
R65: res; {10k*(1-FEEDBACK)}
U1: OP07
U2: OP07
U3: OP07
U4: OP07
U5: OP07
U6: OP07
U7: OP07
U8: OP07
U9: OP07
U11: OP07
U12: OP07
U13: OP07
V1: voltage; SINE(0 0.1 1000)
V2: voltage; 12
V3: voltage; 12
Named nets: 0, Vpos, Vneg, IN, PREDRY, WET, DRY, OUT, OP1OUT, OP2OUT, OP3OUT, VDIODEPOS, VDIODENEG
.param LDR1 25k
Transient analysis for oscillator frequency:
.tran 1s startup
Stepping R:
.step param R15 1 9k 1k
.op 0.01s startup
Sweep multiple component values:
.step param X list 1 2 3 4 5
.param R15=table(X, 1, 0.1k, 2, 2.5k, 3, 5k, 4, 7.5k, 5, 9.9k) R14=table(X, 1, 9.9k, 2, 7.5k, 3, 5k, 4, 2.5k, 5, 0.1k)
SWEEP OFFSET 10K
SWEEP RANGE 1K
RATE 
A25K
DEPTH
B10K
R1 value = {10k*(1-a)}
R2 value = {10k*a}
with a spice directive like one of:
.step param a list .1 .3 .6 .9
.param a = .5
.step param POTROTRATE list 0.01 0.33 0.66 0.99
.param POTROTRATE = 0.5
.step param POTROTDEPTH list 0.01 0.33 0.66 0.99
.param POTROTDEPTH = 0.5
.step param POTROTOFFSET list 0.01 0.33 0.66 0.99
.param POTROTOFFSET = 0.5
.step param POTROTRANGE list 0.01 0.33 0.66 0.99
.param POTROTRANGE = 0.5
.param RATE 0.5
.param DEPTH=0.99
.param FEEDBACK=0.01
.param SWEEPRANGE 0.5
.step param SWEEPOFFSET 0.01 0.99 0.3
.step param LDR1 list 1k 50k
F=0.01, D=0.99, R=0.01, RANGE = 0.5, LDR = 50k -->
SWEEP OFFSET =0.2 --> Clips op3out and Vdiodepos at top
SWEEP OFFSET =0.35 --> Clips op3out and Vdiodepos at top
SWEEP OFFSET =0.50 --> Clips op3out and Vdiodepos at top (barely)
SWEEP OFFSET =0.65 --> 
SWEEP OFFSET =0.85 -->
;tran 0.1s
Diode model taken from http://ltwiki.org/index.php?title=Standard.dio
Note, this is not an ideal diode (as indicated by 'ICR' model name,
but this doesn't produce sensible output voltages
1N5817 provides higher negative output than 1N4001
.model 1N5817 D(Is=31.7u Rs=.051 N=1.373 Cjo=190p M=.3 Eg=.69 Xti=2 Iave=1 Vpk=20 mfg=OnSemi type=Schottky)
.model ICR D(Is=14.11n N=1.984 Rs=33.89m Ikf=94.81 Xti=3 Eg=1.11 Cjo=25.89p M=.44 Vj=.3245 Fc=.5 Bv=75 Ibv=10u Tt=5.7u Iave=1 Vpk=50 mfg=GI type=silicon)
