420-enghighneering/projects-kicad/PRJ-003 - Mu-Tron Phasor II/Simulation/oscillator_fixed_comparison.asc

C1: cap; .0068µ
C2: cap; .47µ
C4: cap; .47µ
R1: res; 56k
R2: res; 100k
R3: res; 1k
R4: res; 24k
R5: res; 27k
R6: res; 82R
R7: res; 47k
R8: res; 27k
R9: res; 68k
R11: res; 1k
R12: res; 24k
R13: res; 39k
R14: res; 120R
R15: res; 47k
U1: OP07
U2: OP07
U3: OP07
U4: OP07
V1: voltage; 12
V2: voltage; -12
Named nets: 0, Vp, Vn
.tran 0.1s startup
