420-enghighneering/projects-kicad/PRJ-003 - Mu-Tron Phasor II/Simulation/oscillator_fixed_extended.asc

C1: cap; .0068µ
C2: cap; .47µ
D1: diode; 1N4148
D2: diode; 1N4148
D3: diode; 1N4148
D4: diode; 1N4148
D5: diode; 1N4148
D6: diode; 1N4148
Q1: npn; 2N3904
R1: res; 56k
R2: res; 100k
R3: res; {25k*(1-POTROTRATE)}
R4: res; {25k*(POTROTRATE)}
R5: res; 27k
R6: res; 82R
R7: res; 47k
R8: res; 27k
R9: res; {10k*(1-POTROTDEPTH)}
R10: res; {10k*(POTROTDEPTH)}
R11: res; 82k
R12: res; 47k
R13: res; 3.3k
R14: res; {10k*(POTROTOFFSET)}
R15: res; {10k*(1-POTROTOFFSET)}
R16: res; 560R
R17: res; 220k
R18: res; 10k
R19: res; 68k
R20: res; 220R
R21: res; {1k*(1-POTROTRANGE)}
R22: res; {1k*(POTROTRANGE)}
U1: OP07
U2: OP07
U3: OP07
V1: voltage; 12
V2: voltage; -12
Named nets: 0, Vp, Vn, OP1OUT, OP2OUT, OP3OUT, VDIODEPOS, VDIODENEG
Transient analysis for oscillator frequency:
.tran 1s startup
Stepping R:
.step param R15 1 9k 1k
.tran 10s startup
Sweep multiple component values:
.step param X list 1 2 3 4 5
.param R15=table(X, 1, 0.1k, 2, 2.5k, 3, 5k, 4, 7.5k, 5, 9.9k) R14=table(X, 1, 9.9k, 2, 7.5k, 3, 5k, 4, 2.5k, 5, 0.1k)
SWEEP OFFSET 10K
SWEEP RANGE 1K
RATE 
A25K
DEPTH
B10K
R1 value = {10k*(1-a)}
R2 value = {10k*a}
with a spice directive like one of:
.step param a list .1 .3 .6 .9
.param a = .5
.step param POTROTRATE list 0.01 0.33 0.66 0.99
.param POTROTRATE = 0.5
.step param POTROTDEPTH list 0.01 0.33 0.66 0.99
.param POTROTDEPTH = 0.5
.step param POTROTOFFSET list 0.01 0.33 0.66 0.99
.param POTROTOFFSET = 0.5
.step param POTROTRANGE list 0.01 0.33 0.66 0.99
.param POTROTRANGE = 0.5
