420-enghighneering/projects-kicad/PRJ-003 - Mu-Tron Phasor II/Simulation/oscillator_pots.asc

C1: cap; .0068µ
C2: cap; .47µ
D1: diode; 1N4148
D2: diode; 1N4148
D3: diode; 1N4148
D4: diode; 1N4148
D5: diode; 1N4148
D6: diode; 1N4148
Q1: npn; 2N3904
R1: res; 56k
R2: res; 100k
R5: res; 27k
R6: res; 82R
R7: res; 47k
R8: res; 27k
R11: res; 82k
R12: res; 47k
R13: res; 3.3k
R16: res; 560R
R17: res; 220k
R18: res; 10k
R19: res; 68k
R20: res; 220R
U1: OP07
U2: OP07
U3: OP07
U4: potentiometer; Rt=10K set={SWEEPOFFSET}
U5: potentiometer
U6: potentiometer; Rt=1K set=0.25
U8: potentiometer; Rt=25K set=0.01
U9: potentiometer; Rt=10K set=0.75
V1: voltage; 12
V2: voltage; -12
Named nets: 0, Vp, Vn, OP1OUT, OP2OUT, OP3OUT, VDIODEPOS, VDIODENEG
.tran 1s startup
SWEEP OFFSET 10K
SWEEP RANGE 1K
RATE 
A25K
DEPTH
B10K
.step param RATE list 0.1 0.5 1
.step param DEPTH list 0.1 0.5 1
.step param SWEEPOFFSET list 0.15 0.4 0.6 0.85
.step param SWEEPRANGE list 0.5
