420-enghighneering/projects-kicad/PRJ-003 - Mu-Tron Phasor II/#110-000 - Phasor PCB/Design History/#110-000.kicad_pcb

## KiCad design PRJ-003 - Mu-Tron Phasor II/#110-000 - Phasor PCB/Design History/#110-000.kicad_pcb (2021-03-29)

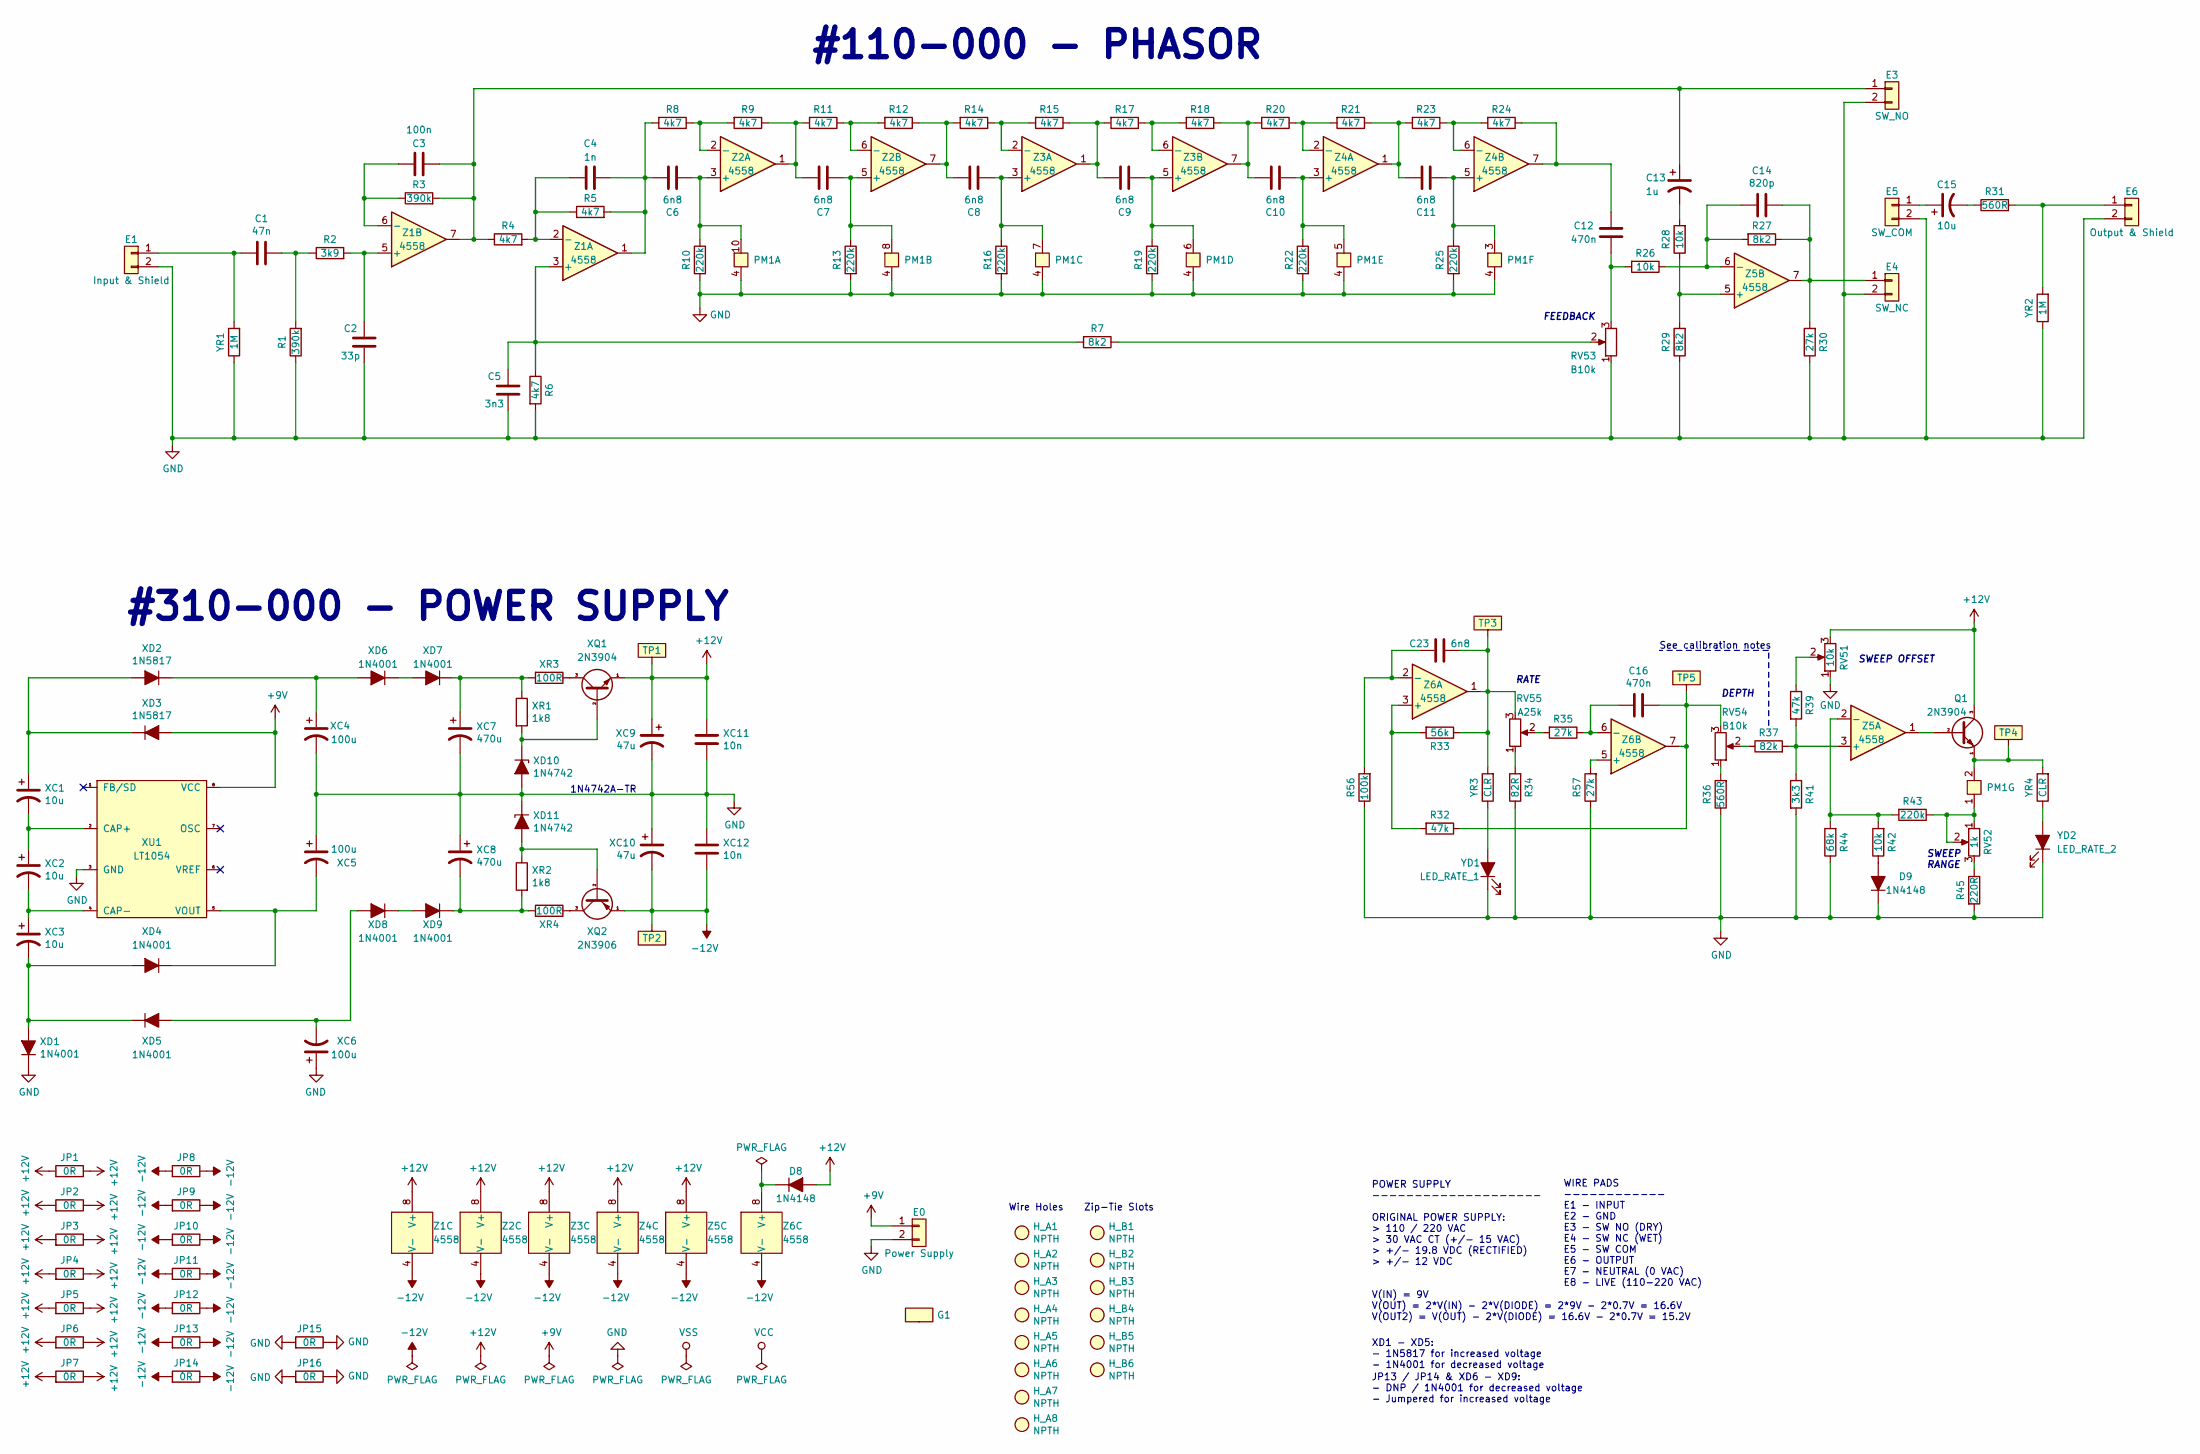
[picture p123: schematic #110-000.sch]

Parts:
C1: 47n; C_MKS2F024701C00KSSD
C2: 33p; C_FKP2O100331D00JSSD
C3: 100n; C_MKS2C031001A00KSSD
C4: 1n; C_FKS2G011001A00KSSD
C5: 3n3; C_FKS2G013301A00KSSD
C6, C7, C8, C9, C10, C11, C23: 6n8; C_FKS2G016801B00KSSD
C12, C16: 470n; C_MKS2C034701C00KSSD
C13: 1u; C_UMA1H010MDD
C14: 820p; C_FKP2J008201D00HSSD
C15: 10u; C_UMA1V100MDD
D8, D9: 1N4148; D_P10.16_DO35
E0: Power Supply; E_WIRE_PAD_2x
E1: Input & Shield; E_WIRE_PAD_2x
E3: SW_NO; E_WIRE_PAD_2x
E4: SW_NC; E_WIRE_PAD_2x
E5: SW_COM; E_WIRE_PAD_2x
E6: Output & Shield; E_WIRE_PAD_2x
G1: Logo; Logo_36kdpi
H_A1, H_A2, H_A3, H_A4, H_A5, H_A6, H_A7, H_A8: NPTH; H_NPTH
H_B1, H_B2, H_B3, H_B4, H_B5, H_B6: NPTH; E_ZIPTIE_NPTH
JP1, JP2, JP3, JP4, JP5, JP6, JP7, JP8, JP9, JP10, JP11, JP12, JP13, JP14, JP15, JP16: 0R; R_0R_JUMPER_P10.16
PM1: Photomodule; PM_DIP-10
Q1: 2N3904; Q_P2.54
R1, R3: 390k; R_P10.16
R2: 3k9; R_P10.16
R4, R5, R6, R8, R9, R11, R12, R14, R15, R17, R18, R20, R21, R23, R24: 4k7; R_P10.16
R7, R27, R29: 8k2; R_P10.16
R10, R13, R16, R19, R22, R25, R43: 220k; R_P10.16
R26, R28, R42: 10k; R_P10.16
R30, R35, R57: 27k; R_P10.16
R31, R36: 560R; R_P10.16
R32, R39: 47k; R_P10.16
R33: 56k; R_P10.16
R34: 82R; R_P10.16
R37: 82k; R_P10.16
R41: 3k3; R_P10.16
R44: 68k; R_P10.16
R45: 220R; R_P10.16
R56: 100k; R_P10.16
RV51: 10k; R_TRIM
RV52: 1k; R_TRIM
RV53, RV54: B10k; R_POT
RV55: A25k; R_POT
TP1: TP1; TP_SMD_R_3mm
TP2: TP2; TP_SMD_R_3mm
TP3: TP3; TP_SMD_R_3mm
TP4: TP4; TP_SMD_R_3mm
TP5: TP5; TP_SMD_R_3mm
XC1, XC2, XC3: 10u; C_UMA1V100MDD
XC4, XC5, XC6: 100u; C_UMA1E101MDD
XC7, XC8: 470u; C_ANGLED
XC9, XC10: 47u; C_UMA1V470MDD
XC11, XC12: 10n; C_FKS2G021001C00KSSD
XD1, XD4, XD5, XD6, XD7, XD8, XD9: 1N4001; D_P10.16
XD2, XD3: 1N5817; D_P10.16
XD10, XD11: 1N4742; D_P10.16_DO35
XQ1: 2N3904; Q_P2.54
XQ2: 2N3906; Q_P2.54
XR1, XR2: 1k8; R_P10.16
XR3, XR4: 100R; R_P10.16
XU1: LT1054; U_DIP-8
YD1: LED_RATE_1; E_WIRE_PAD_2x
YD2: LED_RATE_2; E_WIRE_PAD_2x
YR1, YR2: 1M; R_P10.16
YR3, YR4: CLR; R_P10.16
Z1, Z2, Z3, Z4, Z5, Z6: 4558; U_DIP-8

Connections:
+9V: E0.1, XD3.1 (A), XU1.8 (VCC)
+12V: D8.1 (A), JP1.1, JP1.2, JP2.1, JP2.2, JP3.1, JP3.2, JP4.1, JP4.2, JP5.1, JP5.2, JP6.1, JP6.2, JP7.1, JP7.2, Q1.3 (C), RV51.3, TP1.1, XC9.1, XC11.1, XQ1.1 (E), Z1.8 (V+), Z2.8 (V+), Z3.8 (V+), Z4.8 (V+), Z5.8 (V+)
-12V: JP8.1, JP8.2, JP9.1, JP9.2, JP10.1, JP10.2, JP11.1, JP11.2, JP12.1, JP12.2, JP13.1, JP13.2, JP14.1, JP14.2, TP2.1, XC10.2, XC12.2, XQ2.1 (E), Z1.4 (V-), Z2.4 (V-), Z3.4 (V-), Z4.4 (V-), Z5.4 (V-), Z6.4 (V-)
GND: C2.2, C5.2, D9.2 (K), E0.2, E1.2, E3.2, E4.2, E5.2, E6.2, JP15.1, JP15.2, JP16.1, JP16.2, PM1.4, PM1.9, R1.1, R6.2, R10.2, R13.2, R16.2, R19.2, R22.2, R25.2, R29.1, R30.1, R34.1, R36.1, R41.2, R44.1, R45.2, R56.1, R57.1, RV51.1, RV53.1, XC4.2, XC5.1, XC6.1, XC7.2, XC8.1, XC9.2, XC10.1, XC11.2, XC12.1, XD1.2 (K), XD10.1 (A), XD11.2 (K), XU1.3 (GND), YD1.1 (K), YD2.1 (K), YR1.1, YR2.1
unnamed: C1.1, E1.1, YR1.2
unnamed: C1.2, R1.2, R2.1
unnamed: C2.1, R2.2, Z1.5 (+)
unnamed: C3.1, R3.1, Z1.6 (-)
unnamed: C4.1, R4.2, R5.1, Z1.2 (-)
unnamed: C4.2, C6.1, R5.2, R8.2, Z1.1
unnamed: C5.1, R6.1, R7.2, Z1.3 (+)
unnamed: C6.2, PM1.10, R10.1, Z2.3 (+)
unnamed: C7.1, R9.1, R11.2, Z2.1
unnamed: C7.2, PM1.8, R13.1, Z2.5 (+)
unnamed: C8.1, R12.1, R14.2, Z2.7
unnamed: C8.2, PM1.7, R16.1, Z3.3 (+)
unnamed: C9.1, R15.1, R17.2, Z3.1
unnamed: C9.2, PM1.6, R19.1, Z3.5 (+)
unnamed: C10.1, R18.1, R20.2, Z3.7
unnamed: C10.2, PM1.5, R22.1, Z4.3 (+)
unnamed: C11.1, R21.1, R23.2, Z4.1
unnamed: C11.2, PM1.3, R25.1, Z4.5 (+)
unnamed: C12.1, R24.1, Z4.7
unnamed: C12.2, R26.2, RV53.3
unnamed: C3.2, C13.1, E3.1, R3.2, R4.1, Z1.7
unnamed: C13.2, R28.2
unnamed: C14.1, R26.1, R27.2, Z5.6 (-)
unnamed: C14.2, E4.1, R27.1, R30.2, Z5.7
unnamed: C15.1, E5.1
unnamed: C15.2, R31.1
unnamed: C16.1, R35.1, Z6.6 (-)
unnamed: C16.2, R32.1, RV54.3, TP5.1, Z6.7
unnamed: C23.1, R56.2, Z6.2 (-)
unnamed: C23.2, R33.1, RV55.3, TP3.1, YR3.2, Z6.1
unnamed: D8.2 (K), Z6.8 (V+)
unnamed: D9.1 (A), R42.1
unnamed: E6.1, R31.2, YR2.2
unnamed: PM1.1, R43.1, RV52.1, RV52.2
unnamed: PM1.2, Q1.1 (E), TP4.1, YR4.2
unnamed: Q1.2 (B), Z5.1
unnamed: R7.1, RV53.2
unnamed: R8.1, R9.2, Z2.2 (-)
unnamed: R11.1, R12.2, Z2.6 (-)
unnamed: R14.1, R15.2, Z3.2 (-)
unnamed: R17.1, R18.2, Z3.6 (-)
unnamed: R20.1, R21.2, Z4.2 (-)
unnamed: R23.1, R24.2, Z4.6 (-)
unnamed: R28.1, R29.2, Z5.5 (+)
unnamed: R32.2, R33.2, Z6.3 (+)
unnamed: R34.2, RV55.1
unnamed: R35.2, RV55.2
unnamed: R36.2, RV54.1
unnamed: R37.1, RV54.2
unnamed: R37.2, R39.2, R41.1, Z5.3 (+)
unnamed: R39.1, RV51.2
unnamed: R42.2, R43.2, R44.2, Z5.2 (-)
unnamed: R45.1, RV52.3
unnamed: R57.2, Z6.5 (+)
unnamed: XC1.1, XD2.1 (A), XD3.2 (K)
unnamed: XC1.2, XC2.1, XU1.2 (CAP+)
unnamed: XC2.2, XC3.1, XU1.4 (CAP-)
unnamed: XC3.2, XD1.1 (A), XD4.1 (A), XD5.2 (K)
unnamed: XC4.1, XD2.2 (K), XD6.1 (A)
unnamed: XC5.2, XD4.2 (K), XU1.5 (VOUT)
unnamed: XC6.2, XD5.1 (A), XD8.1 (A)
unnamed: XC7.1, XD7.2 (K), XR1.1, XR3.2
unnamed: XC8.2, XD9.2 (K), XR2.2, XR4.2
unnamed: XD6.2 (K), XD7.1 (A)
unnamed: XD8.2 (K), XD9.1 (A)
unnamed: XD10.2 (K), XQ1.2 (B), XR1.2
unnamed: XD11.1 (A), XQ2.2 (B), XR2.1
unnamed: XQ1.3 (C), XR3.1
unnamed: XQ2.3 (C), XR4.1
unnamed: YD1.2 (A), YR3.1
unnamed: YD2.2 (A), YR4.1

Notes on the sheet:
1N4742A-TR
POWER SUPPLY -------------------- ORIGINAL POWER SUPPLY: > 110 / 220 VAC > 30 VAC CT (+/- 15 VAC) > +/- 19.8 VDC (RECTIFIED) > +/- 12 VDC V(IN) = 9V V(OUT) = 2*V(IN) - 2*V(DIODE) = 2*9V - 2*0.7V = 16.6V V(OUT2) = V(OUT) - 2*V(DIODE) = 16.6V - 2*0.7V = 15.2V
SWEEP OFFSET
SWEEP RANGE
DEPTH
RATE
FEEDBACK
WIRE PADS ------------ E1 - INPUT E2 - GND E3 - SW NO (DRY) E4 - SW NC (WET) E5 - SW COM E6 - OUTPUT E7 - NEUTRAL (0 VAC) E8 - LIVE (110-220 VAC)
XD1 - XD5: - 1N5817 for increased voltage - 1N4001 for decreased voltage
JP13 / JP14 & XD6 - XD9: - DNP / 1N4001 for decreased voltage - Jumpered for increased voltage
#310-000 - POWER SUPPLY
#110-000 - PHASOR
See calibration notes
Zip-Tie Slots
Wire Holes

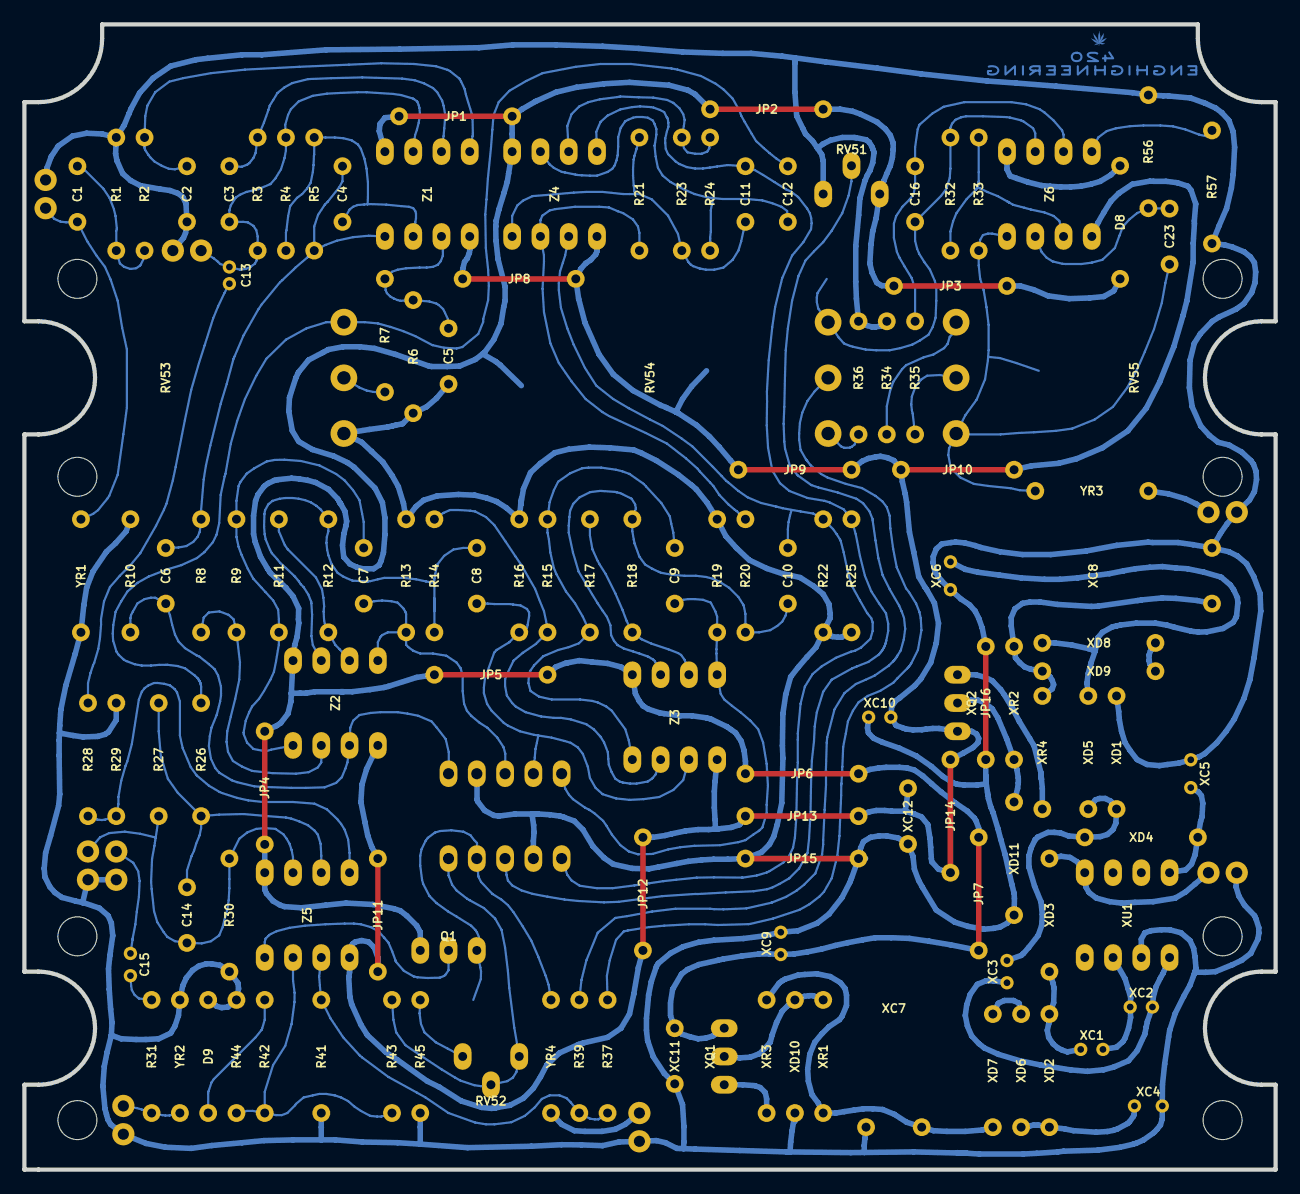
[picture p124: board PRJ-003 - Mu-Tron Phasor II/#110-000 - Phasor PCB/Design History/#110… from above]

Board: 2 copper layers, 112.4 x 102.9 mm, 155 parts (0 on the bottom side), 75 nets.
