420-enghighneering/projects-kicad/PRJ-003 - Mu-Tron Phasor II/#110-000 - Phasor PCB/Design History/A/#110-000.kicad_pcb

## KiCad design PRJ-003 - Mu-Tron Phasor II/#110-000 - Phasor PCB/Design History/A/#110-000.kicad_pcb (2021-03-29)

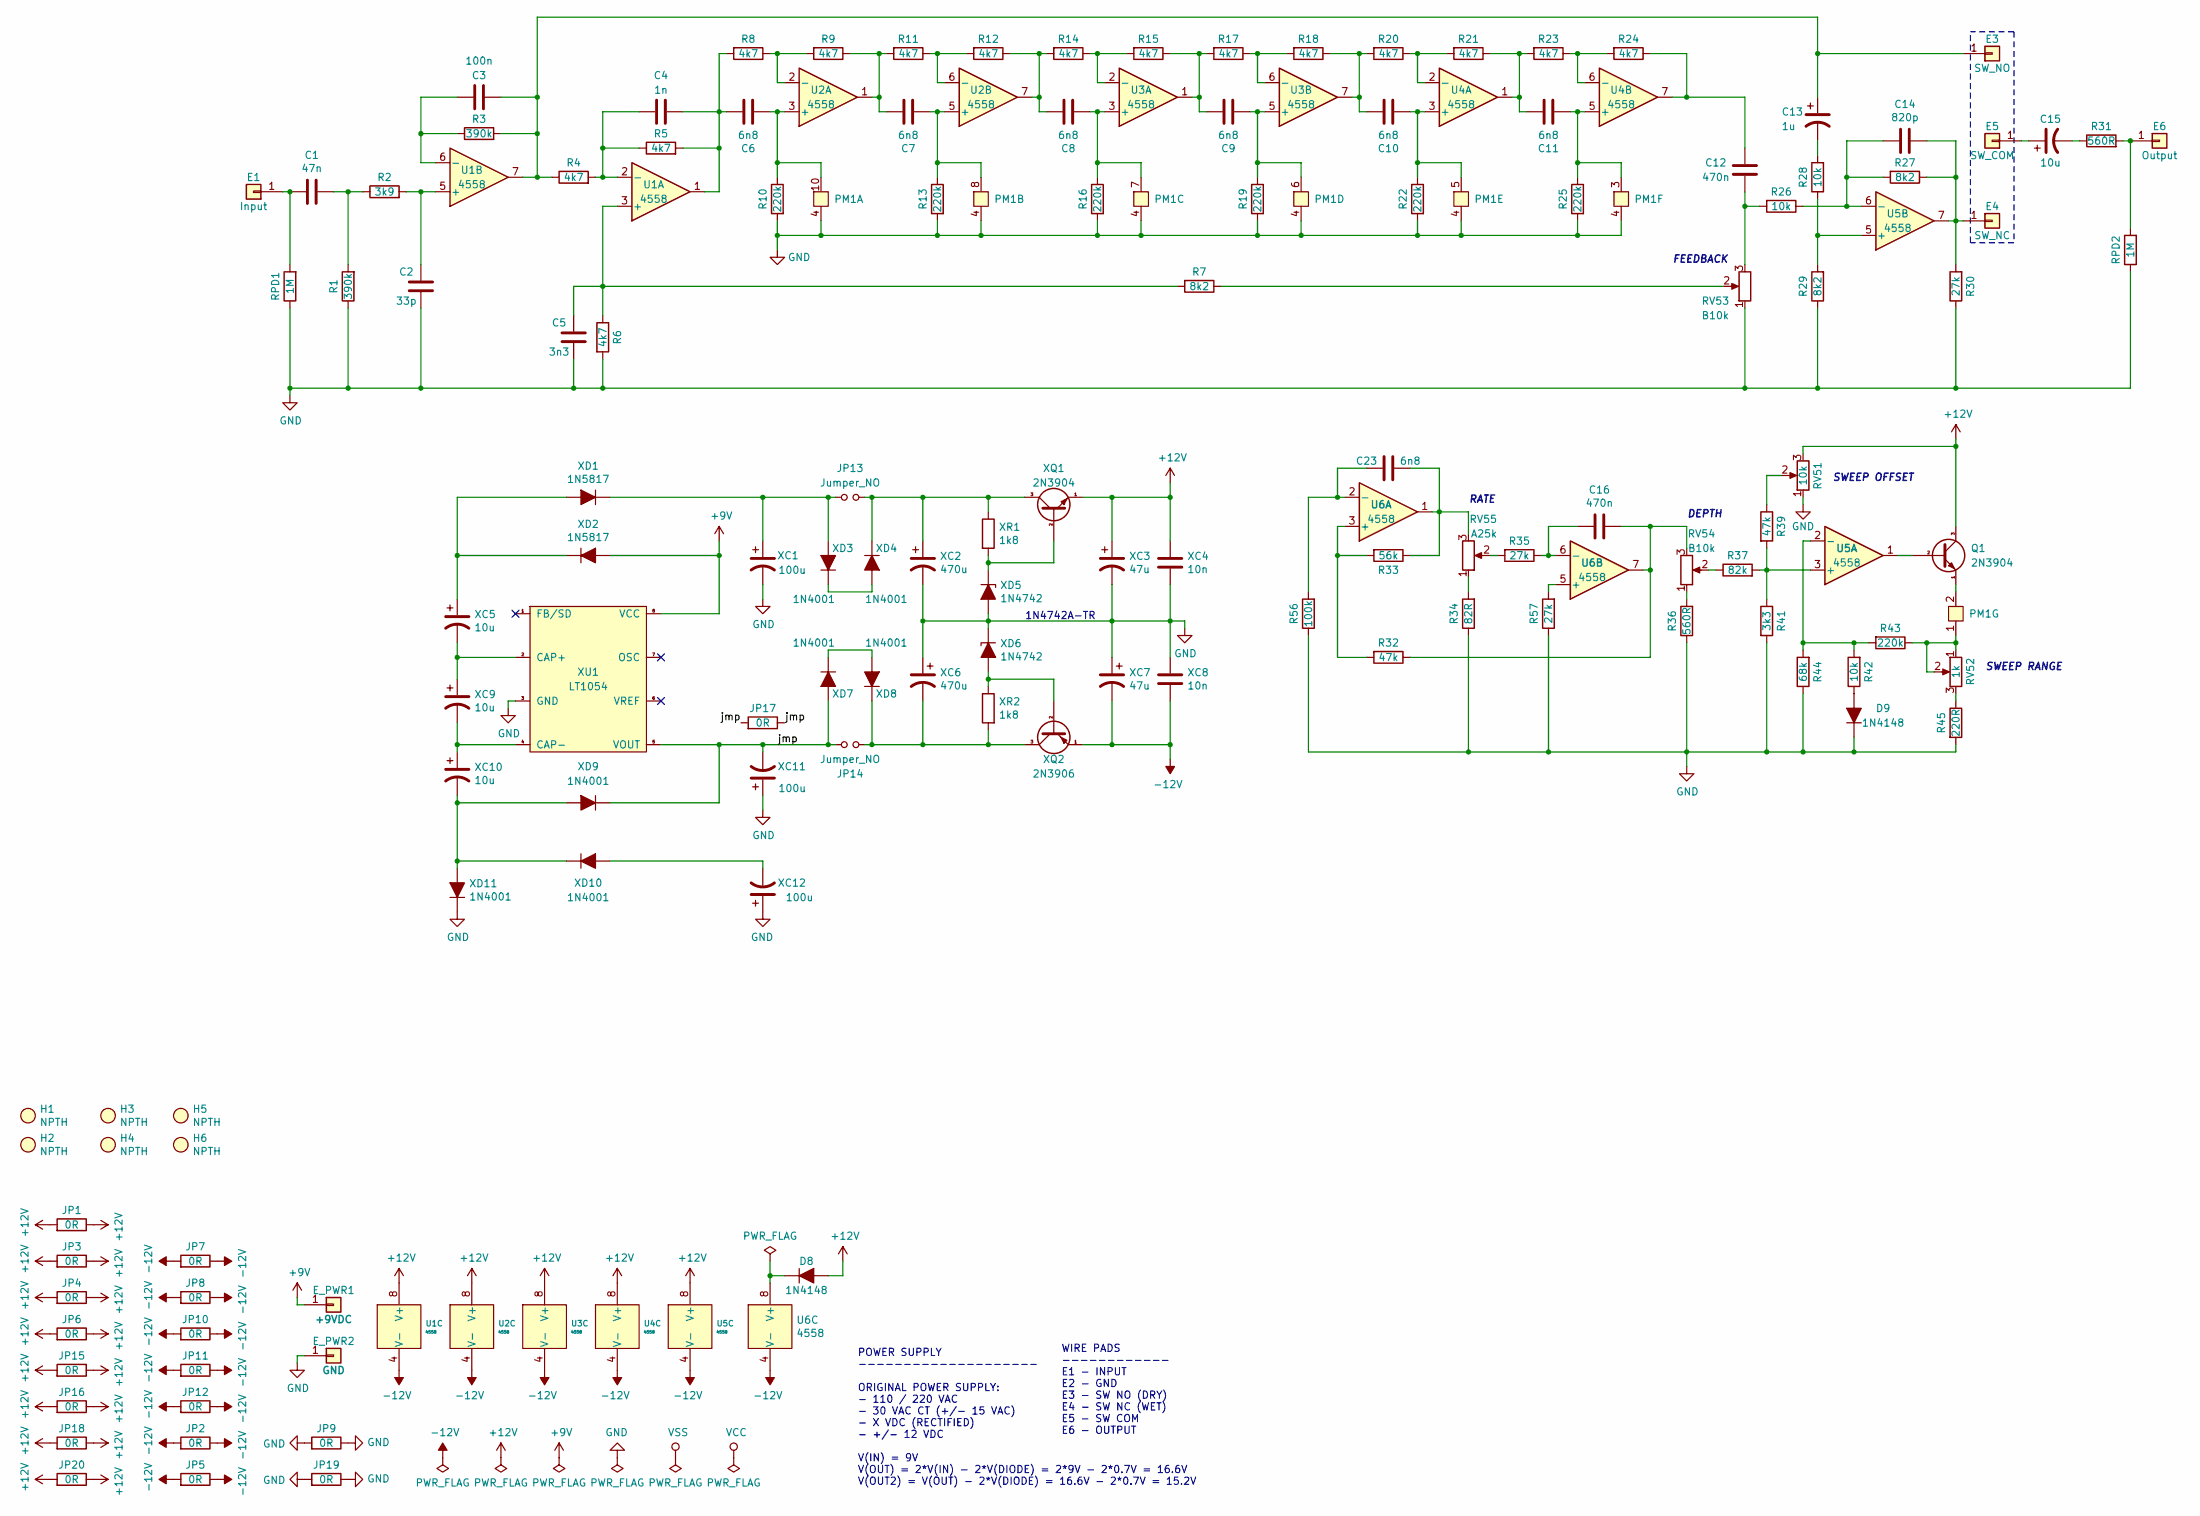
[picture p125: schematic #110-000.sch]

Parts:
C1: 47n; C_MKS2F024701C00KSSD
C2: 33p; C_FKP2O100331D00JSSD
C3: 100n; C_MKS2C031001A00KSSD
C4: 1n; C_FKS2G011001A00KSSD
C5: 3n3; C_FKS2G013301A00KSSD
C6, C7, C8, C9, C10, C11, C23: 6n8; C_FKS2G016801B00KSSD
C12, C16: 470n; C_MKS2C034701C00KSSD
C13: 1u; C_UMA1H010MDD
C14: 820p; C_FKP2J008201D00HSSD
C15: 10u; C_UMA1V100MDD
D8, D9: 1N4148; D_P10.16
E1: Input; E_WIRE_PAD
E3: SW_NO; E_WIRE_PAD
E4: SW_NC; E_WIRE_PAD
E5: SW_COM; E_WIRE_PAD
E6: Output; E_WIRE_PAD
E_PWR1: +9VDC; E_WIRE_PAD
E_PWR2: GND; E_WIRE_PAD
H1, H2, H3, H4, H5, H6: NPTH; E_ZIPTIE_NPTH
JP1, JP2, JP3, JP4, JP5, JP6, JP7, JP8, JP9, JP10, JP11, JP12, JP15, JP16, JP17, JP18, JP19, JP20: 0R; R_0R_JUMPER_P10.16
JP13, JP14: Jumper_NO; R_NO_JUMPER_P10.16
PM1: Photomodule; PM_DIP-10
Q1: 2N3904; Q_P2.54
R1, R3: 390k; R_P10.16
R2: 3k9; R_P10.16
R4, R5, R6, R8, R9, R11, R12, R14, R15, R17, R18, R20, R21, R23, R24: 4k7; R_P10.16
R7, R27, R29: 8k2; R_P10.16
R10, R13, R16, R19, R22, R25, R43: 220k; R_P10.16
R26, R28, R42: 10k; R_P10.16
R30, R35, R57: 27k; R_P10.16
R31, R36: 560R; R_P10.16
R32, R39: 47k; R_P10.16
R33: 56k; R_P10.16
R34: 82R; R_P10.16
R37: 82k; R_P10.16
R41: 3k3; R_P10.16
R44: 68k; R_P10.16
R45: 220R; R_P10.16
R56: 100k; R_P10.16
RPD1, RPD2: 1M; R_P10.16
RV51: 10k; R_TRIM
RV52: 1k; R_TRIM
RV53, RV54: B10k; R_POT
RV55: A25k; R_POT
U1, U2, U3, U4, U5, U6: 4558; U_DIP-8
XC1, XC11, XC12: 100u; C_UMA1E101MDD
XC2, XC6: 470u; C_ANGLED
XC3, XC7: 47u; C_UMA1V470MDD
XC4, XC8: 10n; C_FKS2G021001C00KSSD
XC5, XC9, XC10: 10u; C_UMA1V100MDD
XD1, XD2: 1N5817; D_P10.16
XD3, XD4, XD7, XD8, XD9, XD10, XD11: 1N4001; D_P10.16
XD5, XD6: 1N4742; D_P10.16
XQ1: 2N3904; Q_P2.54
XQ2: 2N3906; Q_P2.54
XR1, XR2: 1k8; R_P10.16
XU1: LT1054; U_DIP-8

Connections:
+9V: E_PWR1.1, XD2.1 (A), XU1.8 (VCC)
+12V: D8.1 (A), JP1.1, JP1.2, JP3.1, JP3.2, JP4.1, JP4.2, JP6.1, JP6.2, JP15.1, JP15.2, JP16.1, JP16.2, JP18.1, JP18.2, JP20.1, JP20.2, Q1.3 (C), RV51.3, U1.8 (V+), U2.8 (V+), U3.8 (V+), U4.8 (V+), U5.8 (V+), XC3.1, XC4.1, XQ1.1 (E)
-12V: JP2.1, JP2.2, JP5.1, JP5.2, JP7.1, JP7.2, JP8.1, JP8.2, JP10.1, JP10.2, JP11.1, JP11.2, JP12.1, JP12.2, U1.4 (V-), U2.4 (V-), U3.4 (V-), U4.4 (V-), U5.4 (V-), U6.4 (V-), XC7.2, XC8.2, XQ2.1 (E)
/jmp: JP14.1, JP17.1, JP17.2, XC11.2, XD7.1 (A), XD9.2 (K), XU1.5 (VOUT)
GND: C2.2, C5.2, D9.2 (K), E_PWR2.1, JP9.1, JP9.2, JP19.1, JP19.2, PM1.4, PM1.9, R1.1, R6.2, R10.2, R13.2, R16.2, R19.2, R22.2, R25.2, R29.1, R30.1, R34.1, R36.1, R41.2, R44.1, R45.2, R56.1, R57.1, RPD1.1, RPD2.1, RV51.1, RV53.1, XC1.2, XC2.2, XC3.2, XC4.2, XC6.1, XC7.1, XC8.1, XC11.1, XC12.1, XD5.1 (A), XD6.2 (K), XD11.2 (K), XU1.3 (GND)
unnamed: C1.1, E1.1, RPD1.2
unnamed: C1.2, R1.2, R2.1
unnamed: C2.1, R2.2, U1.5 (+)
unnamed: C3.1, R3.1, U1.6 (-)
unnamed: C4.1, R4.2, R5.1, U1.2 (-)
unnamed: C4.2, C6.1, R5.2, R8.2, U1.1
unnamed: C5.1, R6.1, R7.2, U1.3 (+)
unnamed: C6.2, PM1.10, R10.1, U2.3 (+)
unnamed: C7.1, R9.1, R11.2, U2.1
unnamed: C7.2, PM1.8, R13.1, U2.5 (+)
unnamed: C8.1, R12.1, R14.2, U2.7
unnamed: C8.2, PM1.7, R16.1, U3.3 (+)
unnamed: C9.1, R15.1, R17.2, U3.1
unnamed: C9.2, PM1.6, R19.1, U3.5 (+)
unnamed: C10.1, R18.1, R20.2, U3.7
unnamed: C10.2, PM1.5, R22.1, U4.3 (+)
unnamed: C11.1, R21.1, R23.2, U4.1
unnamed: C11.2, PM1.3, R25.1, U4.5 (+)
unnamed: C12.1, R24.1, U4.7
unnamed: C12.2, R26.2, RV53.3
unnamed: C3.2, C13.1, E3.1, R3.2, R4.1, U1.7
unnamed: C13.2, R28.2
unnamed: C14.1, R26.1, R27.2, U5.6 (-)
unnamed: C14.2, E4.1, R27.1, R30.2, U5.7
unnamed: C15.1, E5.1
unnamed: C15.2, R31.1
unnamed: C16.1, R35.1, U6.6 (-)
unnamed: C16.2, R32.1, RV54.3, U6.7
unnamed: C23.1, R56.2, U6.2 (-)
unnamed: C23.2, R33.1, RV55.3, U6.1
unnamed: D8.2 (K), U6.8 (V+)
unnamed: D9.1 (A), R42.1
unnamed: E6.1, R31.2, RPD2.2
unnamed: JP13.1, XC1.1, XD1.2 (K), XD3.1 (A)
unnamed: JP13.2, XC2.1, XD4.2 (K), XQ1.3 (C), XR1.1
unnamed: JP14.2, XC6.2, XD8.2 (K), XQ2.3 (C), XR2.2
unnamed: PM1.1, R43.1, RV52.1, RV52.2
unnamed: PM1.2, Q1.1 (E)
unnamed: Q1.2 (B), U5.1
unnamed: R7.1, RV53.2
unnamed: R8.1, R9.2, U2.2 (-)
unnamed: R11.1, R12.2, U2.6 (-)
unnamed: R14.1, R15.2, U3.2 (-)
unnamed: R17.1, R18.2, U3.6 (-)
unnamed: R20.1, R21.2, U4.2 (-)
unnamed: R23.1, R24.2, U4.6 (-)
unnamed: R28.1, R29.2, U5.5 (+)
unnamed: R32.2, R33.2, U6.3 (+)
unnamed: R34.2, RV55.1
unnamed: R35.2, RV55.2
unnamed: R36.2, RV54.1
unnamed: R37.1, RV54.2
unnamed: R37.2, R39.2, R41.1, U5.3 (+)
unnamed: R39.1, RV51.2
unnamed: R42.2, R43.2, R44.2, U5.2 (-)
unnamed: R45.1, RV52.3
unnamed: R57.2, U6.5 (+)
unnamed: XC5.1, XD1.1 (A), XD2.2 (K)
unnamed: XC5.2, XC9.1, XU1.2 (CAP+)
unnamed: XC9.2, XC10.1, XU1.4 (CAP-)
unnamed: XC10.2, XD9.1 (A), XD10.2 (K), XD11.1 (A)
unnamed: XC12.2, XD10.1 (A)
unnamed: XD3.2 (K), XD4.1 (A)
unnamed: XD5.2 (K), XQ1.2 (B), XR1.2
unnamed: XD6.1 (A), XQ2.2 (B), XR2.1
unnamed: XD7.2 (K), XD8.1 (A)

Notes on the sheet:
1N4742A-TR
POWER SUPPLY -------------------- ORIGINAL POWER SUPPLY: - 110 / 220 VAC - 30 VAC CT (+/- 15 VAC) - X VDC (RECTIFIED) - +/- 12 VDC V(IN) = 9V V(OUT) = 2*V(IN) - 2*V(DIODE) = 2*9V - 2*0.7V = 16.6V V(OUT2) = V(OUT) - 2*V(DIODE) = 16.6V - 2*0.7V = 15.2V
SWEEP OFFSET
SWEEP RANGE
DEPTH
RATE
FEEDBACK
WIRE PADS ------------ E1 - INPUT E2 - GND E3 - SW NO (DRY) E4 - SW NC (WET) E5 - SW COM E6 - OUTPUT

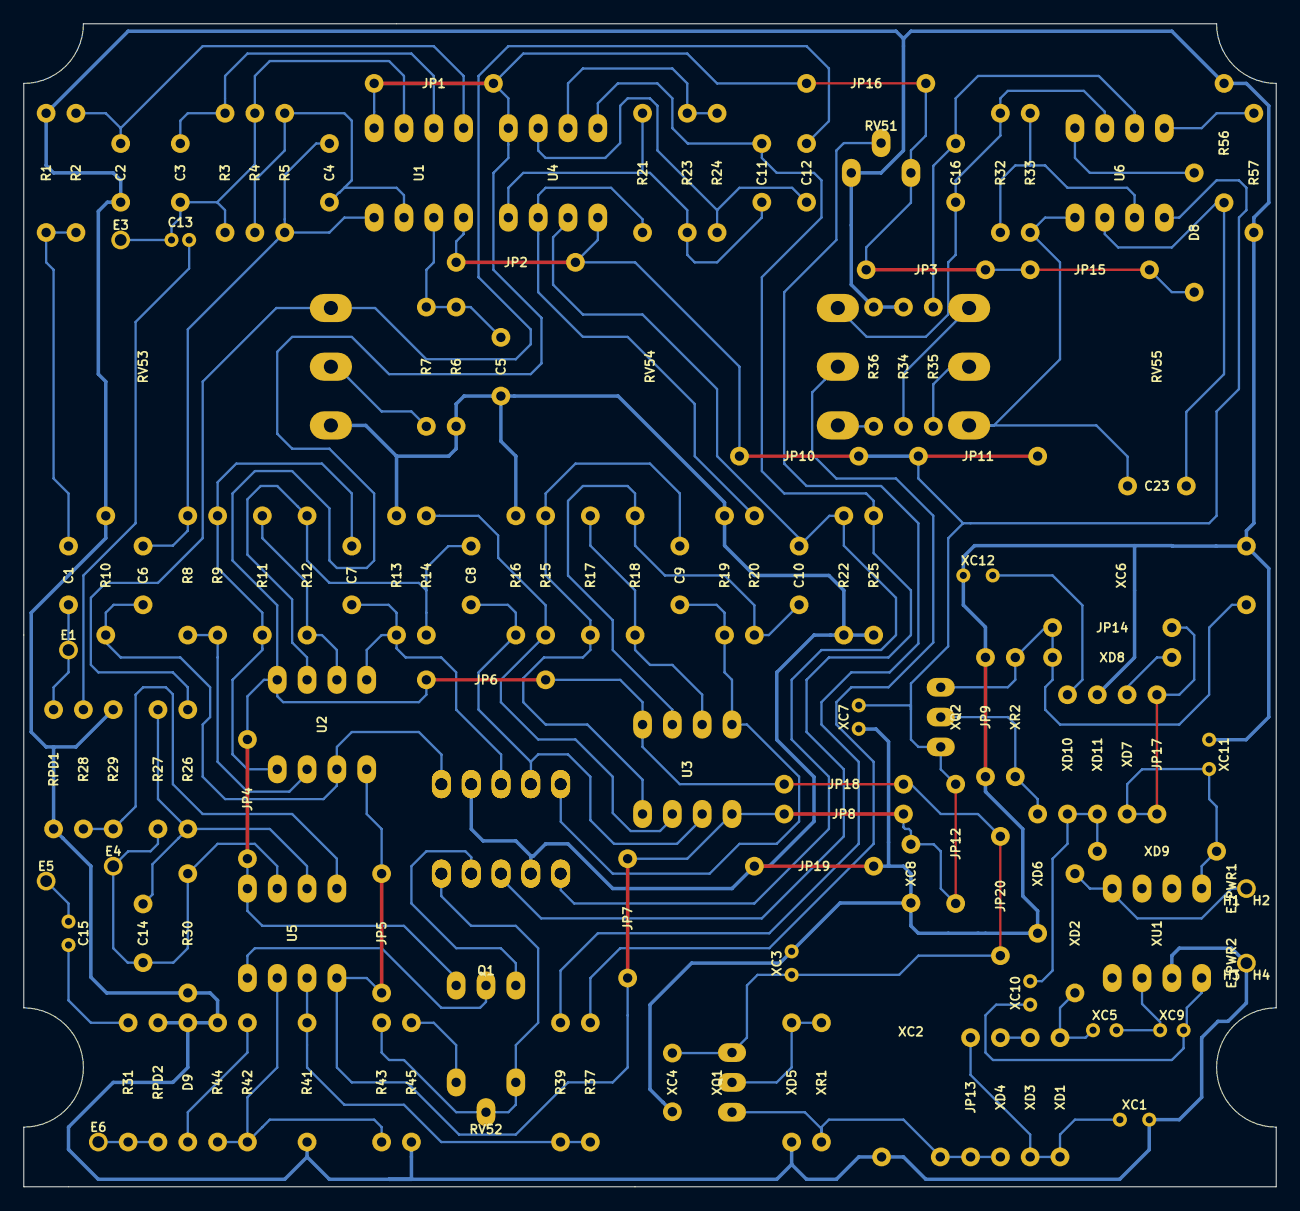
[picture p126: board PRJ-003 - Mu-Tron Phasor II/#110-000 - Phasor PCB/Design History/A/#1… from above]

Board: 2 copper layers, 106.7 x 99.1 mm, 140 parts (0 on the bottom side), 71 nets.
