420-enghighneering/projects-kicad/PRJ-003 - Mu-Tron Phasor II/#410-000 - Switching PCB/#410-000-X - Switching [Relay]/#410-000.kicad_pcb

## KiCad design PRJ-003 - Mu-Tron Phasor II/#410-000 - Switching PCB/#410-000-X - Switching [Relay]/#410-000.kicad_pcb (2021-03-29)

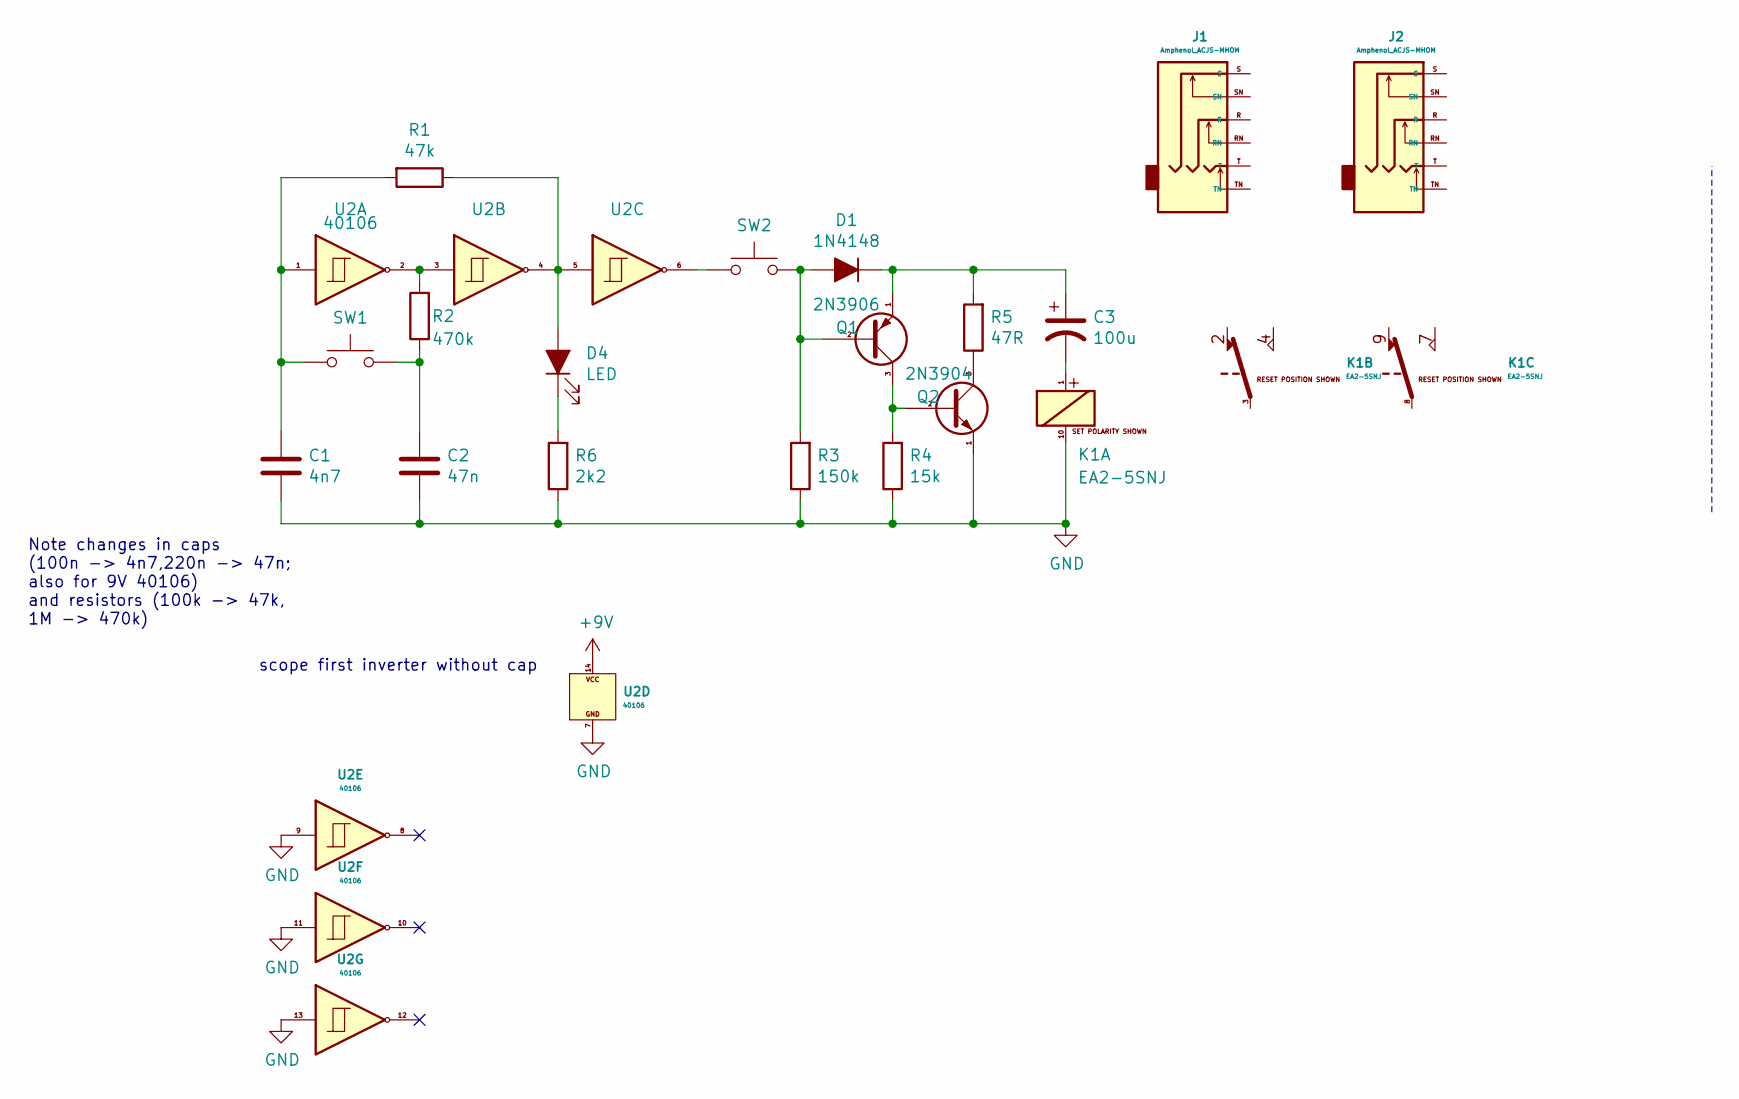
[picture p127: schematic #410-000.sch, PRJ-002: Bypass Switching Systems]

Parts:
C1: 4n7; C_FKS2G014701A00KSSD
C2: 47n; C_MKS2F024701C00KSSD
C3: 100u; C_UMA1V100MDD
D1: 1N4148; D_P10.16_DO35
D4: LED; E_WIRE_PAD_2x
J1, J2: Amphenol_ACJS-MHOM; J_AC
K1: EA2-5SNJ; U_DIP-10
Q1: 2N3906; Q_P2.54
Q2: 2N3904; Q_P2.54
R1: 47k; R_P10.16
R2: 470k; R_P10.16
R3: 150k; R_P10.16
R4: 15k; R_P10.16
R5: 47R; R_P10.16
R6: 2k2; R_P10.16
SW1, SW2: SW_Push; E_WIRE_PAD_2x
U2: 40106; Texas_Instruments_CD40106BE

Connections:
+9V: U2.14
GND: C1.2, C2.2, K1.10, Q2.1 (E), R3.1, R4.1, R6.1, U2.7, U2.9, U2.11, U2.13
unnamed: C1.1, R1.2, SW1.1, U2.1
unnamed: C2.1, R2.1, SW1.2
unnamed: C3.1, D1.2 (K), Q1.1 (E), R5.2
unnamed: C3.2, K1.1
unnamed: D1.1 (A), Q1.2 (B), R3.2, SW2.2
unnamed: D4.1 (K), R6.2
unnamed: D4.2 (A), R1.1, U2.4, U2.5
unnamed: Q1.3 (C), Q2.2 (B), R4.2
unnamed: Q2.3 (C), R5.1
unnamed: R2.2, U2.2, U2.3
unnamed: SW2.1, U2.6

Notes on the sheet:
scope first inverter without cap
Note changes in caps (100n -> 4n7,220n -> 47n; also for 9V 40106) and resistors (100k -> 47k, 1M -> 470k)

Board: 2 copper layers, 19 parts (0 on the bottom side), 12 nets, no tracks yet.
