420-enghighneering/projects-kicad/PRJ-003 - Mu-Tron Phasor II/#310-000 - Power Supply PCB/Powermodule - Zener Regulator/Powermodule - Zener Regulator.kicad_pcb

## KiCad design PRJ-003 - Mu-Tron Phasor II/#310-000 - Power Supply PCB/Powermodule - Zener Regulator/Powermodule - Zener Regulator.kicad_pcb (2021-03-29)

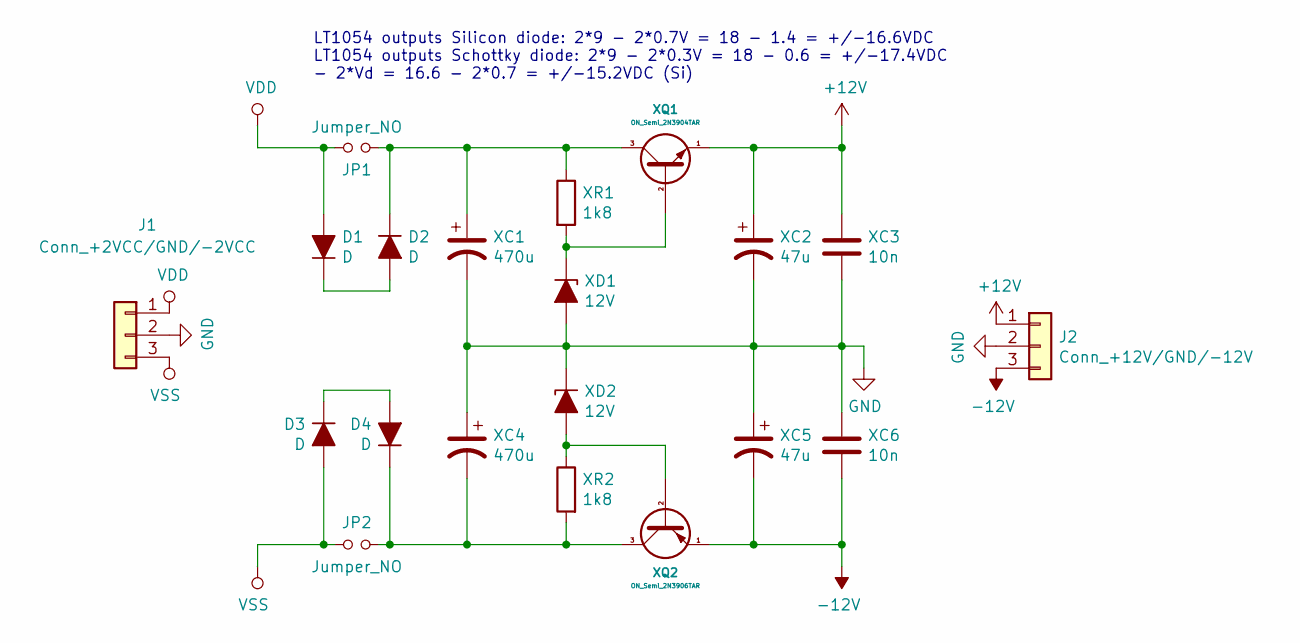
[picture p128: schematic Powermodule - Zener Regulator.sch]

Parts:
D1, D2, D3, D4: D; DO-41_P2.54
J1: Conn_+2VCC/GND/-2VCC; PinHeader_1x03_P2.54mm_Vertical_Top
J2: Conn_+12V/GND/-12V; PinHeader_1x03_P2.54mm_Vertical_Top
JP1, JP2: Jumper_NO; R_0R_Wire_Jumper_P2.54
XC1, XC4: 470u; Electrolytic_Radial_Angled_D10.0_H17.0_P5.0
XC2, XC5: 47u; 47uF_35V_8x5x2.5_UMA1V470MDD
XC3, XC6: 10n; Wima_FKS2G021001C00KSSD
XD1, XD2: 12V; DO-41_P2.54
XQ1: ON_Semi_2N3904TAR
XQ2: ON_Semi_2N3906TAR
XR1, XR2: 1k8; R_CC25_P2.54_V

Connections:
+12V: J2.1, XC2.1, XC3.1, XQ1.1 (E)
-12V: J2.3, XC5.2, XC6.2, XQ2.1 (E)
GND: J1.2, J2.2, XC1.2, XC2.2, XC3.2, XC4.1, XC5.1, XC6.1, XD1.1 (A), XD2.2 (K)
unnamed: D1.2 (K), D2.1 (A)
unnamed: D2.2 (K), JP1.2, XC1.1, XQ1.3 (C), XR1.1
unnamed: D3.2 (K), D4.1 (A)
unnamed: D4.2 (K), JP2.2, XC4.2, XQ2.3 (C), XR2.2
unnamed: XD1.2 (K), XQ1.2 (B), XR1.2
unnamed: XD2.1 (A), XQ2.2 (B), XR2.1
VDD: D1.1 (A), J1.1, JP1.1
VSS: D3.1 (A), J1.3, JP2.1

Notes on the sheet:
LT1054 outputs Silicon diode: 2*9 - 2*0.7V = 18 - 1.4 = +/-16.6VDC LT1054 outputs Schottky diode: 2*9 - 2*0.3V = 18 - 0.6 = +/-17.4VDC - 2*Vd = 16.6 - 2*0.7 = +/-15.2VDC (Si)

Board: 2 copper layers, 20 parts (0 on the bottom side), 11 nets, no tracks yet.
