420-enghighneering/projects-kicad/PRJ-003 - Mu-Tron Phasor II/#510-000 - Audio Jack PCB/#510-000-S3A - Audio Jack PCB [Pads LR]/#510-000.kicad_pcb

## KiCad design PRJ-003 - Mu-Tron Phasor II/#510-000 - Audio Jack PCB/#510-000-S3A - Audio Jack PCB [Pads LR]/#510-000.kicad_pcb (2021-03-29)

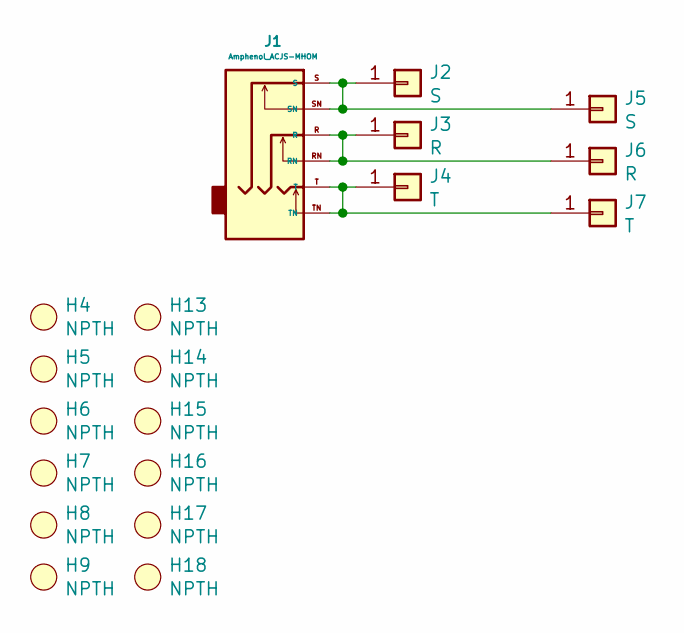
[picture p129: schematic #510-000.sch]

Parts:
H4, H5, H6, H7, H8, H9, H13, H14, H15, H16, H17, H18: NPTH; E_ZIPTIE_NPTH
J1: Amphenol_ACJS-MHOM; J_AC_NOCHASSIS
J2, J5: S; E_WIRE_PAD
J3, J6: R; E_WIRE_PAD
J4, J7: T; E_WIRE_PAD

Connections:
unnamed: J1.R, J1.RN, J3.1, J6.1
unnamed: J1.S, J1.SN, J2.1, J5.1
unnamed: J1.T, J1.TN, J4.1, J7.1

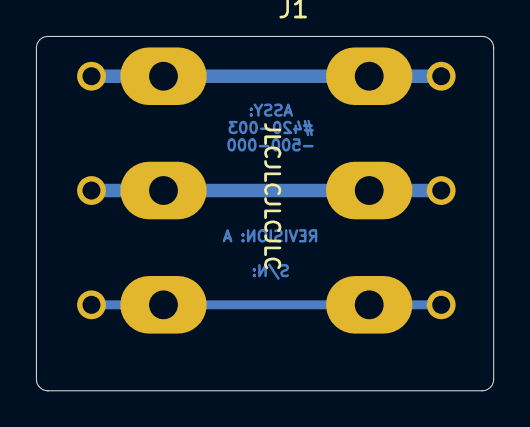
[picture p130: board #510-000.kicad_pcb from above]

Board: 2 copper layers, 25.4 x 19.7 mm, 19 parts (0 on the bottom side), 3 nets.
