420-enghighneering/projects-kicad/PRJ-003 - Mu-Tron Phasor II/#310-000 - Power Supply PCB/Powermodule - Bipolar 9V - MAX1044/Powermodule - Bipolar 9V - MAX1044.kicad_pcb

## KiCad design PRJ-003 - Mu-Tron Phasor II/#310-000 - Power Supply PCB/Powermodule - Bipolar 9V - MAX1044/Powermodule - Bipolar 9V - MAX1044.kicad_pcb (2021-03-29)

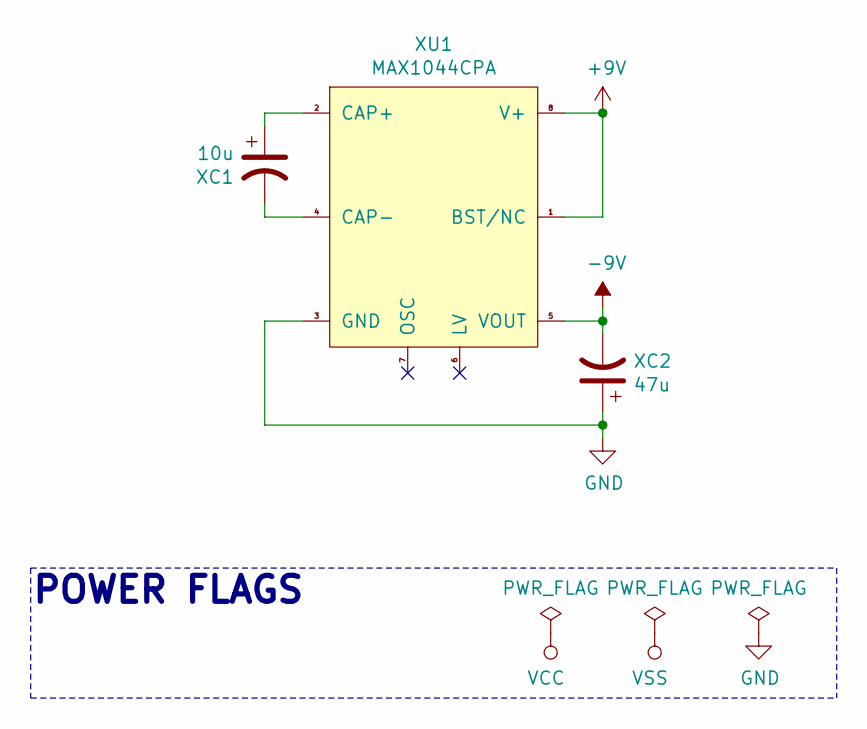
[picture p131: schematic Powermodule - Bipolar 9V - MAX1044.sch]

Parts:
XC1: 10u; Nichicon_UWT1V100MCL1GB
XC2: 47u; Nichicon_UWT1V470MCL1GS
XU1: MAX1044CPA

Connections:
+9V: XU1.1 (BST/NC), XU1.8 (V+)
-9V: XC2.2, XU1.5 (VOUT)
GND: XC2.1, XU1.3 (GND)
unnamed: XC1.1, XU1.2 (CAP+)
unnamed: XC1.2, XU1.4 (CAP-)

Notes on the sheet:
POWER FLAGS

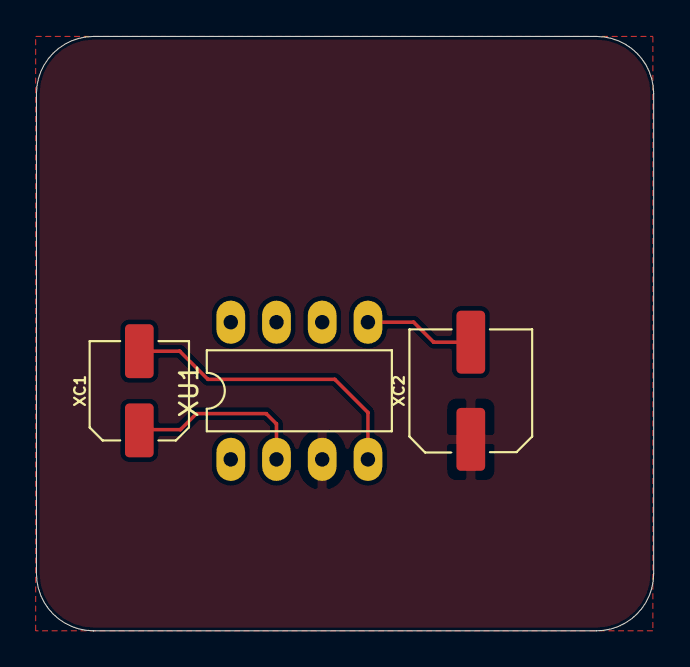
[picture p132: board Powermodule - Bipolar 9V - MAX1044.kicad_pcb from above]

Board: 2 copper layers, 34.3 x 33.0 mm, 3 parts (0 on the bottom side), 5 nets.
