420-enghighneering/projects-kicad/PRJ-003 - Mu-Tron Phasor II/Archive - Pre-Project/Musitronics Mu-Tron II Phaser/Board Reproduction/Photomodule - LDRs/Photomodule - LDRs.kicad_pcb

## KiCad design PRJ-003 - Mu-Tron Phasor II/Archive - Pre-Project/Musitronics Mu-Tron II Phaser/Board Reproduction/Photomodule - LDRs/Photomodule - LDRs.kicad_pcb (2021-03-29, an earlier design)

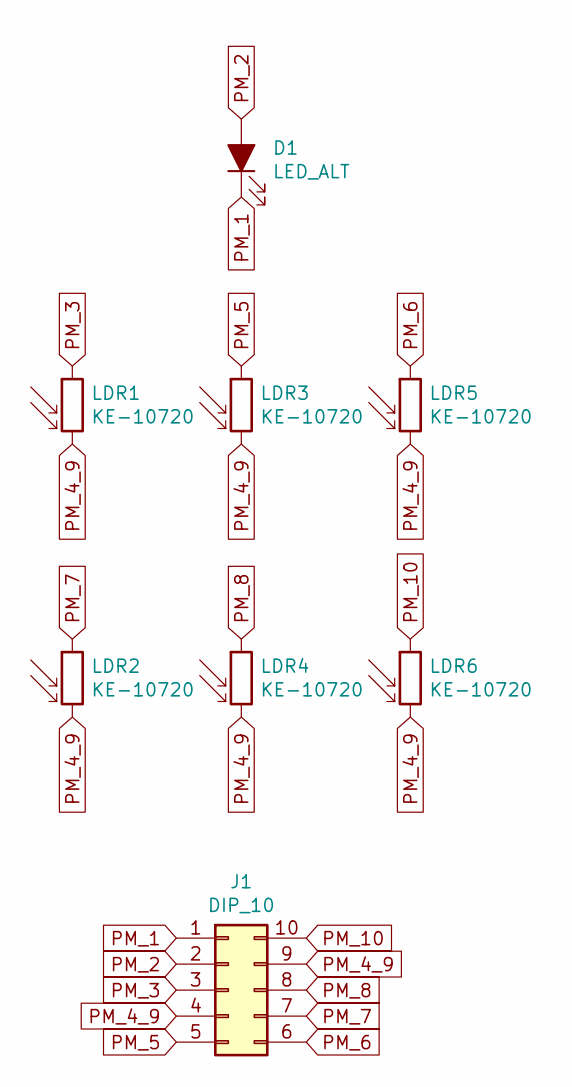
[picture p135: schematic Photomodule - LDRs.sch]

Parts:
D1: LED_ALT; DO-41_P2.54
J1: DIP_10; Photomodule
LDR1, LDR2, LDR3, LDR4, LDR5, LDR6: KE-10720; Waitrony_KE-10720

Connections:
PM_1: D1.1 (K), J1.1
PM_2: D1.2 (A), J1.2
PM_3: J1.3, LDR1.1
PM_4_9: J1.4, J1.9, LDR1.2, LDR2.2, LDR3.2, LDR4.2, LDR5.2, LDR6.2
PM_5: J1.5, LDR3.1
PM_6: J1.6, LDR5.1
PM_7: J1.7, LDR2.1
PM_8: J1.8, LDR4.1
PM_10: J1.10, LDR6.1

Board: 2 copper layers, 8 parts (0 on the bottom side), 9 nets, no tracks yet.
