420-enghighneering/projects-kicad/PRJ-003 - Mu-Tron Phasor II/#610-000 - Power Jack PCB/#610-000-A2 - Power Jack PCB [1614 09, Wide]/#610-000.kicad_pcb

## KiCad design PRJ-003 - Mu-Tron Phasor II/#610-000 - Power Jack PCB/#610-000-A2 - Power Jack PCB [1614 09, Wide]/#610-000.kicad_pcb (2021-03-29)

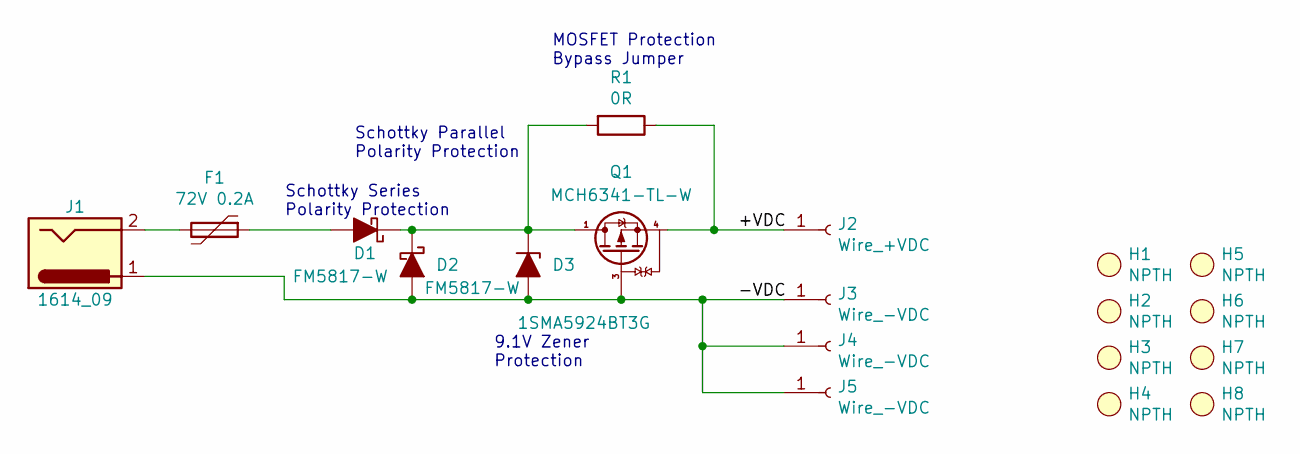
[picture p136: schematic #610-000.sch, #610-000-S1A]

Parts:
D1, D2: FM5817-W; Rectron_FM5817-W
D3: 1SMA5924BT3G; ON_Semi_1SMA5924BT3G
F1: 72V 0.2A; R_CC25_P5.08_V
H1, H2, H3, H4, H5, H6, H7, H8: NPTH; E_ZIPTIE_NPTH
J1: 1614_09; J_POWER_SMALL
J2: Wire_+VDC; E_WIRE_PAD
J3, J4, J5: Wire_-VDC; E_WIRE_PAD
Q1: MCH6341-TL-W; ON_Semi_MCH6341-TL-W
R1: 0R; R_0603_1608M

Connections:
/+VDC: J2.1, Q1.4 (S), R1.1
/-VDC: D2.1 (A), D3.1 (A), J1.1, J3.1, J4.1, J5.1, Q1.3 (G)
unnamed: D1.1 (A), F1.1
unnamed: D1.2 (K), D2.2 (K), D3.2 (K), Q1.1 (D), Q1.2 (D), Q1.5 (D), Q1.6 (D), R1.2
unnamed: F1.2, J1.2

Notes on the sheet:
9.1V Zener Protection
Schottky Series Polarity Protection
Schottky Parallel Polarity Protection
MOSFET Protection Bypass Jumper

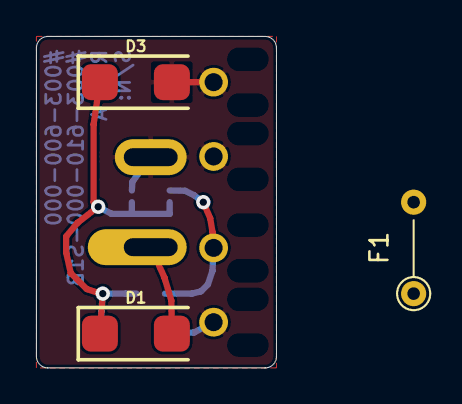
[picture p137: board #610-000.kicad_pcb from above]

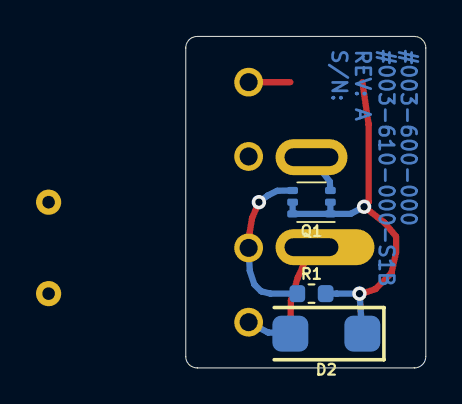
[picture p138: board #610-000.kicad_pcb from below]

Board: 2 copper layers, 13.3 x 18.4 mm, 19 parts (7 on the bottom side), 5 nets.
