420-enghighneering/projects-kicad/PRJ-003 - Mu-Tron Phasor II/#310-000 - Power Supply PCB/Powermodule - Bipolar 18V - LT1054/Powermodule - Bipolar 18V - LT1054.kicad_pcb

## KiCad design PRJ-003 - Mu-Tron Phasor II/#310-000 - Power Supply PCB/Powermodule - Bipolar 18V - LT1054/Powermodule - Bipolar 18V - LT1054.kicad_pcb (2021-03-29)

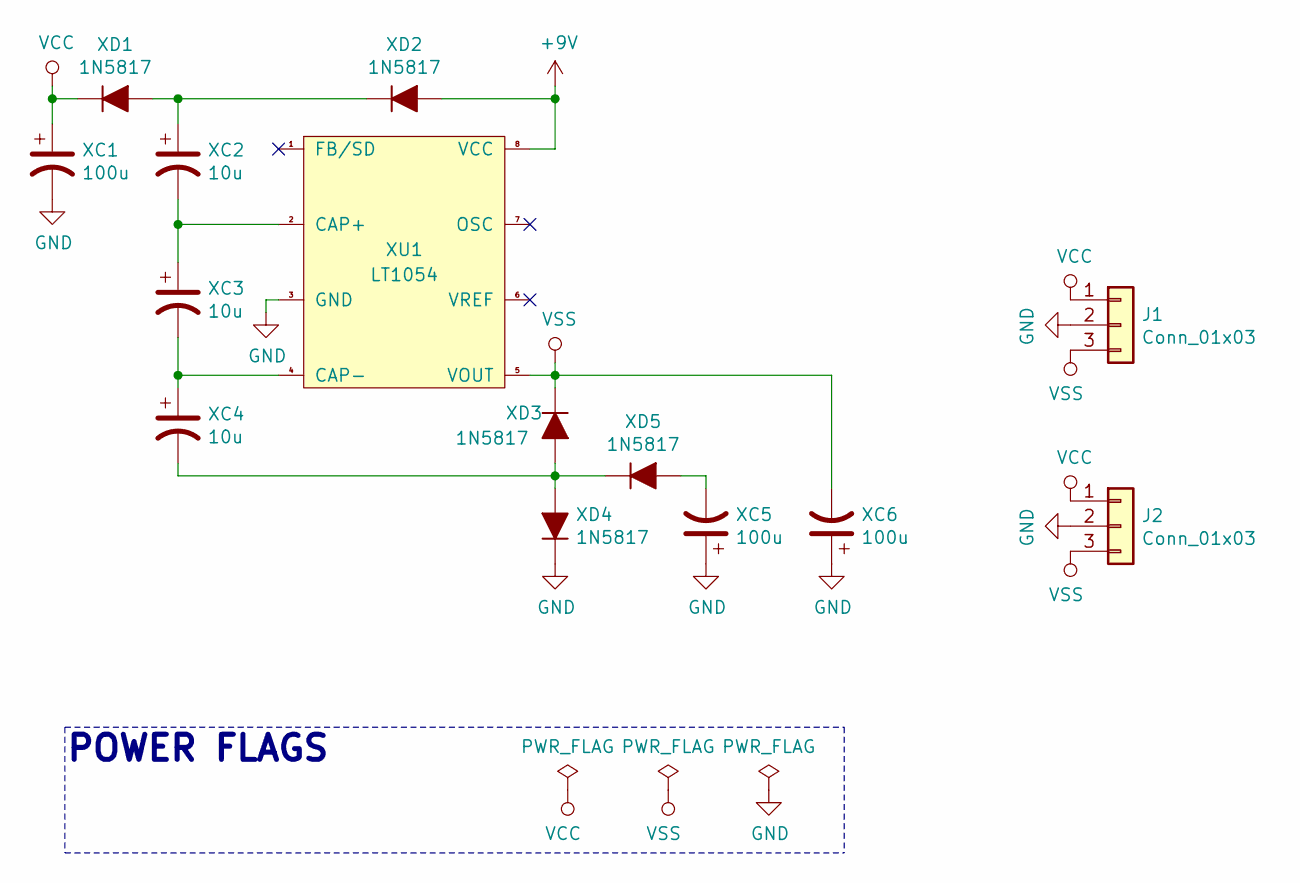
[picture p139: schematic Powermodule - Bipolar 18V - LT1054.sch]

Parts:
J1, J2: Conn_01x03; PinHeader_1x03_P2.54mm_Vertical_Top
XC1, XC5, XC6: 100u; Nichicon_UMA1E101MDD_100uF_P2.50_8.0x5.0mm
XC2, XC3, XC4: 10u; Nichicon_UMA1E100MDD_10uF_P2.00_5.0x5.0mm
XD1, XD2, XD3, XD4, XD5: 1N5817; DO-41_P10.16
XU1: LT1054

Connections:
+9V: XD2.1 (A), XU1.8 (VCC)
GND: J1.2, J2.2, XC1.2, XC5.1, XC6.1, XD4.2 (K), XU1.3 (GND)
unnamed: XC2.1, XD1.1 (A), XD2.2 (K)
unnamed: XC2.2, XC3.1, XU1.2 (CAP+)
unnamed: XC3.2, XC4.1, XU1.4 (CAP-)
unnamed: XC4.2, XD3.1 (A), XD4.1 (A), XD5.2 (K)
unnamed: XC5.2, XD5.1 (A)
VCC: J1.1, J2.1, XC1.1, XD1.2 (K)
VSS: J1.3, J2.3, XC6.2, XD3.2 (K), XU1.5 (VOUT)

Notes on the sheet:
POWER FLAGS

Board: 2 copper layers, 14 parts (2 on the bottom side), 9 nets, no tracks yet.
