420-enghighneering/projects-kicad/PRJ-003 - Mu-Tron Phasor II/Archive - Pre-Project/Musitronics Mu-Tron II Phaser/Master Schematic/#300-000 Reverse Polarity Protection PCBA/#300-000 Reverse Polarity Protection PCBA.kicad_pcb

## KiCad design PRJ-003 - Mu-Tron Phasor II/Archive - Pre-Project/Musitronics Mu-Tron II Phaser/Master Schematic/#300-000 Reverse Polarity Protection PCBA/#300-000 Reverse Polarity Protection PCBA.kicad_pcb (2021-03-29, an earlier design)

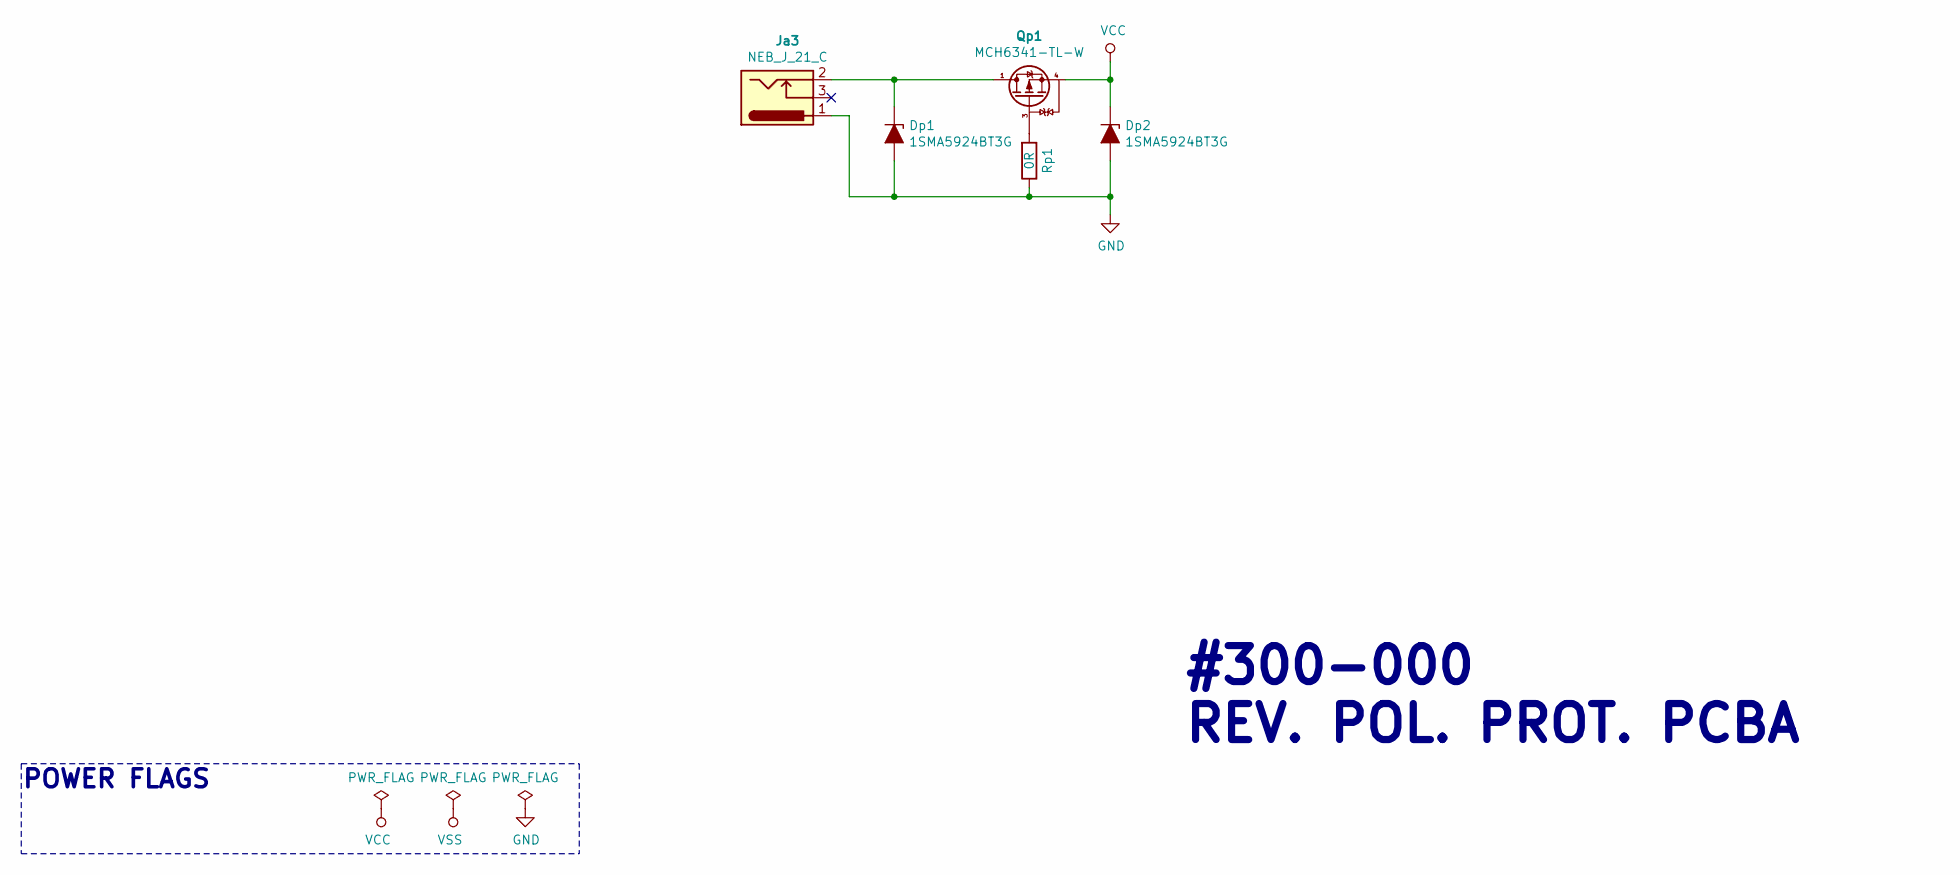
[picture p140: schematic #300-000 Reverse Polarity Protection PCBA.sch]

Parts:
Dp1, Dp2: 1SMA5924BT3G; ON_Semi_1SMA5924BT3G
Ja3: NEB_J_21_C; Lumberg_NEB_J_21_C
Qp1: MCH6341-TL-W; ON_Semi_MCH6341-TL-W
Rp1: 0R; R_0603_1608M

Connections:
GND: Dp1.1 (A), Dp2.1 (A), Ja3.1, Rp1.1
unnamed: Dp1.2 (K), Ja3.2, Qp1.1 (D), Qp1.2 (D), Qp1.5 (D), Qp1.6 (D)
unnamed: Qp1.3 (G), Rp1.2
VCC: Dp2.2 (K), Qp1.4 (S)

Notes on the sheet:
POWER FLAGS
#300-000 REV. POL. PROT. PCBA

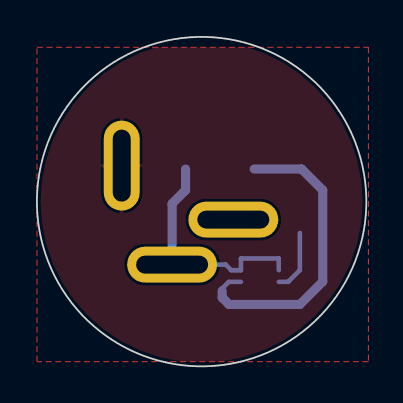
[picture p141: board #300-000 Reverse Polarity Protection PCBA.kicad_pcb from above]

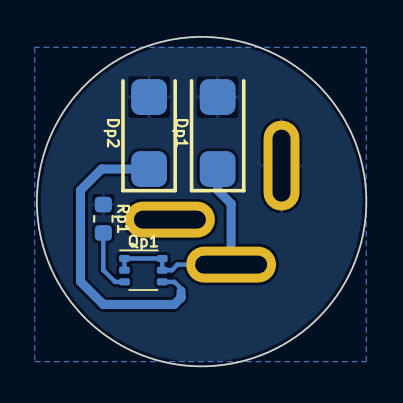
[picture p142: board #300-000 Reverse Polarity Protection PCBA.kicad_pcb from below]

Board: 2 copper layers, 18.3 x 18.3 mm, 5 parts (4 on the bottom side), 4 nets.
