420-enghighneering/projects-kicad/PRJ-003 - Mu-Tron Phasor II/#410-000 - Switching PCB/#410-000-S1A - Switching PCB [DPDT, Latching]/#410-000-S1A - Switching PCB [DPDT, Latching].kicad_pcb

## KiCad design PRJ-003 - Mu-Tron Phasor II/#410-000 - Switching PCB/#410-000-S1A - Switching PCB [DPDT, Latching]/#410-000-S1A - Switching PCB [DPDT, Latching].kicad_pcb (2021-03-29)

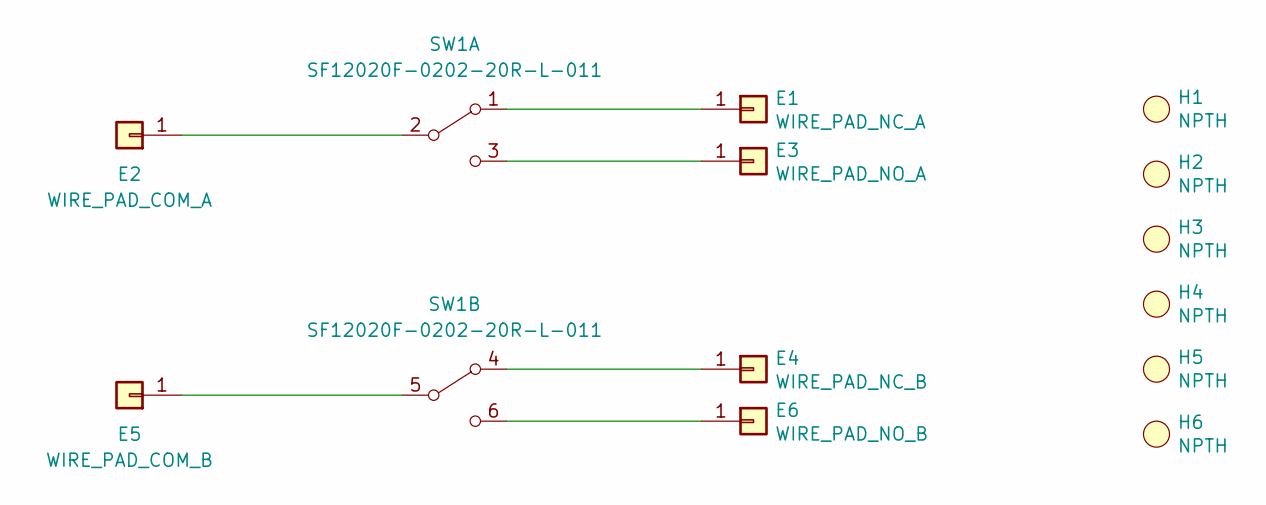
[picture p143: schematic #410-000-S1A - Switching PCB [DPDT, Latching].kicad_sch]

Parts:
E1: WIRE_PAD_NC_A; E_WIRE_PAD
E2: WIRE_PAD_COM_A; E_WIRE_PAD
E3: WIRE_PAD_NO_A; E_WIRE_PAD
E4: WIRE_PAD_NC_B; E_WIRE_PAD
E5: WIRE_PAD_COM_B; E_WIRE_PAD
E6: WIRE_PAD_NO_B; E_WIRE_PAD
H1, H2, H3, H4, H5, H6: NPTH; E_ZIPTIE_NPTH_2x_P2.54mm
SW1: SF12020F-0202-20R-L-011; SW_Alpha_Taiwan_SF12020F-0202-20R-L-011_BFCU

Connections:
unnamed: E1.1, SW1.1 (A)
unnamed: E2.1, SW1.2 (B)
unnamed: E3.1, SW1.3 (C)
unnamed: E4.1, SW1.4 (A)
unnamed: E5.1, SW1.5 (B)
unnamed: E6.1, SW1.6 (C)

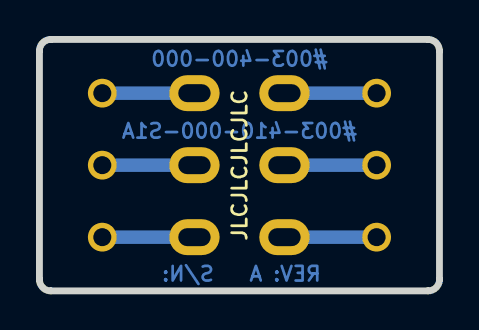
[picture p144: board #410-000-S1A - Switching PCB [DPDT, Latching].kicad_pcb from above]

Board: 2 copper layers, 22.2 x 14.0 mm, 13 parts (0 on the bottom side), 6 nets.
