420-enghighneering/projects-kicad/PRJ-003 - Mu-Tron Phasor II/#510-000 - Audio Jack PCB/#510-000-S2A - Audio Jack PCB [Output, Pads R]/#510-000-S2A - Audio Jack PCB [Output, Pads R].kicad_pcb

## KiCad design PRJ-003 - Mu-Tron Phasor II/#510-000 - Audio Jack PCB/#510-000-S2A - Audio Jack PCB [Output, Pads R]/#510-000-S2A - Audio Jack PCB [Output, Pads R].kicad_pcb (2021-03-29)

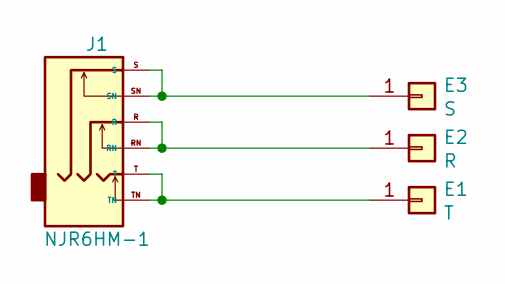
[picture p145: schematic #510-000-S2A - Audio Jack PCB [Output, Pads R].kicad_sch]

Parts:
E1: T; E_WIRE_PAD_1x_ZIPTIE_NPTH_2x_NARROW
E2: R; E_WIRE_PAD_1x_ZIPTIE_NPTH_2x_NARROW
E3: S; E_WIRE_PAD_1x_ZIPTIE_NPTH_2x_NARROW
J1: NJR6HM-1; J_AC_NOCHASSIS

Connections:
unnamed: E1.1, J1.T, J1.TN
unnamed: E2.1, J1.R, J1.RN
unnamed: E3.1, J1.S, J1.SN

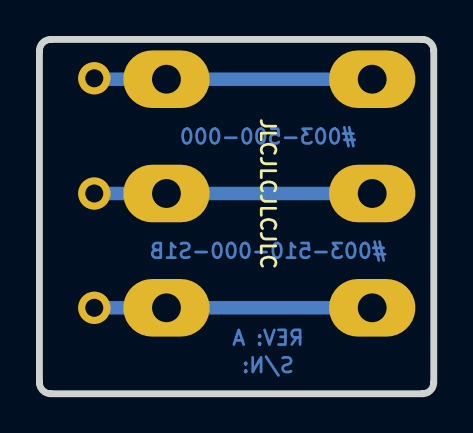
[picture p146: board #510-000-S2A - Audio Jack PCB [Output, Pads R].kicad_pcb from above]

Board: 2 copper layers, 21.9 x 19.7 mm, 4 parts (0 on the bottom side), 3 nets.
