420-enghighneering/projects-kicad/PRJ-003 - Mu-Tron Phasor II/#210-000 - Photomodule PCB/#210-000-S1A - Photomodule PCB [LDRs]/#210-000-S1A - Photomodule PCB [LDRs].kicad_sch

## KiCad design PRJ-003 - Mu-Tron Phasor II/#210-000 - Photomodule PCB/#210-000-S1A - Photomodule PCB [LDRs]/#210-000-S1A - Photomodule PCB [LDRs].kicad_sch (2021-03-29)

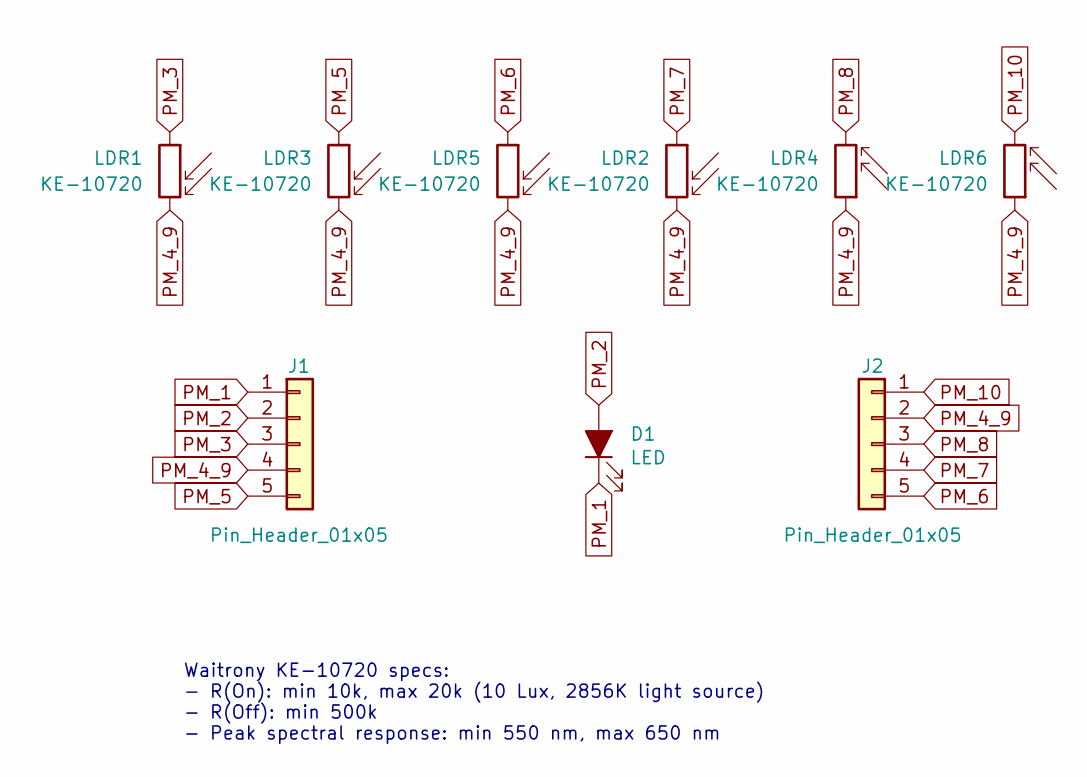
[picture p147: schematic #210-000-S1A - Photomodule PCB [LDRs].kicad_sch]

Parts:
D1: LED; D_LED
J1, J2: Pin_Header_01x05; E_HEADER_1x05_P2.54_SMALLERPADS
LDR1, LDR2, LDR3, LDR4, LDR5, LDR6: KE-10720; R_LDR_SMALLERPAD

Connections:
PM_1: D1.1 (K), J1.1
PM_2: D1.2 (A), J1.2
PM_3: J1.3, LDR1.1
PM_4_9: J1.4, J2.2, LDR1.2, LDR2.2, LDR3.2, LDR4.1, LDR5.2, LDR6.1
PM_5: J1.5, LDR3.1
PM_6: J2.5, LDR5.1
PM_7: J2.4, LDR2.1
PM_8: J2.3, LDR4.2
PM_10: J2.1, LDR6.2

Notes on the sheet:
Waitrony KE-10720 specs: - R(On): min 10k, max 20k (10 Lux, 2856K light source) - R(Off): min 500k - Peak spectral response: min 550 nm, max 650 nm
