420-enghighneering/projects-kicad/PRJ-003 - Mu-Tron Phasor II/#210-000 - Photomodule PCB/#210-000-S2A - Photomodule [Vactrols]/Photomodule - Vactrols.sch

## KiCad design PRJ-003 - Mu-Tron Phasor II/#210-000 - Photomodule PCB/#210-000-S2A - Photomodule [Vactrols]/Photomodule - Vactrols.sch (2021-03-29)

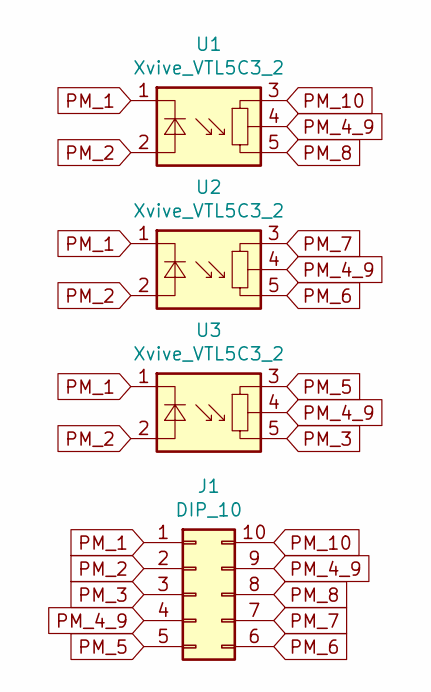
[picture p148: schematic Photomodule - Vactrols.sch]

Parts:
J1: DIP_10; Texas_Instruments_RC4558P
U1, U2, U3: Xvive_VTL5C3_2

Connections:
PM_1: J1.1, U1.1 (-), U2.1 (-), U3.1 (-)
PM_2: J1.2, U1.2 (+), U2.2 (+), U3.2 (+)
PM_3: J1.3, U3.5
PM_4_9: J1.4, J1.9, U1.4, U2.4, U3.4
PM_5: J1.5, U3.3
PM_6: J1.6, U2.5
PM_7: J1.7, U2.3
PM_8: J1.8, U1.5
PM_10: J1.10, U1.3
