420-enghighneering/projects-kicad/PRJ-003 - Mu-Tron Phasor II/#110-000 - Phasor PCB/#110-000-S1A - Phasor PCB [r]/Assembly Drawings/#110-000-S1A - Phasor PCB.kicad_sch

## KiCad design PRJ-003 - Mu-Tron Phasor II/#110-000 - Phasor PCB/#110-000-S1A - Phasor PCB [r]/Assembly Drawings/#110-000-S1A - Phasor PCB.kicad_sch (2021-03-29)

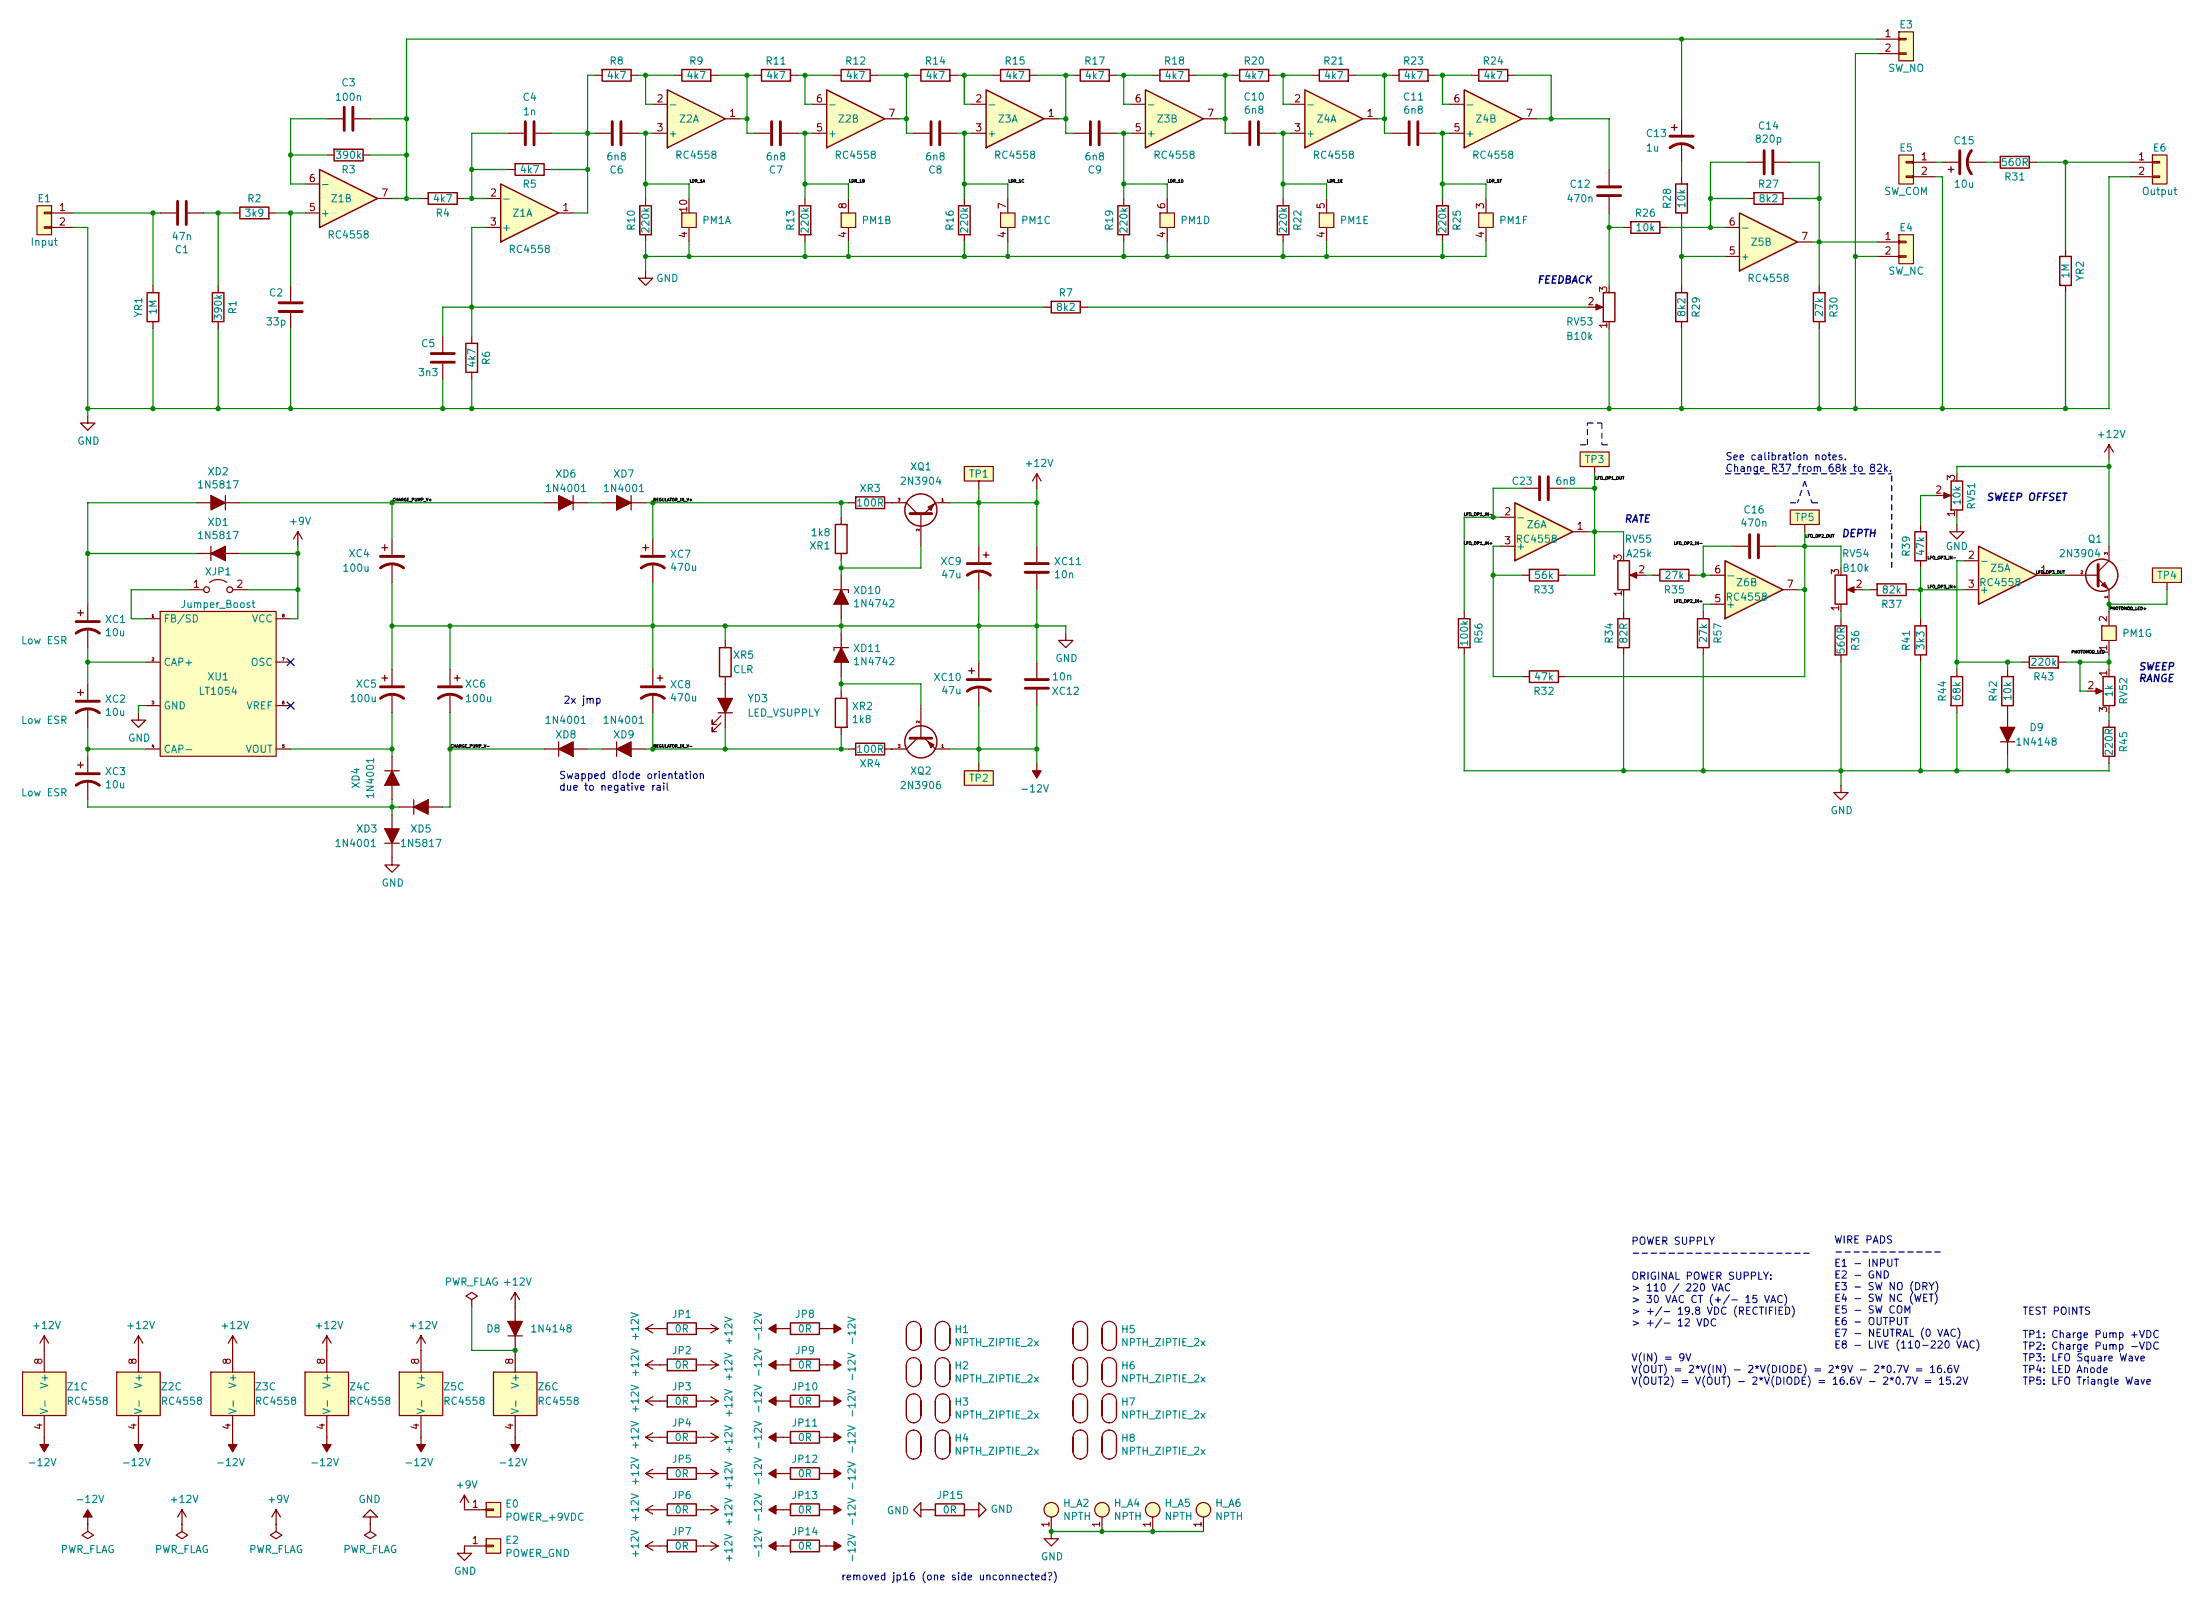
[picture p149: schematic #110-000-S1A - Phasor PCB.kicad_sch]

Parts:
C1: 47n; C_MKS2F024701C00KSSD
C2: 33p; C_FKP2O100331D00JSSD
C3: 100n; C_MKS2C031001A00KSSD
C4: 1n; C_FKS2G011001A00KSSD
C5: 3n3; C_FKS2G013301A00KSSD
C6, C7, C8, C9, C10, C11, C23: 6n8; C_FKS2G016801B00KSSD
C12, C16: 470n; C_MKS2C034701C00KSSD
C13: 1u; C_UMA1H010MDD
C14: 820p; C_FKP2J008201D00HSSD
C15: 10u; C_UMA1V100MDD
D8, D9: 1N4148; D_P10.16_DO35
E0: POWER_+9VDC; E_WIRE_PAD_1x_ZIPTIE_NPTH_2x
E1: Input; E_WIRE_PAD_1x_SHIELD_PAD_1x_ZIPTIE_NPTH_2x
E2: POWER_GND; E_WIRE_PAD_1x_ZIPTIE_NPTH_2x
E3: SW_NO; E_WIRE_PAD_1x_SHIELD_PAD_1x_ZIPTIE_NPTH_2x
E4: SW_NC; E_WIRE_PAD_1x_SHIELD_PAD_1x_ZIPTIE_NPTH_2x
E5: SW_COM; E_WIRE_PAD_1x_SHIELD_PAD_1x_ZIPTIE_NPTH_2x
E6: Output; E_WIRE_PAD_1x_SHIELD_PAD_1x_ZIPTIE_NPTH_2x
H1, H2, H3, H4, H5, H6, H7, H8: NPTH_ZIPTIE_2x; E_ZIPTIE_NPTH_2x_P2.54mm
H_A2, H_A4, H_A5, H_A6: NPTH; E_MH_PAD_M3_VIA_HEXSPACER
JP1, JP2, JP3, JP4, JP5, JP6, JP7, JP8, JP9, JP10, JP11, JP12, JP13, JP14, JP15: 0R; R_0R_JUMPER_P10.16
PM1: Photomodule; PM_DIP-10
Q1: 2N3904; Q_P2.54
R1, R3: 390k; R_CF_P10.16_390k
R2: 3k9; R_CF_P10.16_3k9
R4, R5, R6, R8, R9, R11, R12, R14, R15, R17, R18, R20, R21, R23, R24: 4k7; R_CF_P10.16_4k7
R7, R27, R29: 8k2; R_CF_P10.16_8k2
R10, R13, R16, R19, R22, R25, R43: 220k; R_CF_P10.16_220k
R26, R28, R42: 10k; R_CF_P10.16_10k
R30, R35, R57: 27k; R_CF_P10.16_27k
R31, R36: 560R; R_CF_P10.16_560R
R32, R39: 47k; R_CF_P10.16_47k
R33: 56k; R_CF_P10.16_56k
R34: 82R; R_CF_P10.16_82R
R37: 82k; R_CF_P10.16_82k
R41: 3k3; R_CF_P10.16_3k3
R44: 68k; R_CF_P10.16_68k
R45: 220R; R_CF_P10.16_220R
R56: 100k; R_CF_P10.16_100k
RV51: 10k; R_TRIM
RV52: 1k; R_TRIM
RV53, RV54: B10k; R_POT
RV55: A25k; R_POT
TP1: TP1; TP_SMD_R_3mm
TP2: TP2; TP_SMD_R_3mm
TP3: TP3; TP_SMD_R_3mm
TP4, TP5: TP5; TP_SMD_R_3mm
XC1, XC2, XC3: 10u; C_UMA1V100MDD
XC4, XC5, XC6: 100u; C_UMA1E101MDD
XC7, XC8: 470u; C_ANGLED
XC9, XC10: 47u; C_UMA1V470MDD
XC11, XC12: 10n; C_FKS2G021001C00KSSD
XD1, XD2, XD5: 1N5817; D_P10.16_5817
XD3, XD4, XD6, XD7, XD8, XD9: 1N4001; D_P10.16_4001
XD10, XD11: 1N4742; D_P10.16_DO35
XJP1: Jumper_Boost; R_0603_1608M
XQ1: 2N3904; Q_P2.54
XQ2: 2N3906; Q_P2.54
XR1, XR2: 1k8; R_CF_P10.16_1k8
XR3, XR4: 100R; R_CF_P10.16_100R
XR5: CLR; R_CF_P10.16_2k2
XU1: LT1054; U_DIP-8_LT1054_SOCKETED
YD3: LED_VSUPPLY; E_WIRE_PAD_2x_ZIPTIE_NPTH_2x_CIRC
YR1, YR2: 1M; R_CF_P10.16_1M
Z1, Z2, Z3, Z4, Z5, Z6: RC4558; U_DIP-8

Connections:
+9V: E0.1, XD1.1 (A), XJP1.2 (B), XU1.8 (VCC)
+12V: D8.1 (A), JP1.1, JP1.2, JP2.1, JP2.2, JP3.1, JP3.2, JP4.1, JP4.2, JP5.1, JP5.2, JP6.1, JP6.2, JP7.1, JP7.2, Q1.3 (C), RV51.3, TP1.1, XC9.1, XC11.1, XQ1.1 (E), Z1.8 (V+), Z2.8 (V+), Z3.8 (V+), Z4.8 (V+), Z5.8 (V+)
-12V: JP8.1, JP8.2, JP9.1, JP9.2, JP10.1, JP10.2, JP11.1, JP11.2, JP12.1, JP12.2, JP13.1, JP13.2, JP14.1, JP14.2, TP2.1, XC10.2, XC12.1, XQ2.1 (E), Z1.4 (V-), Z2.4 (V-), Z3.4 (V-), Z4.4 (V-), Z5.4 (V-), Z6.4 (V-)
CHARGE_PUMP_V+: XC4.1, XD2.2 (K), XD6.1 (A)
CHARGE_PUMP_V-: XC6.2, XD5.1 (A), XD8.2 (K)
GND: C2.2, C5.2, D9.2 (K), E1.2, E2.1, E3.2, E4.2, E5.2, E6.2, H_A2.1, H_A4.1, H_A5.1, H_A6.1, JP15.1, JP15.2, PM1.4, PM1.9, R1.2, R6.1, R10.2, R13.2, R16.2, R19.2, R22.1, R25.1, R29.2, R30.1, R34.2, R36.2, R41.1, R44.2, R45.1, R56.2, R57.2, RV51.1, RV53.1, XC4.2, XC5.1, XC6.1, XC7.2, XC8.1, XC9.2, XC10.1, XC11.2, XC12.2, XD3.2 (K), XD10.1 (A), XD11.2 (K), XR5.2, XU1.3 (GND), YR1.1, YR2.2
LDR_1A: C6.2, PM1.10, R10.1, Z2.3 (+)
LDR_1B: C7.2, PM1.8, R13.1, Z2.5 (+)
LDR_1C: C8.2, PM1.7, R16.1, Z3.3 (+)
LDR_1D: C9.2, PM1.6, R19.1, Z3.5 (+)
LDR_1E: C10.1, PM1.5, R22.2, Z4.3 (+)
LDR_1F: C11.1, PM1.3, R25.2, Z4.5 (+)
LFO_OP1_IN+: R32.1, R33.2, Z6.3 (+)
LFO_OP1_IN-: C23.1, R56.1, Z6.2 (-)
LFO_OP1_OUT: C23.2, R33.1, RV55.3, TP3.1, Z6.1
LFO_OP2_IN+: R57.1, Z6.5 (+)
LFO_OP2_IN-: C16.1, R35.2, Z6.6 (-)
LFO_OP2_OUT: C16.2, R32.2, RV54.3, TP5.1, Z6.7
LFO_OP3_IN+: R37.1, R39.1, R41.2, R42.1, R43.1, R44.1, Z5.2 (-), Z5.3 (+)
LFO_OP3_OUT: Q1.2 (B), Z5.1
unnamed: C1.1, R1.1, R2.1
unnamed: C1.2, E1.1, YR1.2
unnamed: C2.1, R2.2, Z1.5 (+)
unnamed: C3.2, R3.2, Z1.6 (-)
unnamed: C4.1, C6.1, R5.1, R8.2, Z1.1
unnamed: C4.2, R4.1, R5.2, Z1.2 (-)
unnamed: C5.1, R6.2, R7.2, Z1.3 (+)
unnamed: C7.1, R9.2, R11.1, Z2.1
unnamed: C8.1, R12.2, R14.1, Z2.7
unnamed: C9.1, R15.2, R17.1, Z3.1
unnamed: C10.2, R18.2, R20.1, Z3.7
unnamed: C11.2, R21.2, R23.1, Z4.1
unnamed: C12.1, R24.1, Z4.7
unnamed: C12.2, R26.2, RV53.3
unnamed: C3.1, C13.1, E3.1, R3.1, R4.2, Z1.7
unnamed: C13.2, R28.2
unnamed: C14.1, R26.1, R27.2, Z5.6 (-)
unnamed: C14.2, E4.1, R27.1, R30.2, Z5.7
unnamed: C15.1, E5.1
unnamed: C15.2, R31.2
unnamed: D8.2 (K), Z6.8 (V+)
unnamed: D9.1 (A), R42.2
unnamed: E6.1, R31.1, YR2.1
unnamed: R7.1, RV53.2
unnamed: R8.1, R9.1, Z2.2 (-)
unnamed: R11.2, R12.1, Z2.6 (-)
unnamed: R14.2, R15.1, Z3.2 (-)
unnamed: R17.2, R18.1, Z3.6 (-)
unnamed: R20.2, R21.1, Z4.2 (-)
unnamed: R23.2, R24.2, Z4.6 (-)
unnamed: R28.1, R29.1, Z5.5 (+)
unnamed: R34.1, RV55.1
unnamed: R35.1, RV55.2
unnamed: R36.1, RV54.1
unnamed: R37.2, RV54.2
unnamed: R39.2, RV51.2
unnamed: R45.2, RV52.3
unnamed: XC1.1, XD1.2 (K), XD2.1 (A)
unnamed: XC1.2, XC2.1, XU1.2 (CAP+)
unnamed: XC2.2, XC3.1, XU1.4 (CAP-)
unnamed: XC3.2, XD3.1 (A), XD4.1 (A), XD5.2 (K)
unnamed: XC5.2, XD4.2 (K), XU1.5 (VOUT)
unnamed: XD6.2 (K), XD7.1 (A)
unnamed: XD8.1 (A), XD9.2 (K)
unnamed: XD10.2 (K), XQ1.2 (B), XR1.1
unnamed: XD11.1 (A), XQ2.2 (B), XR2.1
unnamed: XJP1.1 (A), XU1.1 (FB/SD)
unnamed: XQ1.3 (C), XR3.1
unnamed: XQ2.3 (C), XR4.1
unnamed: XR5.1, YD3.2 (A)
PHOTOMOD_LED+: PM1.2, Q1.1 (E), TP4.1
PHOTOMOD_LED-: PM1.1, R43.2, RV52.1, RV52.2
REGULATOR_IN_V+: XC7.1, XD7.2 (K), XR1.2, XR3.2
REGULATOR_IN_V-: XC8.2, XD9.1 (A), XR2.2, XR4.2, YD3.1 (K)

Notes on the sheet:
Swapped diode orientation due to negative rail
2x jmp
removed jp16 (one side unconnected?)
FEEDBACK
RATE
POWER SUPPLY -------------------- ORIGINAL POWER SUPPLY: > 110 / 220 VAC > 30 VAC CT (+/- 15 VAC) > +/- 19.8 VDC (RECTIFIED) > +/- 12 VDC V(IN) = 9V V(OUT) = 2*V(IN) - 2*V(DIODE) = 2*9V - 2*0.7V = 16.6V V(OUT2) = V(OUT) - 2*V(DIODE) = 16.6V - 2*0.7V = 15.2V
See calibration notes. Change R37 from 68k to 82k.
WIRE PADS ------------ E1 - INPUT E2 - GND E3 - SW NO (DRY) E4 - SW NC (WET) E5 - SW COM E6 - OUTPUT E7 - NEUTRAL (0 VAC) E8 - LIVE (110-220 VAC)
DEPTH
SWEEP OFFSET
TEST POINTS TP1: Charge Pump +VDC TP2: Charge Pump -VDC TP3: LFO Square Wave TP4: LED Anode TP5: LFO Triangle Wave
SWEEP RANGE
